mstevanin4/ECU_STM_V1/bimmerTuning/pinout_BMW_diag_connector.png

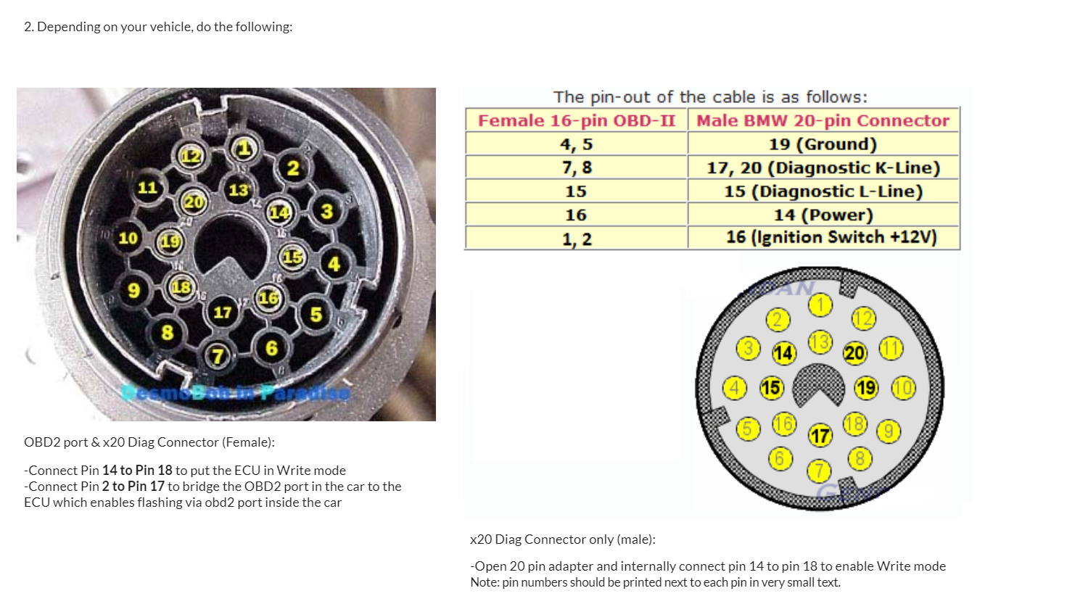
bimmerTuning/pinout_BMW_diag_connector.png
