mstevanin4/ECU_STM_V1/bimmerTuning/pinout_MS41_for_bench_flash.png

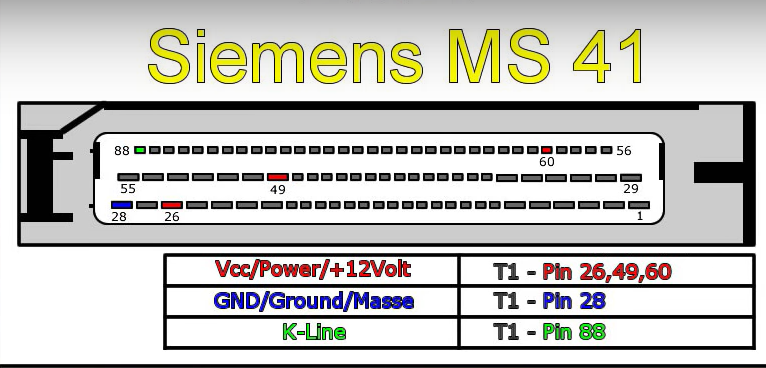
bimmerTuning/pinout_MS41_for_bench_flash.png
