mstevanin4/ECU_STM_V1/bimmerTuning/pinout_OBD2.png

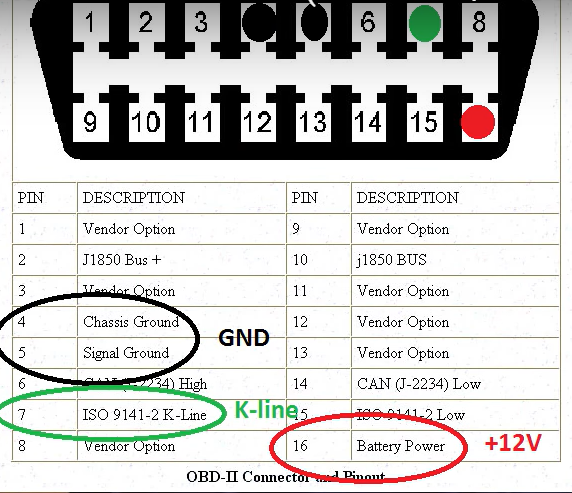
bimmerTuning/pinout_OBD2.png
