mstevanin4/ECU_STM_V1/STM2_ECU/HW/documentation/flyer.bmp

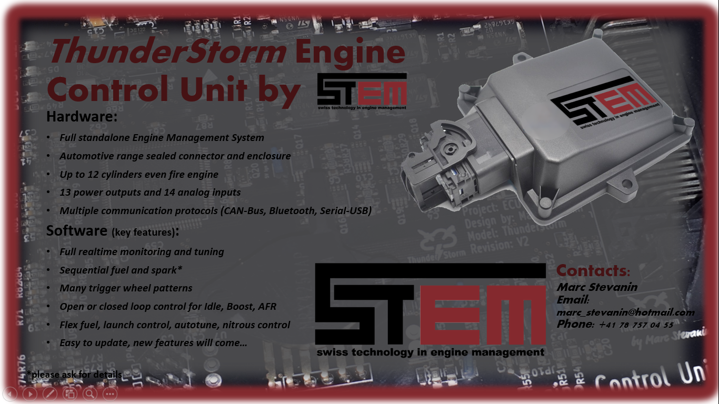
STM2_ECU/HW/documentation/flyer.bmp
