mstevanin4/ECU_STM_V1/STM2_ECU/HW/documentation/Sans titre.png

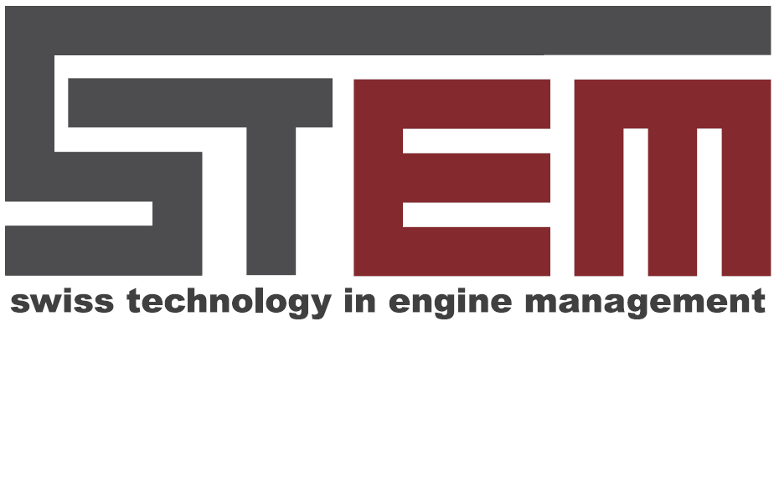
STM2_ECU/HW/documentation/Sans titre.png
