mstevanin4/ECU_STM_V1/STM2_ECU/HW/picture/20180507_184302.jpg

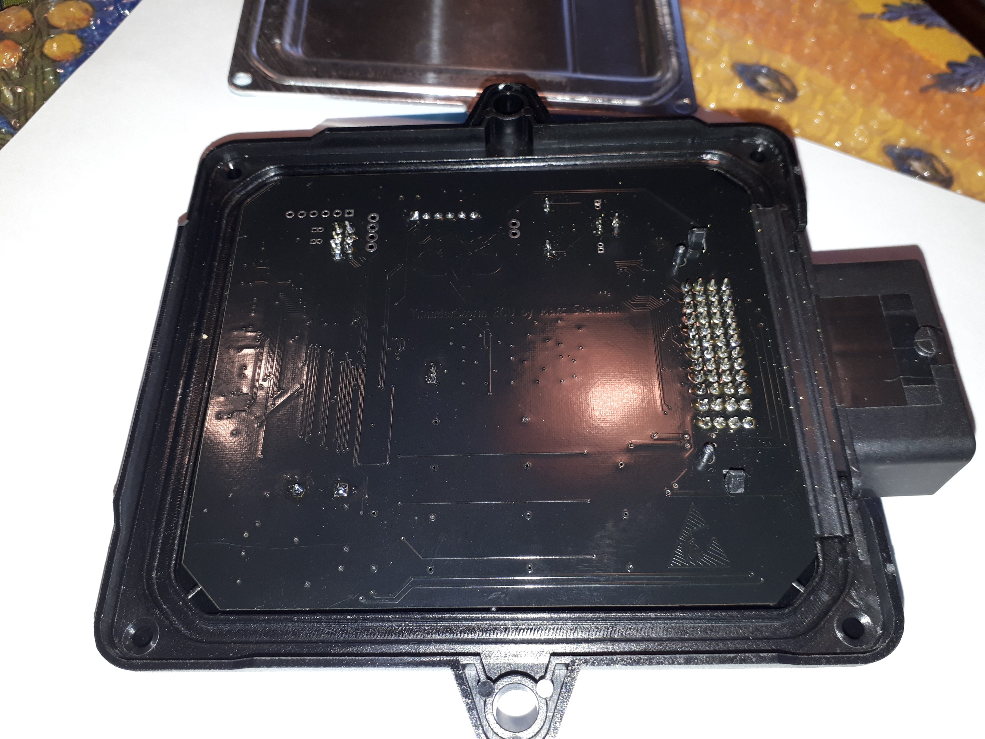
STM2_ECU/HW/picture/20180507_184302.jpg
