mstevanin4/ECU_STM_V1/STM2_ECU/HW/Trigger_improvement.png

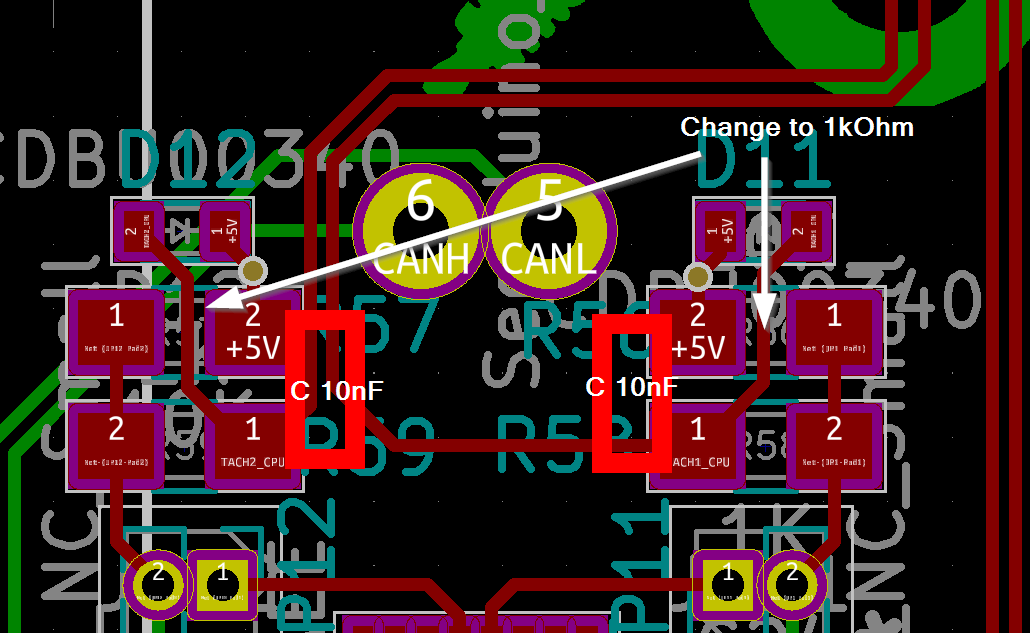
STM2_ECU/HW/Trigger_improvement.png
