mstevanin4/ECU_STM_V1/STM2_ECU/HW/man_files/BOM_SZ2U.xls

Sheet: Read me
Note:
1. The blue fields must be fulfilled before uploaded. Filling out the BOM Completely will facilitate the quotation.
2. Reference Link from Digikey, Mouser, Farnell,Arrow, Avenet or ShenZhen2U.com is strongly suggested. If the part are available in our shop, please copy the link in the "Reference Link".
3.Component values should be clear e.g. 100R, 100K, 100M etc, and not just "100" printed as the value.
4.BOMs must clearly identify parts are supplied by either "Customer", "SZ2U" or "No Need".
5.If you are going to sourcing and assembling with us,component must be supplied with extra (spare) parts to allow for losses and wastage. 5% extra spares is a reasonable guideline.Surplus parts will be returned.
6.We will respond with your BOM pricing within two to four working days of receiving it.Depending on suppliers responding with pricing for rare or bespoke items,so we cannot give a precise turnaround time for quote.
7.We are not taking any responsibility for your BOM files, please make sure that they are clear and accurate.
Blue fields | Should be filled out by customer.
Green fields | will be calculated and filled autolly.
After fulfilled and checked by yourself,save this file as .xls or .xlsx (not PDF), and send it to pcb@shenzhen2u.com

Sheet: BOM
 |  |  |  | BOM & Assembly Template
 | Custom Name: | Marc Stevanin |  |  | Project Name: | ECU_STM |  |  | Sale: | Iver
 | Company Name: | Atelier Stevanin |  |  | BOM Quantity: | 1 |  |  | Email: | pcb@shenzhen2u.com
 | Address: | Ruelle de la Laiterie 2 |  |  |  |  |  |  | Quotation ID:
 |  | 1438 Mathod |  |  |  |  |  |  | Date: | 2018-03-30
 | Email: | marc_stevanin@hotmail.com |  |  | Quotation for: | BOM & Assembly |  |  | Currency: | EUR
 | Tel: | 41787570455
# | Part ID / Reference | Manufacturer | Manufacture Part Number | Description | Value | Package | Reference Link | Alternate | THT/SMD/ No-Lead Pads | Pins / Pads | Quantity per BOM | Spare (%) | Need Qty | supplied by
1 | C22, C23 |  | GRM1885C1H102JA01D |  | 1nF | 0603 | https://www.mouser.ch/ProductDetail/Murata-Electronics/GRM1885C1H102JA01D | - | SMD | 2 | 2 | 5 | 3 | Customer
2 | C3, C4, C7, C8, C11, C12, C14, C15, C24, C25, C26, C27, C30, C31, C36, C37, C44, C51, C50, C45, C55, C54, C35, C34, C43, C42, C59, C60, C61, C62, C63, C58 |  | GRM188R71H104KA93D |  | 100nF | 0603 | https://www.mouser.ch/ProductDetail/Murata-Electronics/GRM188R71H104KA93D | - | SMD | 2 | 32 | 5 | 37 | SZ2U
3 | C32, C40, C41, C48, C53, C52, C49, C57, C56, C39, C38, C47, C46 |  | GRM188F51H224ZA01J |  | 220nF | 0603 | https://www.mouser.ch/ProductDetail/Murata-Electronics/GRM188F51H224ZA01J | - | SMD | 2 | 13 | 5 | 18 | No Need
4 | C33 |  | GRM188R71H472KA01D |  | 4nF7 | 0603 | https://www.mouser.ch/ProductDetail/Murata-Electronics/GRM188R71H472KA01D |  | SMD | 2 | 1 | 5 | 6
5 | C13 |  | UMK325AB7106KMHT |  | 10µF | 1210 | https://www.mouser.ch/ProductDetail/Taiyo-Yuden/UMK325AB7106KMHT |  | SMD | 2 | 1 | 5 | 6
6 | C1, C2, C6, C9, C5, C10, C21, C28 |  | GRM188R61H105KAALD |  | 1µF | 0603 | https://www.mouser.ch/ProductDetail/Murata-Electronics/GRM188R61H105KAALD |  | SMD | 2 | 8 | 5 | 13
7 | C16 |  | TMK325ABJ476MM-T |  | 47uF | 1210 | https://www.mouser.ch/ProductDetail/Taiyo-Yuden/TMK325ABJ476MM-T |  | SMD | 2 | 1 | 5 | 6
8 | C17, C18, C19, C20 |  | GCD188R71H103KA01D |  | 10nF | 0603 | https://www.mouser.ch/ProductDetail/Murata-Electronics/GCD188R71H103KA01D |  | SMD | 2 | 4 | 5 | 9
9 | D2 |  | B130-13-F |  | B130-13-F | SMA | https://www.mouser.ch/ProductDetail/Diodes-Incorporated/B130-13-F?qs=sGAEpiMZZMv2Edv6Dhsn9lNHICxp2ggl |  | SMD | 2 | 1 | 5 | 6
10 | D3 |  | 3SMAJ5919B-TP |  | 3SMAJ5919B-TP |  | https://www.mouser.ch/Search/Refine.aspx?Keyword=3SMAJ5919B-TP |  | SMD | 2 | 1 | 5 | 6
11 | D4, D5, D6 |  | SML-211UTT86 |  | SML-211UTT86 |  | https://www.mouser.ch/ProductDetail/ROHM-Semiconductor/SML-211UTT86 |  | SMD | 2 | 3 | 5 | 8
12 | Q20 |  | CSTCE16M0V53C-R0 |  | 16Mhz | . | https://www.mouser.ch/ProductDetail/Murata-Electronics/CSTCE16M0V53C-R0 |  | SMD | 2 | 1 | 5 | 6
13 | R10, R11, R29, R31, R37, R41, R35, R43, R47, R62, R63, R67, R69, R65 |  | ESR03EZPF1001 |  | 1K | 0603 | https://www.mouser.ch/ProductDetail/ROHM-Semiconductor/ESR03EZPF1001 |  | SMD | 2 | 13 | 5 | 18
14 | R48, R49 |  | CRCW0603680RFKEA |  | 680U | 0603 |  |  | SMD | 2 | 2 | 5 | 7
15 | R1, R3, R5, R7, R21, R23, R25, R15, R17, R19, R13, R58, R59 |  | CRCW08051K00FKEA |  | 1K | 0805 |  |  | SMD | 2 | 10 | 5 | 15
16 | R2, R4, R6, R8, R22, R24, R26, R16, R18, R20, R9, R12, R14, R30, R32, R38, R42, R36, R44 |  | CRCW0603100KFKEA |  | 100K | 0603 |  |  | SMD | 2 | 19 | 5 | 24
17 | R60, R68, R72, R73, R78, R81, R80, R79, R85, R84, R71, R70, R77, R76, R61, R27, R28 |  | CRCW0603470RFKEA |  | 470U | 0603 |  |  | SMD | 2 | 17 | 5 | 22
18 | R83, R82, R75, R74 |  | CRCW06032K49FKEA |  | 2K49 | 0603 |  |  | SMD | 2 | 4 | 5 | 9
19 | R52, R53, R54, R55, R50, R51, R56, R57 |  | CRCW080510K0JNEA |  | 10K | 0805 |  |  | SMD | 2 | 8 | 5 | 13
20 | R66 |  | CRCW06033K90FKEA |  | 3K9 | 0603 |  |  | SMD | 2 | 1 | 5 | 6
21 | R86 |  | RCG06031M00FKEA |  | 1M | 0603 |  |  | SMD | 2 | 1 | 5 | 6
22 | R87 |  | CRCW06033K30FKEA |  | 3K3 | 0603 |  |  | SMD | 2 | 1 | 5 | 6
23 | R64 |  | CRCW06032K20FKEA |  | 2K2 | 0603 |  |  | SMD | 2 | 1 | 5 | 6
24 | R33, R34, R40, R45, R39, R46 |  | CRGH2512J15R |  | 15R | 2512 | https://www.mouser.ch/ProductDetail/TE-Connectivity-Neohm/CRGH2512J15R |  | SMD | 2 | 6 | 5 | 11
25 | Q1, Q2, Q3, Q4, Q6, Q7, Q8, Q9, Q10, Q11, Q12 |  | VND5N07-E |  | VND5N07-E | TO-252 | https://www.mouser.ch/ProductDetail/STMicroelectronics/VND5N07-E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 |  | SMD | 3 | 11 | 5 | 16
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
505
506
507
508
509
510
511
512
513
514
515
516
517
518
519
520
521
522
523
524
525
526
527
528
529
530
531
532
533
534
535
536
537
538
539
540
541
542
543
544
545
546
547
548
549
550
551
552
553
554
555
556
557
558
559
560
561
562
563
564
565
566
567
568
569
570
571
572
573
574
575
576
577
578

Sheet: Assembly Auto Quotation
Assembly Auto Quotation
Quantity of pins/pads per PCBA
THT Pins | SMD Pads | No-Lead Pads
0 | 541 | 0
 |  |  |  | Currency: | USD
PCBA Quantity | 10 | 50 | 100 | 500 | 1000
by Machine | 699.99 | 770.49 | 1040.99 | 3204.99 | 5909.99
by Hand | 197.29 | 846.49 | 1657.99 | 8149.99 | 16264.99

Sheet: PCB Information
 |  |  | PCB Information
Material | Layer | X dimension (cm) | Y dimension (cm) | Thickness | Cooper | Solder Mask | Silk Screen | Surface finish | Other
FR4 | 4 |  |  | 0.6mm | 1oz | Green | White | HASA
