mstevanin4/ECU_STM_V1/STM2_ECU/HW/man_files/ECU_STM2_BOM.xls

 |  |  | ELECTRONIC BILL OF MATERIAL |  |  |  |  |  |  |  | Edition:A
 |  |  | Project name : | ECU_STM2
 |  |  | Project number : | V1
 |  |  | HISTORY:
 |  |  | Edition | Date | Reason: |  |  |  |  |  | Approval:
 |  |  | A | DRAFT | Initial design
Qty. | NAME | DESCRIPTION | VALUE | TOLERANCE | MAX_VOLTAGE | PACKAGE | MANUFACTURER | REF-MANUFACTURER | OPERATING_TEMP_RANGE | ROHS | OBSERVATION | MOUSER PART No | MOUSER PRICE (x1) | MOUSER PRICE (x10) | PRICE for 1 ECU | PRICE for (x) ECU
 |  |  |  |  |  |  |  |  |  |  |  |  |  |  |  | 20
1 | PCB | PCB |  |  |  |  |  |  |  | ROHS |  |  | 9 | 9 | 9 | 120.00
2 | BARO, MAP | MAP SENSOR | MPX4250AP | . |  |  | NXP | MPX4250AP |  | ROHS | . |  |  |  |  | 0
2 | C22, C23 | CERAMIC SMD CAPACITOR TYPE GRM39 (X7R) | 1nF | 10% | 50V | 0603 | MURATA | GRM1885C1H102JA01D |  | ROHS | . | 81-GRM39C102J50 |  |  | 0 | 0.000
32 | C3, C4, C7, C8, C11, C12, C14, C15, C24, C25, C26, C27, C30, C31, C36, C37, C44, C51, C50, C45, C55, C54, C35, C34, C43, C42, C59, C60, C61, C62, C63, C58 | CERAMIC SMD CAPACITOR TYPE GRM188 (X7R) | 100nF | 10% | 50V | 0603 | MURATA | GRM188R71H104KA93D |  | ROHS | . | 81-GRM39X104K50D | 0,094 | 0,025 | #VALUE! | #VALUE!
13 | C32, C40, C41, C48, C53, C52, C49, C57, C56, C39, C38, C47, C46 | CERAMIC SMD CAPACITOR TYPE GRM39 (Y5V) | 220nF |  |  | 0603 |  | GRM188F51H224ZA01J |  | ROHS |  |  |  |  | 0 | 0.000
1 | C33 | CERAMIC SMD CAPACITOR TYPE GRM39 (X7R) | 4nF7 | 10% | 50V | 0603 | MURATA | .GRM188R71H472KA01D |  | ROHS | . | 81-GRM39X472K50D | 0,094 | 0,015 | #VALUE! | #VALUE!
1 | C13 | CERAMIC SMD CAPACITOR TYPE GRM39 (X7R) | 10µF | 10% | 50V | 1210 |  | UMK325AB7106KMHT |  | ROHS |  | 963-UMK325AB7106KMHT | 1,03 | 0,644 | #VALUE! | #VALUE!
8 | C1, C2, C6, C9, C5, C10, C21, C28 | CERAMIC SMD CAPACITOR TYPE GRM39 (Y5V) | 1µF | 10% | 50V | 0603 | MURATA | GRM188R61H105KAALD |  | ROHS | . | 81-GRM188R61H105KALD | 0,17 | 0,086 | #VALUE! | #VALUE!
1 | C16 | SMD CAPACITOR | 47uF |  |  | 1210 |  | TMK325ABJ476MM-T |  | ROHS | . | 963-TMK325ABJ476MM-T |  |  | 0 | #VALUE!
4 | C17, C18, C19, C20 | CERAMIC SMD CAPACITOR TYPE GRM39 (X7R) | 10nF | 10% | 50V | 0603 | MURATA | GRM188R71H103KA01D |  | ROHS | . | 81-GRM39X103K50D | 0,094 | 0,013 | #VALUE! | #VALUE!
1 | D1 | TRANSORB | ERZ-V14D220 | . |  |  |  |  |  | ROHS | . |  |  |  | 0 | 0.000
1 | D2 | SCHOTTKY DIODE | B130-13-F | . |  | SMA |  |  |  |  | . |  |  |  | 0 | 0.000
1 | D3 | SMD ZENER DIODE | 3SMAJ5919B-TP |  |  |  |  |  |  |  |  |  |  |  | 0 | 0.000
3 | D4, D5, D6 | SMD LED | SML-211UTT86 |  |  |  |  |  |  |  |  |  |  |  | 0 | 0.000
1 | JP1, JP2, JP3, JP4, JP9, JP10, JP11, JP12 | VERTICAL BAR MALE-MALE PITCH 1.27mm | M50-3532042 | . |  |  |  |  |  |  |  |  |  |  | 0 | 0
8 | Jumpers | Jumper 1.27mm | M50-2030005 | .
1 | Q20 | Resonnator 16Mhz | 16Mhz | . |  | . | MURATA | CSTCE16M0V53C-R0 |  | ROHS | . | 81-CSTCE16M0V53C-R0 | 0,538 | 0,407 | #VALUE! | #VALUE!
13 | R10, R11, R29, R31, R37, R41, R35, R43, R47, R62, R63, R67, R69, R65 | SMD RESISTOR (0603) | 1K | 1% |  | 0603 |  | ESR03EZPF1001 |  | ROHS | . | 755-ESR03EZPF1001 |  |  | 0 | 0.000
2 | R48, R49 | SMD RESISTOR (0603) | 680U | 1% |  | 0603 | VISHAY | CRCW0603680RFKEA |  | ROHS | . | 71-CRCW0603-680-E3 | 0,094 | 0,041 | #VALUE! | #VALUE!
10 | R1, R3, R5, R7, R21, R23, R25, R15, R17, R19, R13, R58, R59 | SMD RESISTOR (0805) | 1K | 1% |  | 0805 | VISHAY | CRCW08051K00FKEA |  | ROHS | . | 71-CRCW0805-1.0K-E3 | 0,094 | 0,046 | #VALUE! | #VALUE!
19 | R2, R4, R6, R8, R22, R24, R26, R16, R18, R20, R9, R12, R14, R30, R32, R38, R42, R36, R44 | SMD RESISTOR (0603) | 100K | 1% |  | 0603 | VISHAY | CRCW0603100KFKEA |  | ROHS | . | 71-CRCW0603-100K-E3 | 0,094 | 0,041 | #VALUE! | #VALUE!
14 | R60, R68, R72, R73, R78, R81, R80, R79, R85, R84, R71, R70, R77, R76 | SMD RESISTOR (0603) | 470U | 1% |  | 0603 | VISHAY | CRCW0603470RFKEA |  | ROHS | . | 71-CRCW0603-470-E3 | 0,094 | 0,041 | #VALUE! | #VALUE!
4 | R83, R82, R75, R74 | SMD RESISTOR (0603) | 2K49 | 1% |  | 0603 | VISHAY | CRCW06032K49FKEA |  | ROHS | . | 71-CRCW0603-2.49K-E3 | 0,094 | 0,041 | #VALUE! | #VALUE!
8 | R52, R53, R54, R55, R50, R51, R56, R57 | SMD RESISTOR (0805) | 10K | 1% |  | 0805 |  | CRCW080510K0JNEA |  |  | . | 71-CRCW0805J-10K-E3 |  |  | 0 | 0.000
1 | R66 | SMD RESISTOR (0603) | 3K9 | 1% |  | 0603 | VISHAY | CRCW06033K90FKEA |  | ROHS | . | 71-CRCW0603-3.9K-E3 | 0,094 | 0,041 | #VALUE! | #VALUE!
1 | R86 | SMD RESISTOR (0603) | 1M | 1% |  | 0603 | VISHAY | RCG06031M00FKEA |  | ROHS | . | 71-RCG06031M00FKEA | 0,094 | 0,041 | #VALUE! | #VALUE!
1 | R87 | SMD RESISTOR (0603) | 3K3 | 1% |  | 0603 |  | CRCW06033K30FKEA |  |  |  | 71-CRCW0603-3.3K-E3 |  |  | 0 | 0.000
1 | R64 | SMD RESISTOR (0603) | 2K2 | 1% |  | 0603 | VISHAY | CRCW06032K20FKEA |  | ROHS | . | 71-CRCW0603-2.2K-E3 | 0,094 | 0,041 | #VALUE! | #VALUE!
6 | R33, R34, R40, R45, R39, R46 | SMD RESISTOR (2512) | 15R | 1% |  | 2512 | TE | CRGH2512J15R |  | ROHS | . | 279-CRGH2512J15R | 0,979 | 0,409 | #VALUE! | #VALUE!
11 | Q1, Q2, Q3, Q4, Q6, Q7, Q8, Q9, Q10, Q11, Q12 | OMNIFET 2 | VND5N07-E | . |  | TO-252 | ST | VND5N07-E |  | ROHS | . | 511-VND5N07-E | 1,61 | 1,37 | #VALUE! | #VALUE!
1 | U2 | IC SENSOR INTERFACE VARIABLE RELUCTANCE | MAX9926UAEE | . |  | QSOP16 | MAXIM | MAX9926UAEE |  | ROHS | . | 700-MAX9926UAEE | 8,53 | 8,11 | #VALUE! | #VALUE!
6 | Q14, Q15, Q16, Q17, Q18, Q19 | GATE DRIVER LOW SIDE 1CH | TC1413NEUA | . |  | MSOP8 | MICROCHIP | TC1413NEUA |  | ROHS | . | 579-TC1413NEUA | 1,7 | 1,41 | #VALUE! | #VALUE!
1 | IC1 | ATmega Microcontroller IC 8-Bit 16MHz | ATMEGA2560-16AUR | . |  | TQFP100 | ATMEL | ATMEGA2560-16AUR |  | ROHS | . | 556-ATMEGA2560-16AU | 11,5 | 11,5 | #VALUE! | #VALUE!
3 | U9, U10, U11 | TVS ARRAY ESD 4 INPUTS | SP724AHTG | . |  | SOT23-6 | LITTELFUSE | SP724AHTG |  | ROHS | . | 576-SP724AHTG | 1,6 | 1,29 | #VALUE! | #VALUE!
1 | Q5 | DUAL OMNIFET 3 | VNLD5090-E | . |  | SO-8 | ST | VNLD5090-E |  | ROHS | . | 511-VNLD5090-E | 1,49 | 1,26 | #VALUE! | #VALUE!
1 | U8 | LDO 3V3 | MCP1703A-3302E/DB |  |  |  |  | MCP1703A-3302E/DB |  |  |  | 579-MCP1703AT3302EDB
1 | D8 | DIODE | B0540WS-7
1 | U1 | LDO 5V | LM2940IMP-5.0/NOPBCT-ND |  |  |  |  | LM2940IMP-5.0/NOPBCT-ND |  |  |  | 926-LM2940IMP5.0NOPB
1 | P2 | Molex Connector 48Pin |  | . |  | . |  |  |  |  | . |  |  | 15,32 | 0 | #VALUE!
1 | CASE |  |  |  |  | . |  |  |  |  |  |  |  | 20,31 | 0 | #VALUE!
1 | BTOOTH | BLUETOOTH MODULE | HC-06 | . |  | . | JY-MCU | HC-06 |  |  | .
 |  |  |  |  |  |  |  |  |  |  |  | TOTAL without enclosure (EURO) |  |  | #VALUE! | #VALUE!
 |  |  |  |  |  |  |  |  |  |  |  | TOTAL with enclosure (EURO) |  |  | #VALUE! | #VALUE!
