mstevanin4/ECU_STM_V1/STM2_ECU/HW/man_files/ECU_STM2_BOM_for_manufacturer.xls

 |  |  | ELECTRONIC BILL OF MATERIAL
 |  |  | Project name : | ECU_STM2
 |  |  | Project number : | V2
 |  |  | HISTORY:
 |  |  | Edition | Date | Reason:
 |  |  | A | DRAFT
Qty. | NAME | DESCRIPTION | VALUE | PACKAGE | REF-MANUFACTURER | MOUSER PART No
2 | C22, C23 | CERAMIC SMD CAPACITOR TYPE GRM39 (X7R) | 1nF | 0603 | GRM1885C1H102JA01D | 81-GRM39C102J50
32 | C3, C4, C7, C8, C11, C12, C14, C15, C24, C25, C26, C27, C30, C31, C36, C37, C44, C51, C50, C45, C55, C54, C35, C34, C43, C42, C59, C60, C61, C62, C63, C58 | CERAMIC SMD CAPACITOR TYPE GRM188 (X7R) | 100nF | 0603 | GRM188R71H104KA93D | 81-GRM39X104K50D
13 | C32, C40, C41, C48, C53, C52, C49, C57, C56, C39, C38, C47, C46 | CERAMIC SMD CAPACITOR TYPE GRM39 (Y5V) | 220nF | 0603 | GRM188F51H224ZA01J | 81-GRM188F51H224ZA1J
1 | C33 | CERAMIC SMD CAPACITOR TYPE GRM39 (X7R) | 4nF7 | 0603 | GRM188R71H472KA01D | 81-GRM39X472K50D
1 | C13 | CERAMIC SMD CAPACITOR TYPE GRM39 (X7R) | 10µF | 1210 | UMK325AB7106KMHT | 963-UMK325AB7106KMHT
8 | C1, C2, C6, C9, C5, C10, C21, C28 | CERAMIC SMD CAPACITOR TYPE GRM39 (Y5V) | 1µF | 0603 | GRM188R61H105KAALD | 81-GRM188R61H105KALD
1 | C16 | SMD CAPACITOR | 47uF | 1210 | TMK325ABJ476MM-T | 963-TMK325ABJ476MM-T
4 | C17, C18, C19, C20 | CERAMIC SMD CAPACITOR TYPE GRM39 (X7R) | 10nF | 0603 | GCD188R71H103KA01D | 81-GCD188R71H103KA1D
1 | D2 | SCHOTTKY DIODE | B130-13-F | SMA | B130-13-F | 621-B130-F
1 | D3 | SMD ZENER DIODE | 3SMAJ5919B-TP |  | 3SMAJ5919B-TP | 833-3SMAJ5919B-TP
3 | D4, D5, D6 | SMD LED | SML-211UTT86 |  | SML-211UTT86 | 755-SML-211UTT86
1 | Q20 | Resonnator 16Mhz | 16Mhz | . | CSTCE16M0V53C-R0 | 81-CSTCE16M0V53C-R0
13 | R10, R11, R29, R31, R37, R41, R35, R43, R47, R62, R63, R67, R69, R65 | SMD RESISTOR (0603) | 1K | 0603 | ESR03EZPF1001 | 755-ESR03EZPF1001
2 | R48, R49 | SMD RESISTOR (0603) | 680U | 0603 | CRCW0603680RFKEA | 71-CRCW0603-680-E3
10 | R1, R3, R5, R7, R21, R23, R25, R15, R17, R19, R13, R58, R59 | SMD RESISTOR (0805) | 1K | 0805 | CRCW08051K00FKEA | 71-CRCW0805-1.0K-E3
19 | R2, R4, R6, R8, R22, R24, R26, R16, R18, R20, R9, R12, R14, R30, R32, R38, R42, R36, R44 | SMD RESISTOR (0603) | 100K | 0603 | CRCW0603100KFKEA | 71-CRCW0603-100K-E3
17 | R60, R68, R72, R73, R78, R81, R80, R79, R85, R84, R71, R70, R77, R76, R61, R27, R28 | SMD RESISTOR (0603) | 470U | 0603 | CRCW0603470RFKEA | 71-CRCW0603-470-E3
4 | R83, R82, R75, R74 | SMD RESISTOR (0603) | 2K49 | 0603 | CRCW06032K49FKEA | 71-CRCW0603-2.49K-E3
8 | R52, R53, R54, R55, R50, R51, R56, R57 | SMD RESISTOR (0805) | 10K | 0805 | CRCW080510K0JNEA | 71-CRCW0805J-10K-E3
1 | R66 | SMD RESISTOR (0603) | 3K9 | 0603 | CRCW06033K90FKEA | 71-CRCW0603-3.9K-E3
1 | R86 | SMD RESISTOR (0603) | 1M | 0603 | RCG06031M00FKEA | 71-RCG06031M00FKEA
1 | R87 | SMD RESISTOR (0603) | 3K3 | 0603 | CRCW06033K30FKEA | 71-CRCW0603-3.3K-E3
1 | R64 | SMD RESISTOR (0603) | 2K2 | 0603 | CRCW06032K20FKEA | 71-CRCW0603-2.2K-E3
6 | R33, R34, R40, R45, R39, R46 | SMD RESISTOR (2512) | 15R | 2512 | CRGH2512J15R | 279-CRGH2512J15R
11 | Q1, Q2, Q3, Q4, Q6, Q7, Q8, Q9, Q10, Q11, Q12 | OMNIFET 2 | VND5N07-E | TO-252 | VND5N07-E | 511-VND5N07-E
1 | U2 | IC SENSOR INTERFACE VARIABLE RELUCTANCE | MAX9926UAEE | QSOP16 | MAX9926UAEE+ | 700-MAX9926UAEE
6 | Q14, Q15, Q16, Q17, Q18, Q19 | GATE DRIVER LOW SIDE 1CH | TC1413NEUA | MSOP8 | TC1413NEUA | 579-TC1413NEUA
1 | IC1 | ATmega Microcontroller IC 8-Bit 16MHz | ATMEGA2560-16AUR | TQFP100 | ATMEGA2560-16AU | 556-ATMEGA2560-16AU
3 | U9, U10, U11 | TVS ARRAY ESD 4 INPUTS | SP724AHTG | SOT23-6 | SP724AHTG | 576-SP724AHTG
1 | Q5 | DUAL OMNIFET 3 | VNLD5090-E | SO-8 | VNLD5090-E | 511-VNLD5090-E
5 | D7, D9, D10, D11, D12 | DIODE SCHOTTKY | CDBU00340 |  | CDBU00340 | 750-CDBU00340 (https://www.mouser.ch/ProductDetail/Comchip-Technology/CDBU00340)
1 | D8 | DIODE | B0540WS-7 |  | B0540WS-7 | 621-B0540WS-7
1 | U1 | LDO 5V | LM2940IMP-5.0/NOPBCT-ND |  | LM2940IMP-5.0/NOPB | 926-LM2940IMP5.0NOPB
