mstevanin4/ECU_STM_V1/STM2_ECU/HW/man_files/Panier_janv.10_0120.xls

PANIER
Ceci n'est pas une facture
10-janv.-18 13:20:34
 | N° Mouser | N° de fab. | Fabricant | N° client | Description | RoHS | Cycle de vie | Qté. | Prix (CHF) | Ext. : (CHF)
1 | 841-MPX4250AP | MPX4250AP | NXP |  | Capteurs de pression enfichables PRES SEN INTEG 250KPA | Conforme à RoHS par dispense |  | 1 | 14.25 fr. | 14.25 fr.
2 | 81-GRM39C102J50 | GRM1885C1H102JA01D | Murata |  | Condensateurs céramique multicouches MLCC - CMS 0603 1000pF 50volts C0G 5% | RoHS : conforme |  | 2 | 0.098 fr. | 0.20 fr.
3 | 81-GRM39X104K50D | GRM188R71H104KA93D | Murata |  | Condensateurs céramique multicouches MLCC - CMS 0603 0.1uF 50volts X7R 10% | RoHS : conforme | NRND | 32 | 0.083 fr. | 2.66 fr.
4 | 81-GRM188F51H224ZA1J | GRM188F51H224ZA01J | Murata |  | Condensateurs céramique multicouches MLCC - CMS 0.22uF 50Volts Y5V -20% to 80% | RoHS : conforme | NRND | 13 | 0.121 fr. | 1.57 fr.
5 | 81-GRM39X472K50D | GRM188R71H472KA01D | Murata |  | Condensateurs céramique multicouches MLCC - CMS 0603 4700pF 50volts X7R 10% | RoHS : conforme | NRND | 1 | 0.098 fr. | 0.10 fr.
6 | 963-UMK325AB7106KMHT | UMK325AB7106KMHT | Taiyo Yuden |  | Condensateurs céramique multicouches MLCC - CMS 10uF 50V X7R +/-10% 1210 AEC-Q200 | RoHS : conforme |  | 1 | 1.02 fr. | 1.02 fr.
7 | 81-GRM188R61H105KALD | GRM188R61H105KAALD | Murata |  | Condensateurs céramique multicouches MLCC - CMS 0603 1uF 50volts X5R 10% | RoHS : conforme | NRND | 8 | 0.225 fr. | 1.80 fr.
8 | 963-TMK325ABJ476MM-T | TMK325ABJ476MM-T | Taiyo Yuden |  | Condensateurs céramique multicouches MLCC - CMS 47uF 25V X5R +/-20% 1210 Gen Purp | RoHS : conforme | Nouveau chez Mouser | 1 | 1.28 fr. | 1.28 fr.
9 | 81-GCD188R71H103KA1D | GCD188R71H103KA01D | Murata |  | Condensateurs céramique multicouches MLCC - CMS 0603 0.01uF 50volts X7R 10% | RoHS : conforme |  | 4 | 0.108 fr. | 0.43 fr.
10 | 667-ERZ-V14D220 | ERZ-V14D220 | Panasonic |  | Varistances 22V 10A CLAMP | RoHS : conforme |  | 1 | 0.528 fr. | 0.53 fr.
11 | 621-B130-F | B130-13-F | Diodes Incorporated |  | Diodes et redresseurs Schottky 30V 1A | Conforme à RoHS par dispense |  | 1 | 0.332 fr. | 0.33 fr.
12 | 833-3SMAJ5919B-TP | 3SMAJ5919B-TP | Micro Commercial Components (MCC) |  | Diodes Zener 3W 5.6V | RoHS : conforme |  | 1 | 0.508 fr. | 0.51 fr.
13 | 755-SML-211UTT86 | SML-211UTT86 | ROHM Semiconductor |  | DEL standard - CMS INDIUM RED SMD TRANS LENS | RoHS : conforme | NRND | 3 | 0.371 fr. | 1.11 fr.
14 | 855-M50-3532042 | M50-3532042 | Harwin |  | Embases et logements de câbles 20 WAY SIL VERT PC TAIL P/HDR | RoHS : conforme | Nouveau produit | 2 | 0.626 fr. | 1.25 fr.
15 | 855-M50-2030005 | M50-2030005 | Harwin |  | Embases et logements de câbles TOP JUMPER SKT W/ HANDLE, BLUE/GOLD | RoHS : conforme |  | 8 | 0.332 fr. | 2.66 fr.
16 | 81-CSTCE16M0V53C-R0 | CSTCE16M0V53C-R0 | Murata |  | Résonateurs 16Mhz 0.5% 15pF | RoHS : conforme |  | 1 | 0.636 fr. | 0.64 fr.
17 | 755-ESR03EZPF1001 | ESR03EZPF1001 | ROHM Semiconductor |  | Résistances à couches épaisses - CMS 0603 1Kohm 1% Anti Surge AEC-Q200 | RoHS : conforme | Nouveau produit | 13 | 0.101 fr. | 1.31 fr.
18 | 71-CRCW0603-680-E3 | CRCW0603680RFKEA | Vishay |  | Résistances à couches épaisses - CMS 1/10watt 680ohms 1% | Conforme à RoHS par dispense |  | 2 | 0.098 fr. | 0.20 fr.
19 | 71-CRCW0805-1.0K-E3 | CRCW08051K00FKEA | Vishay |  | Résistances à couches épaisses - CMS 1/8watt 1Kohms 1% 100ppm | Conforme à RoHS par dispense |  | 10 | 0.048 fr. | 0.48 fr.
20 | 71-CRCW0603-100K-E3 | CRCW0603100KFKEA | Vishay |  | Résistances à couches épaisses - CMS 1/10watt 100Kohms 1% | Conforme à RoHS par dispense |  | 19 | 0.043 fr. | 0.82 fr.
21 | 71-CRCW0603-470-E3 | CRCW0603470RFKEA | Vishay |  | Résistances à couches épaisses - CMS 1/10watt 470ohms 1% | Conforme à RoHS par dispense |  | 14 | 0.043 fr. | 0.60 fr.
22 | 71-CRCW0603-2.49K-E3 | CRCW06032K49FKEA | Vishay |  | Résistances à couches épaisses - CMS 1/10watt 2.49Kohms 1% | RoHS : conforme |  | 4 | 0.098 fr. | 0.39 fr.
23 | 71-CRCW0805J-10K-E3 | CRCW080510K0JNEA | Vishay |  | Résistances à couches épaisses - CMS 1/8watt 10Kohms 5% 200ppm | Conforme à RoHS par dispense |  | 8 | 0.098 fr. | 0.78 fr.
24 | 71-CRCW0603-3.9K-E3 | CRCW06033K90FKEA | Vishay |  | Résistances à couches épaisses - CMS 1/10watt 3.9Kohms 1% | Conforme à RoHS par dispense |  | 1 | 0.098 fr. | 0.10 fr.
25 | 71-RCG06031M00FKEA | RCG06031M00FKEA | Vishay |  | Résistances à couches épaisses - CMS .1watt 1Mohms 1% 0603 100ppm | RoHS : conforme |  | 1 | 0.098 fr. | 0.10 fr.
26 | 71-CRCW0603-3.3K-E3 | CRCW06033K30FKEA | Vishay |  | Résistances à couches épaisses - CMS 1/10watt 3.3Kohms 1% | Conforme à RoHS par dispense |  | 1 | 0.098 fr. | 0.10 fr.
27 | 71-CRCW0603-2.2K-E3 | CRCW06032K20FKEA | Vishay |  | Résistances à couches épaisses - CMS 1/10watt 2.2Kohms 1% | Conforme à RoHS par dispense |  | 1 | 0.098 fr. | 0.10 fr.
28 | 279-CRGH2512J15R | CRGH2512J15R | TE Connectivity |  | Résistances à couches épaisses - CMS CRGH2512 5% 15R 2W | RoHS : conforme |  | 6 | 1.01 fr. | 6.06 fr.
29 | 511-VND5N07-E | VND5N07-E | STMicroelectronics |  | MOSFET N-Ch 70V 5A OmniFET | RoHS : conforme |  | 11 | 1.41 fr. | 15.51 fr.
30 | 700-MAX9926UAEE | MAX9926UAEE+ | Maxim Integrated |  | Interface à détecteur Variable-Reluctance Interface à détecteur | RoHS : conforme |  | 1 | 9.21 fr. | 9.21 fr.
31 | 579-TC1413NEUA | TC1413NEUA | Microchip |  | Commandes de grilles 3A Sngl N-Inv | RoHS : conforme |  | 6 | 1.76 fr. | 10.56 fr.
32 | 556-ATMEGA2560-16AU | ATMEGA2560-16AU | Microchip |  | Microcontrôleurs 8 bits - MCU 256kB Flash 4kB EEPROM 86 I/O Pins | RoHS : conforme |  | 1 | 11.93 fr. | 11.93 fr.
33 | 576-SP724AHTG | SP724AHTG | Littelfuse |  | Suppresseurs ESD / diodes TVS 20V 2.2A 4 CHANNEL | RoHS : conforme |  | 3 | 1.67 fr. | 5.01 fr.
34 | 511-VNLD5090-E | VNLD5090-E | STMicroelectronics |  | Commandes de grilles OMNIFET III fully protect lo-side drvr | RoHS : conforme |  | 1 | 1.54 fr. | 1.54 fr.
35 | 579-MCP1703AT3302EDB | MCP1703AT-3302E/DB | Microchip |  | Régulateurs de tension LDO LOW Iq, High Vin LDO | RoHS : conforme |  | 1 | 0.665 fr. | 0.67 fr.
36 | 621-B0540WS-7 | B0540WS-7 | Diodes Incorporated |  | Diodes et redresseurs Schottky 0.5A 40V | RoHS : conforme |  | 1 | 0.401 fr. | 0.40 fr.
37 | 926-LM2940IMP5.0NOPB | LM2940IMP-5.0/NOPB | Texas Instruments |  | Régulateurs de tension LDO 1A LDO REG | RoHS : conforme |  | 1 | 2.06 fr. | 2.06 fr.
En soumettant votre commande, vous acceptez ces conditions. (https://www.mouser.ch/saleterms) |  |  |  |  |  |  |  |  | Total des articles : | 98.27 fr.
Les prix sont ceux de la date et de l'heure indiquées. |  |  |  |  |  |  |  |  | Frais d'expédition : | 0.00 fr.
 |  |  |  |  |  |  |  |  | Livraison des articles en attente de réapprovisionnement: | 0.00 fr.
