mstevanin4/ECU_STM_V1/EPS_Mazda/couvercle_DA_Mazda v1.stl

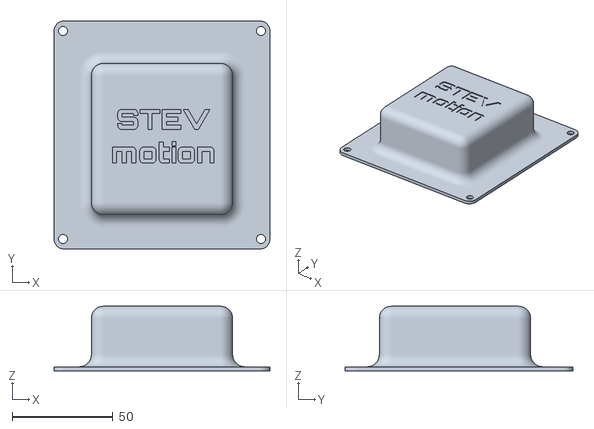
[picture p12: CAD file, 2024-08-07]
EPS_Mazda/couvercle_DA_Mazda v1.stl
107.0 x 113.0 x 32.0
