mstevanin4/ECU_STM_V1/EPS_Mazda/mazda_3d_parts/fuel_pump_holder.SLDPRT

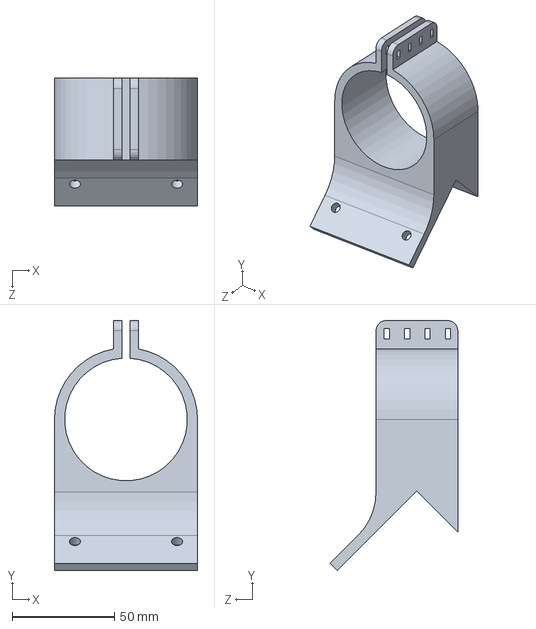
[picture p13: CAD file, 2024-08-07]
EPS_Mazda/mazda_3d_parts/fuel_pump_holder.SLDPRT
70.0 x 122.3 x 62.4 mm
