mstevanin4/ECU_STM_V1/piece_3d/poulie_vil_M52.SLDPRT

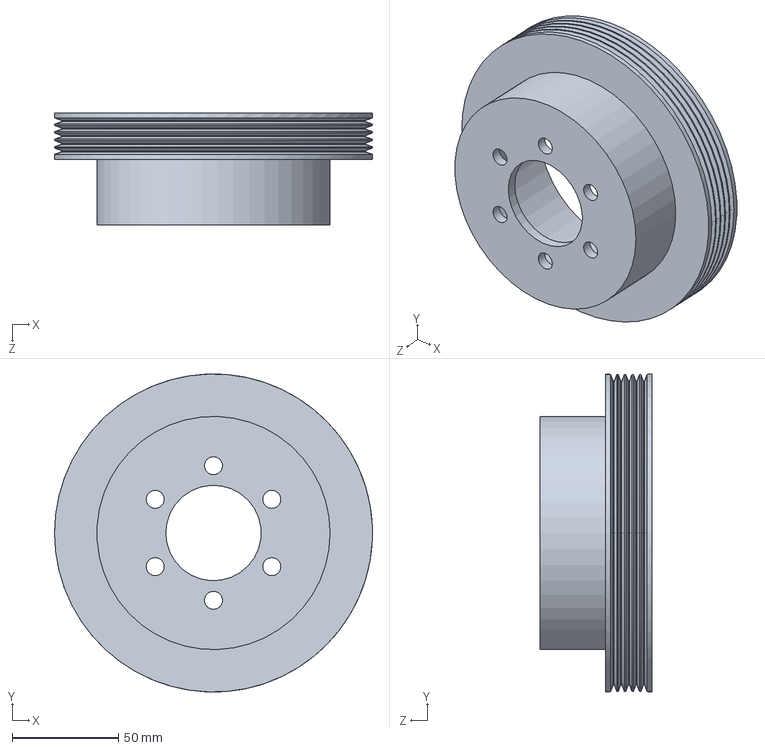
[picture p14: CAD file, 2024-08-07]
piece_3d/poulie_vil_M52.SLDPRT
150.0 x 149.9 x 53.0 mm
