mstevanin4/ECU_STM_V1/piece_3d/support_SC14_M52/plaque_bloc.SLDPRT

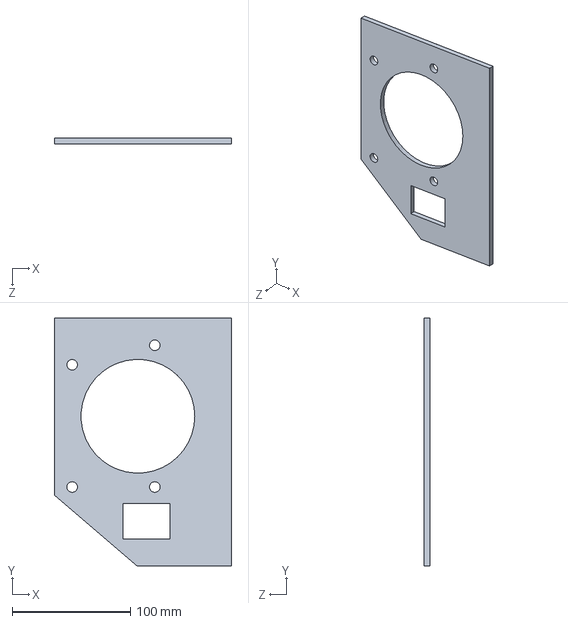
[picture p15: CAD file, 2024-08-07]
piece_3d/support_SC14_M52/plaque_bloc.SLDPRT
150.0 x 210.0 x 5.00 mm
