mstevanin4/ECU_STM_V1/STM2_ECU/SW/TestBench_SW/TestBench_STM_V1_old/reference/hardware/Pro/Case/MX5-PNP-Endplate.stl

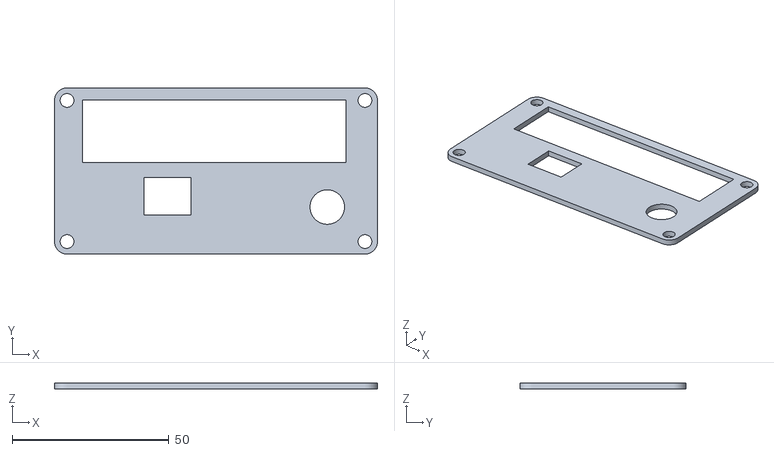
[picture p16: CAD file, 2018-05-02, an earlier design]
STM2_ECU/SW/TestBench_SW/TestBench_STM_V1_old/reference/hardware/Pro/Case/MX5-PNP-Endplate.stl
103.0 x 53.0 x 2.00
