mstevanin4/ECU_STM_V1/(list of files, cad)

Other CAD files:
STM2_ECU/SW/TestBench_SW/TestBench_STM_V1_old/reference/hardware/Pro/Case/MX5-PNP-Endplate.scad
STM2_ECU/SW/TestBench_SW/TestBench_STM_V1_old/reference/hardware/Pro/Case/PCB_locator.scad
EPS_Mazda/mazda_3d_parts/fuel_pump_holder.STL
STM2_ECU/SW/TestBench_SW/TestBench_STM_V1_old/reference/hardware/Pro/Case/MX5-PNP-Endplate.dxf
piece_3d/poulie_vil_M52.SLDDRW
piece_3d/support_SC14_M52/plaque_bloc.STL
