mstevanin4/ECU_STM_V1/bimmerTuning/WBABK72020ET52358_26.03.2024_104513_log.csv

Time (ms) | * Engine Speed (RPM) | * Vehicle Speed (km/h) | * Throttle Position (%) | * Engine Load (mg/stroke) | * Intake Air Temperature (°C) | * Coolant Temperature (°C) | * Ignition Angle (°BTDC) | * Fuel Injector Pulse Width (ms) | * Idle Air Control Valve (%) | * VANOS Angle (KW °) | * Battery Voltage (VDC) | * Lambda Integrator - Bank 1 (%) | * Lambda Integrator - Bank 2 (%) | * Upstream Lambda Probe Heater - Bank 1 (%) | * Upstream Lambda Probe Heater - Bank 2 (%) | * Downstream Lambda Probe Heater - Bank 1 (%) | * Downstream Lambda Probe Heater - Bank 2 (%) | Knock | MAF (KG/HR) | IACV (PWM) | Charcoal Canister Purge Valve | Idle Fuel Trims Bank1 | Idle Fuel Trims Bank2 | LTFT Bank1 | LTFT Bank2 | MAF (V)
398 | 43 | 0 | 0 | 0 | 57 | -48 | -23.60 | 5.14 | 0.00 | 52.8045 | 14.27 | -50.18 | -50.18 | x | x | x | x | 0 | 11930 | x | 40.00 | x | x | -49.39 | 27.05 | 0.000
543 | 43 | 0 | 0 | 0 | 57 | -48 | -23.60 | 5.14 | 0.00 | 52.8045 | 14.27 | -50.18 | -50.18 | x | x | x | x | 0 | 11930 | x | 40.00 | x | x | -49.39 | 23.52 | 0.000
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
