mstevanin4/ECU_STM_V1/STM2_ECU/TunerStudio_proj/STM_TestBench_v1/DataLogs/power curve.xlsx

2062 | 20 | 89 | 2073 | 19 | 82 | engRPMInTbMode | AvgTqAtEng | AvgPwrOnRetarder
2069 | 20 | 90 | 2092 | 19 | 83 | 2718 | 188 | 75.166664
2100 | 21 | 92 | 2104 | 20 | 85 | 2753 | 188.57143 | 75.57143
2112 | 21 | 93 | 2135 | 20 | 87 | 2803 | 189 | 76.125
2127 | 22 | 94 | 2127 | 21 | 89 | 2818 | 189.55556 | 76.77778
2150 | 22 | 95 | 2146 | 22 | 93 | 2845 | 190.1 | 77.4
2188 | 23 | 97 | 2138 | 22 | 95 | 2880 | 190.81818 | 78.181816
2188 | 24 | 98 | 2154 | 24 | 101 | 2849 | 192 | 79.454544
2219 | 24 | 99 | 2165 | 25 | 104 | 2933 | 193.18182 | 80.72727
2242 | 24 | 97 | 2158 | 25 | 106 | 2968 | 194.36363 | 82
2269 | 23 | 94 | 2161 | 26 | 113 | 2976 | 195.63637 | 83.27273
2292 | 24 | 94 | 2173 | 28 | 120 | 3048 | 196.81818 | 84.545456
2323 | 24 | 94 | 2150 | 28 | 120 | 3048 | 198.09091 | 85.90909
2342 | 24 | 94 | 2146 | 30 | 126 | 3083 | 199.36363 | 87.454544
2373 | 24 | 94 | 2142 | 31 | 134 | 3098 | 200.81818 | 89
2403 | 24 | 92 | 2131 | 31 | 136 | 3110 | 202.36363 | 90.545456
2434 | 24 | 90 | 2100 | 32 | 142 | 3148 | 203.81818 | 92
2461 | 24 | 89 | 2088 | 33 | 144 | 3191 | 205.18182 | 93.36364
2492 | 24 | 90 | 2088 | 33 | 145 | 3229 | 207 | 95.09091
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
