mstevanin4/ECU_STM_V1/bimmerTuning/WBABK72020ET52358_26.03.2024_104548_log.csv

Time (ms) | * Engine Speed (RPM) | * Vehicle Speed (km/h) | * Throttle Position (%) | * Engine Load (mg/stroke) | * Intake Air Temperature (°C) | * Coolant Temperature (°C) | * Ignition Angle (°BTDC) | * Fuel Injector Pulse Width (ms) | * Idle Air Control Valve (%) | * VANOS Angle (KW °) | * Battery Voltage (VDC) | * Lambda Integrator - Bank 1 (%) | * Lambda Integrator - Bank 2 (%) | * Upstream Lambda Probe Heater - Bank 1 (%) | * Upstream Lambda Probe Heater - Bank 2 (%) | * Downstream Lambda Probe Heater - Bank 1 (%) | * Downstream Lambda Probe Heater - Bank 2 (%)
130 | 710 | 0 | 14 | 83 | 30 | 91 | 14.4 | 2.1 | 9.3 | 31.8325 | 14.38 | 0.00 | 0.00 | 2.35 | 2.35 | 0.00 | 0.00
280 | 699 | 0 | 14 | 85 | 30 | 91 | 14.8 | 2.1 | 9.0 | 29.5855 | 14.27 | 0.00 | 0.00 | 2.35 | 2.35 | 0.00 | 0.00
404 | 699 | 0 | 14 | 85 | 30 | 91 | 14.4 | 2.1 | 9.2 | 29.96 | 14.27 | 0.00 | 0.00 | 2.35 | 2.35 | 0.00 | 0.00
524 | 708 | 0 | 14 | 84 | 30 | 91 | 14.4 | 2.1 | 9.0 | 31.8325 | 14.38 | 0.00 | 0.00 | 2.35 | 2.35 | 0.00 | 0.00
651 | 701 | 0 | 14 | 84 | 30 | 91 | 14.4 | 2.1 | 8.8 | 31.458 | 14.07 | 0.00 | 0.00 | 2.35 | 2.35 | 0.00 | 0.00
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
