mstevanin4/ECU_STM_V1/bimmerTuning/WBABK72020ET52358_26.03.2024_112452_log.csv

Time (ms) | * Engine Speed (RPM) | * Vehicle Speed (km/h) | * Throttle Position (%) | * Engine Load (mg/stroke) | * Intake Air Temperature (°C) | * Coolant Temperature (°C) | * Ignition Angle (°BTDC) | * Fuel Injector Pulse Width (ms) | * Idle Air Control Valve (%) | * VANOS Angle (KW °) | * Battery Voltage (VDC) | * Lambda Integrator - Bank 1 (%) | * Lambda Integrator - Bank 2 (%) | * Upstream Lambda Probe Heater - Bank 1 (%) | * Upstream Lambda Probe Heater - Bank 2 (%) | * Downstream Lambda Probe Heater - Bank 1 (%) | * Downstream Lambda Probe Heater - Bank 2 (%)
151 | 729 | 0 | 14 | 83 | 39 | 92 | 14.1 | 2.1 | 13.1 | 31.8325 | 14.27 | 0.00 | 0.00 | 2.35 | 2.35 | 0.00 | 0.00
289 | 737 | 0 | 14 | 80 | 39 | 92 | 14.1 | 2.1 | 13.0 | 31.8325 | 14.27 | 0.00 | 0.00 | 2.35 | 2.35 | 0.00 | 0.00
410 | 715 | 0 | 14 | 83 | 39 | 92 | 14.4 | 2.1 | 12.9 | 31.8325 | 14.38 | 0.00 | 0.00 | 2.35 | 2.35 | 0.00 | 0.00
531 | 711 | 0 | 14 | 83 | 39 | 92 | 14.4 | 2.1 | 12.9 | 29.5855 | 13.87 | 0.00 | 0.00 | 2.35 | 2.35 | 0.00 | 0.00
642 | 713 | 0 | 14 | 83 | 39 | 92 | 14.4 | 2.1 | 12.9 | 31.8325 | 14.27 | 0.00 | 0.00 | 2.35 | 2.35 | 0.00 | 0.00
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
