mstevanin4/ECU_STM_V1/bimmerTuning/WBABK72020ET52358_26.03.2024_112537_log.csv

Time (ms) | * Engine Speed (RPM) | * Vehicle Speed (km/h) | * Throttle Position (%) | * Engine Load (mg/stroke) | * Intake Air Temperature (°C) | * Coolant Temperature (°C) | * Ignition Angle (°BTDC) | * Fuel Injector Pulse Width (ms) | * Idle Air Control Valve (%) | * VANOS Angle (KW °) | * Battery Voltage (VDC) | * Lambda Integrator - Bank 1 (%) | * Lambda Integrator - Bank 2 (%) | * Upstream Lambda Probe Heater - Bank 1 (%) | * Upstream Lambda Probe Heater - Bank 2 (%) | * Downstream Lambda Probe Heater - Bank 1 (%) | * Downstream Lambda Probe Heater - Bank 2 (%)
138 | 706 | 0 | 14 | 86 | 39 | 92 | 14.4 | 2.1 | 13.2 | 31.8325 | 14.27 | 0.00 | 0.00 | 2.35 | 2.35 | 0.00 | 0.00
249 | 694 | 0 | 14 | 85 | 39 | 92 | 14.8 | 2.1 | 13.2 | 31.8325 | 14.07 | 0.00 | 0.00 | 2.35 | 2.35 | 0.00 | 0.00
386 | 702 | 0 | 14 | 84 | 39 | 92 | 14.4 | 2.1 | 13.2 | 29.211 | 14.27 | 0.00 | 0.00 | 2.35 | 2.35 | 0.00 | 0.00
488 | 699 | 0 | 14 | 87 | 39 | 92 | 14.4 | 2.1 | 13.2 | 31.8325 | 14.27 | 0.00 | 0.00 | 2.35 | 2.35 | 0.00 | 0.00
612 | 712 | 0 | 14 | 85 | 39 | 92 | 14.4 | 2.2 | 13.2 | 31.8325 | 14.27 | 0.00 | 0.00 | 2.35 | 2.35 | 0.00 | 0.00
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
