mstevanin4/ECU_STM_V1/bimmerTuning/WBABK72020ET52358_26.03.2024_113602_log.csv

Time (ms) | * Engine Speed (RPM) | * Vehicle Speed (km/h) | * Throttle Position (%) | * Engine Load (mg/stroke) | * Intake Air Temperature (°C) | * Coolant Temperature (°C) | * Ignition Angle (°BTDC) | * Fuel Injector Pulse Width (ms) | * Idle Air Control Valve (%) | * VANOS Angle (KW °) | * Battery Voltage (VDC) | * Lambda Integrator - Bank 1 (%) | * Lambda Integrator - Bank 2 (%) | * Upstream Lambda Probe Heater - Bank 1 (%) | * Upstream Lambda Probe Heater - Bank 2 (%) | * Downstream Lambda Probe Heater - Bank 1 (%) | * Downstream Lambda Probe Heater - Bank 2 (%)
140 | 700 | 0 | 14 | 86 | 35 | 83 | 15.2 | 2.2 | 14.0 | 29.5855 | 14.38 | 0.00 | 0.00 | 2.35 | 2.35 | 0.00 | 0.00
271 | 711 | 0 | 14 | 87 | 35 | 83 | 14.8 | 2.2 | 14.0 | 29.5855 | 14.27 | 0.00 | 0.00 | 2.35 | 2.35 | 0.00 | 0.00
391 | 702 | 0 | 14 | 90 | 35 | 83 | 15.2 | 2.2 | 14.0 | 29.211 | 14.27 | 0.00 | 0.00 | 2.35 | 2.35 | 0.00 | 0.00
527 | 691 | 0 | 14 | 92 | 35 | 83 | 15.6 | 2.2 | 14.0 | 31.0835 | 14.27 | 0.00 | 0.00 | 2.35 | 2.35 | 0.00 | 0.00
648 | 697 | 0 | 14 | 91 | 35 | 83 | 15.2 | 2.3 | 14.1 | 29.5855 | 14.17 | 0.00 | 0.00 | 2.35 | 2.35 | 0.00 | 0.00
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
