mstevanin4/ECU_STM_V1/bimmerTuning/E36_Alphonso/2024-03-26 10_17_56-MS41 Quickflash v2.73 marc_stevanin@hotmail.com 3d89.png

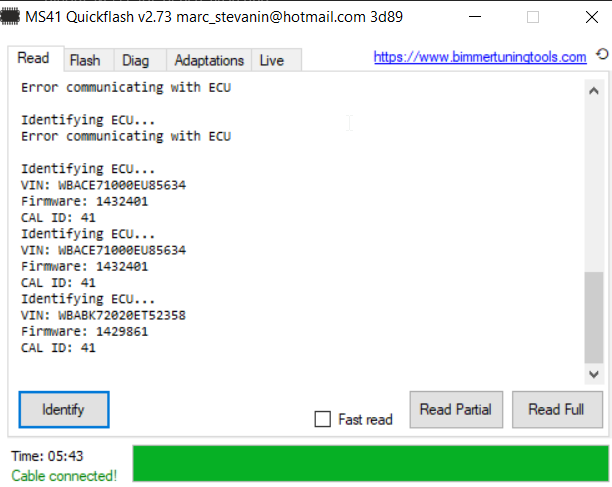
bimmerTuning/E36_Alphonso/2024-03-26 10_17_56-MS41 Quickflash v2.73 marc_stevanin@hotmail.com 3d89.png
