mstevanin4/ECU_STM_V1/(list of files, drawings)

Other design files:
STM2_ECU/SW/TestBench_SW/TestBench_STM_V1_old/reference/hardware/Pro/speeduino pro NA6.fzz
STM2_ECU/SW/TestBench_SW/TestBench_STM_V1_old/reference/hardware/Pro/speeduino pro.fzz
STM2_ECU/SW/TestBench_SW/TestBench_STM_V1_old/reference/hardware/Teensy Adapter/Teensy 3.5 Adaptor.fzz
STM2_ECU/SW/TestBench_SW/TestBench_STM_V1_old/reference/hardware/v0.3/schematic v0.3.6.fzz
STM2_ECU/SW/TestBench_SW/TestBench_STM_V1_old/reference/hardware/v0.3/schematic v0.3.7.fzz
STM2_ECU/SW/TestBench_SW/TestBench_STM_V1_old/reference/hardware/v0.4/Interface boards/48 Pin NA Miata/NA Miata 48 pin.fzz
STM2_ECU/SW/TestBench_SW/TestBench_STM_V1_old/reference/hardware/v0.4/schematic v0.4.2-smt.fzz
STM2_ECU/SW/TestBench_SW/TestBench_STM_V1_old/reference/hardware/v0.4/schematic v0.4.3.fzz
STM2_ECU/SW/TestBench_SW/TestBench_STM_V1_old/reference/hardware/v0.4/schematic v0.4.4-smt.fzz
STM2_ECU/SW/TestBench_SW/TestBench_STM_V1_old/reference/hardware/VR Conditioner/VR Conditioner v2.fzz
STM2_ECU/SW/TestBench_SW/TestBench_STM_V1_old/reference/hardware/VR Conditioner/VR Conditioner v3.fzz
