mstevanin4/ECU_STM_V1/STM2_ECU/HW/STM2_ECU.kicad_pcb

## KiCad design STM2_ECU/HW/STM2_ECU.kicad_pcb (2018-04-26)

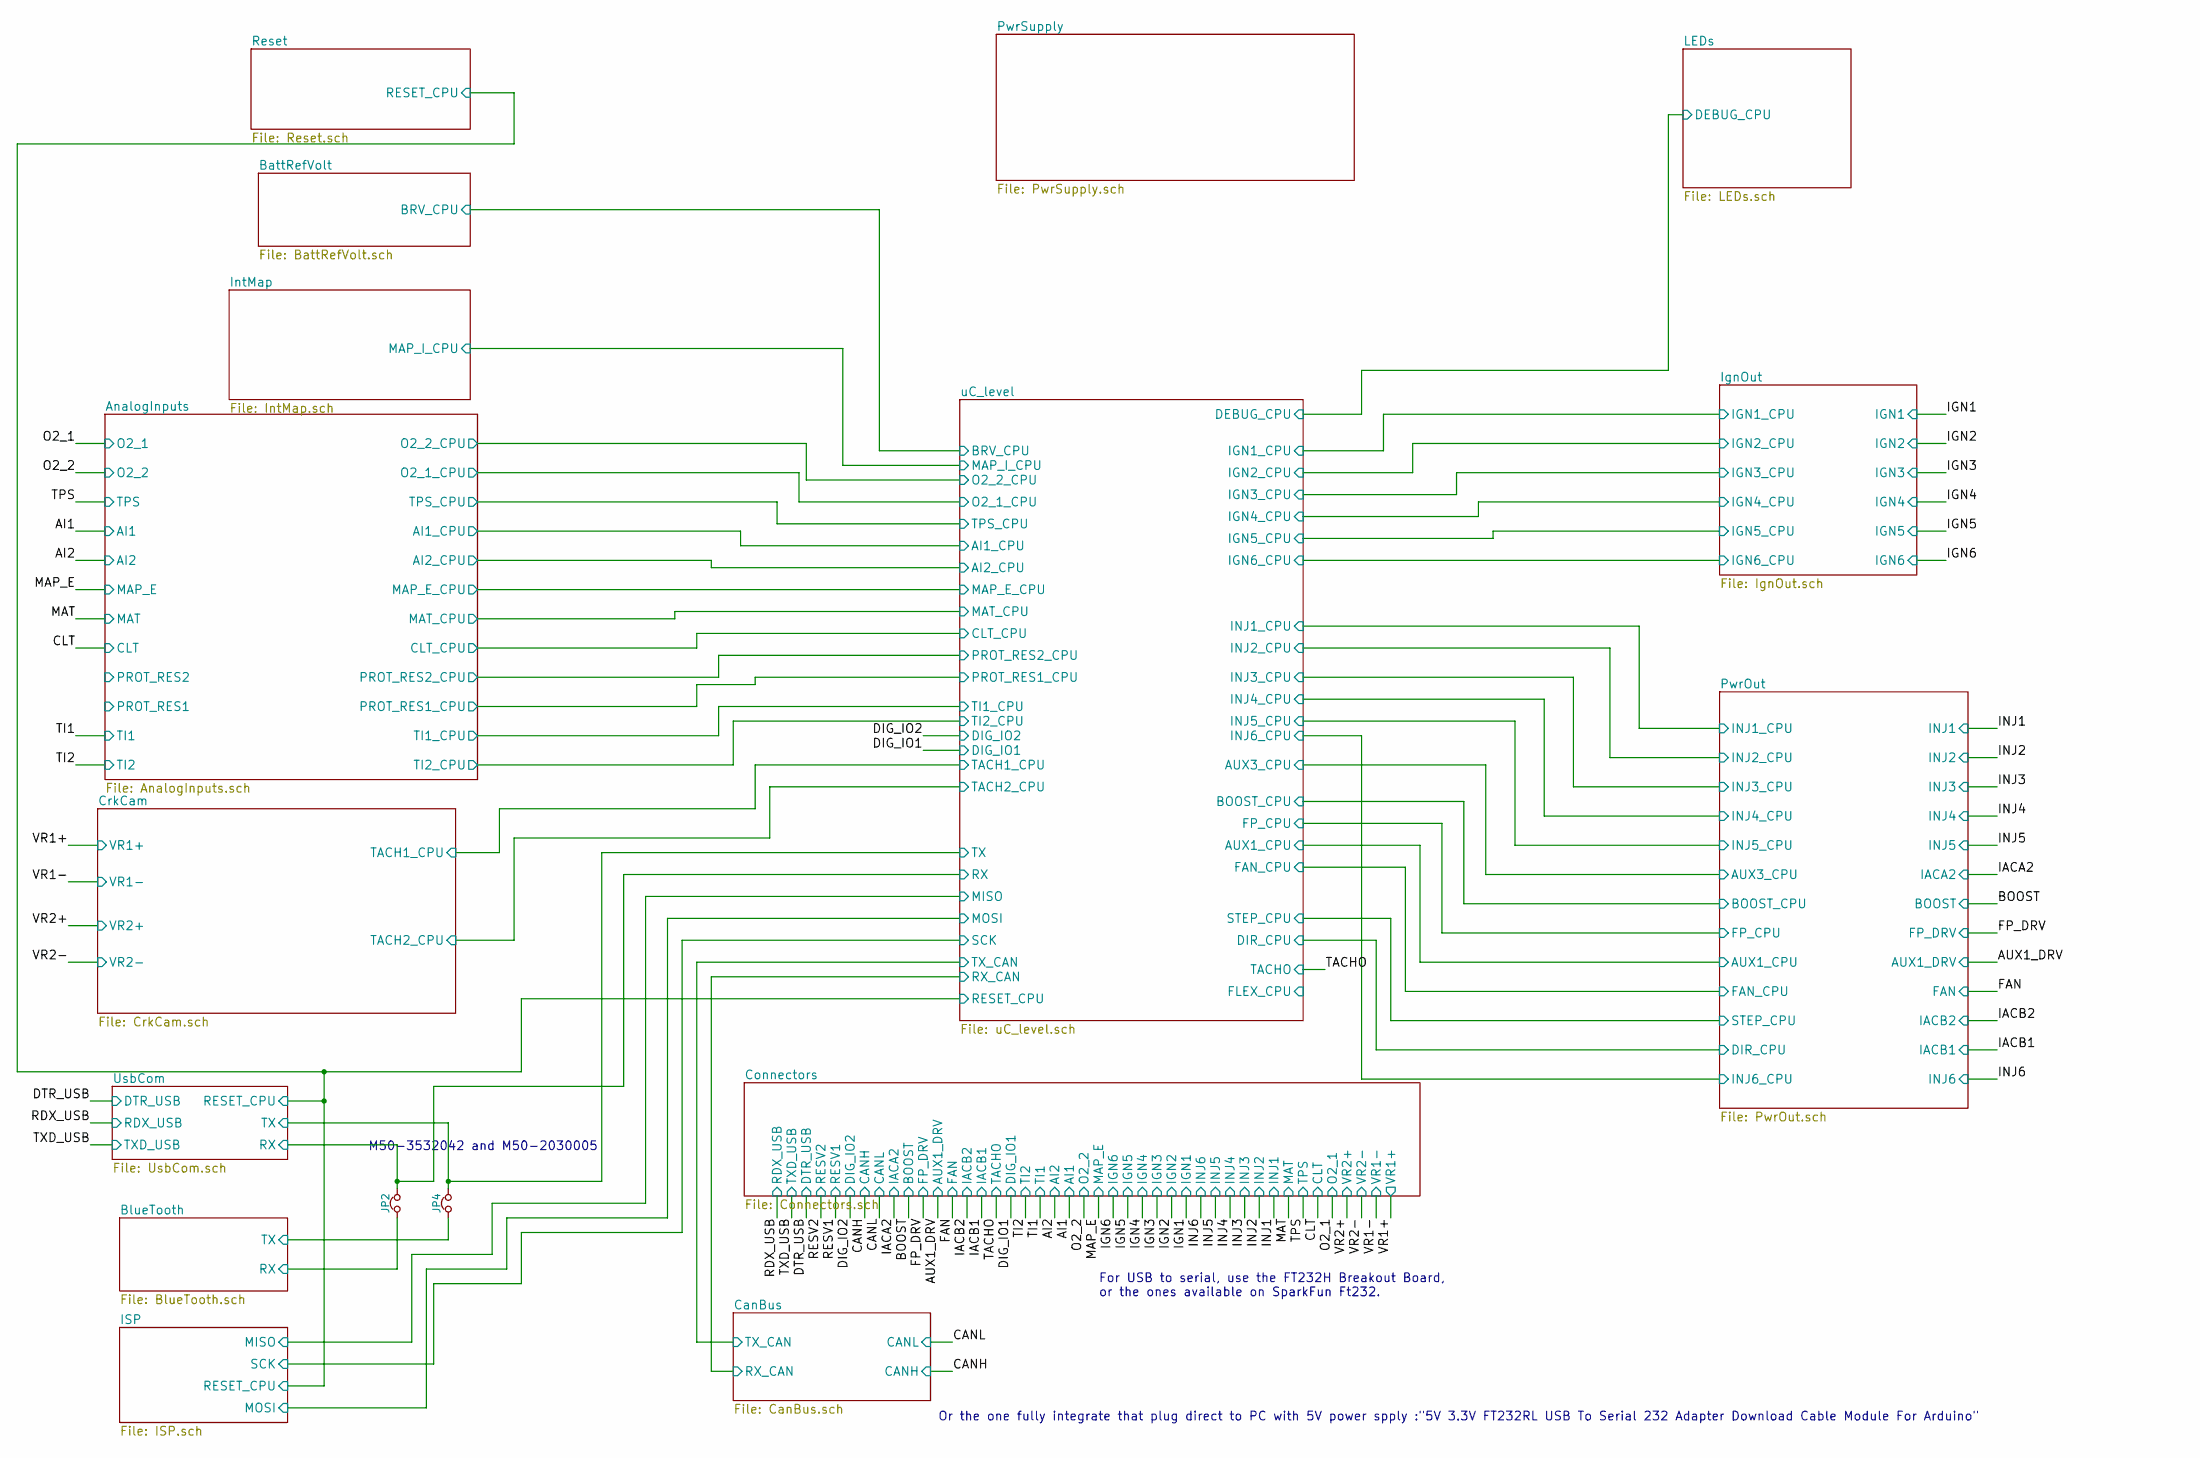
[picture p19: schematic STM2_ECU.sch, ECU STM2]

Parts:
JP2, JP4: Jumper_NC_Small; Pin_Header_Straight_1x02_Pitch1.27mm

Connections:
/BlueTooth/RX: JP2.1; also elsewhere on the board
/BlueTooth/TX: JP4.1; also elsewhere on the board
/UsbCom/RX: JP2.2; also elsewhere on the board
/UsbCom/TX: JP4.2; also elsewhere on the board

Notes on the sheet:
M50-3532042 and M50-2030005
For USB to serial, use the FT232H Breakout Board, or the ones available on SparkFun Ft232.
Or the one fully integrate that plug direct to PC with 5V power spply :"5V 3.3V FT232RL USB To Serial 232 Adapter Download Cable Module For Arduino"

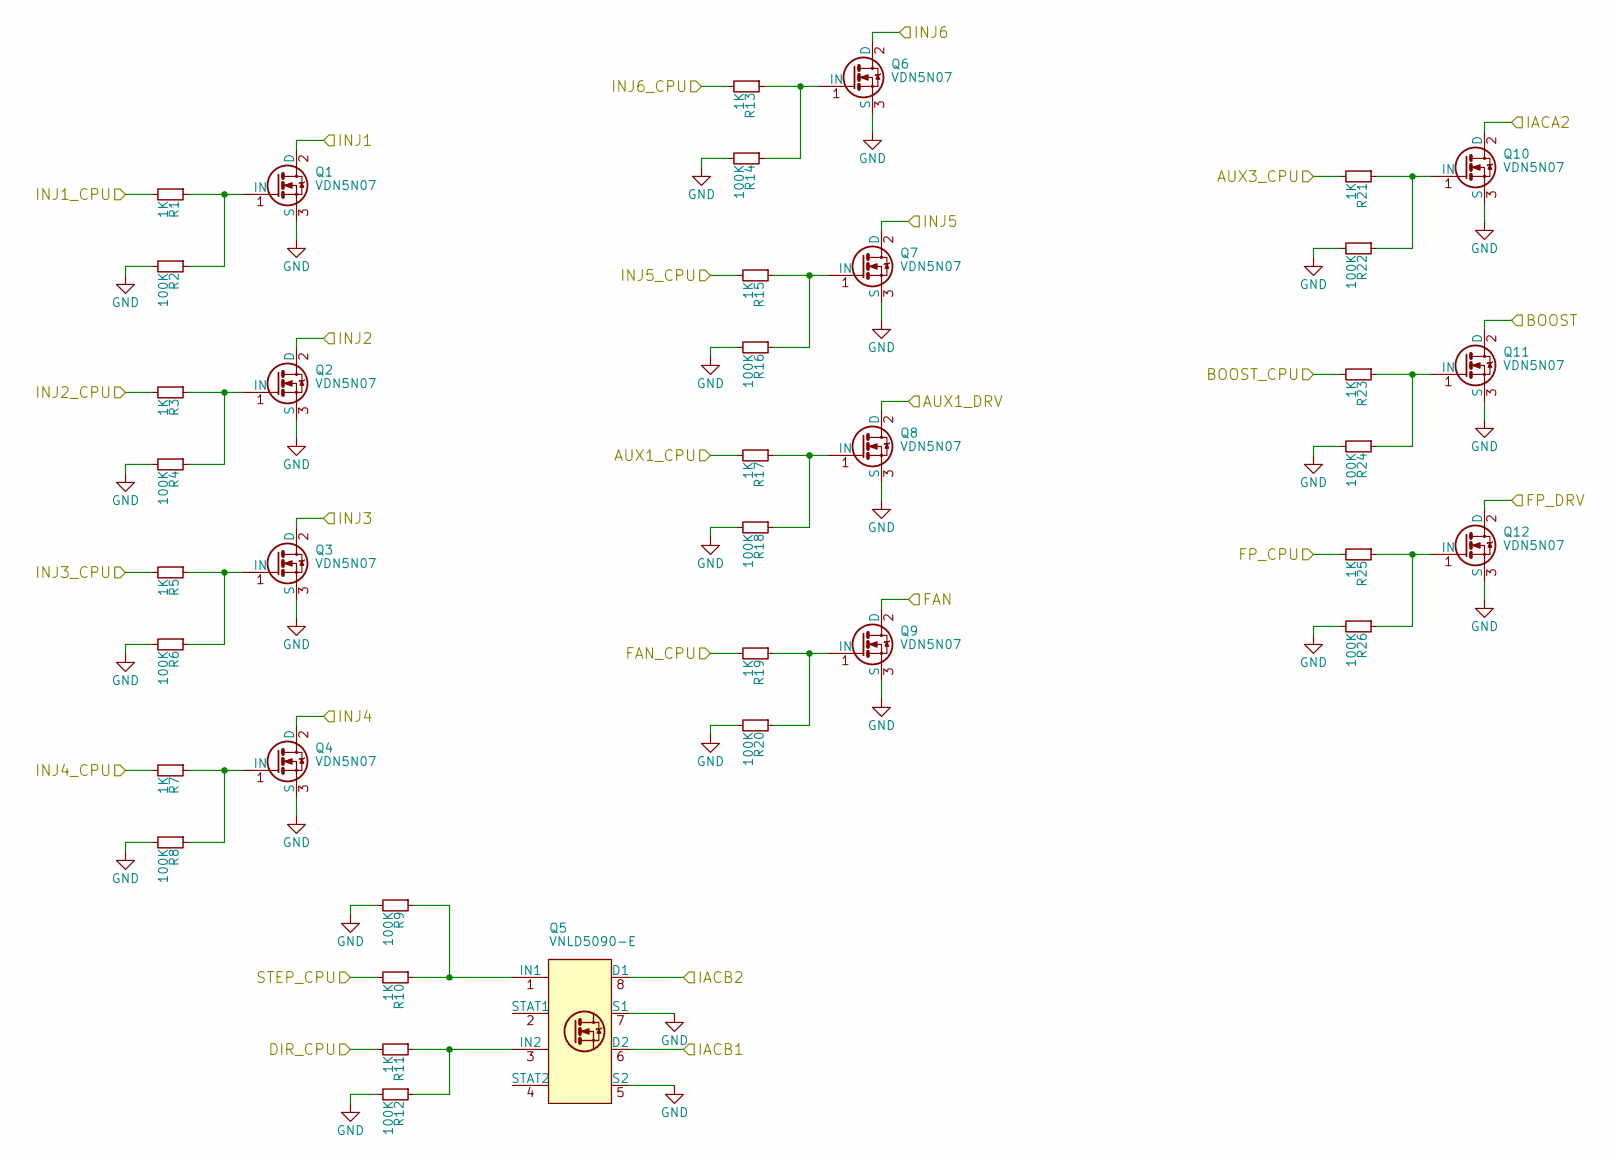
[picture p20: schematic PwrOut.sch]

Parts:
Q1, Q2, Q3, Q4, Q6, Q7, Q8, Q9, Q10, Q11, Q12: VDN5N07; TO-252-2
Q5: VNLD5090-E; SOIC-8_3.9x4.9mm_Pitch1.27mm
R1, R3, R5, R7, R13, R15, R17, R19, R21, R23, R25: 1K; R_0805_HandSoldering
R2, R4, R6, R8, R9, R12, R14, R16, R18, R20, R22, R24, R26: 100K; R_0603_HandSoldering
R10, R11: 1K; R_0603_HandSoldering

Connections:
/Connectors/AUX1_DRV: Q8.2 (D); also elsewhere on the board
/Connectors/BOOST: Q11.2 (D); also elsewhere on the board
/Connectors/FAN: Q9.2 (D); also elsewhere on the board
/Connectors/FP_DRV: Q12.2 (D); also elsewhere on the board
/Connectors/IACA2: Q10.2 (D); also elsewhere on the board
/Connectors/IACB1: Q5.6 (D2); also elsewhere on the board
/Connectors/IACB2: Q5.8 (D1); also elsewhere on the board
/Connectors/INJ1: Q1.2 (D); also elsewhere on the board
/Connectors/INJ2: Q2.2 (D); also elsewhere on the board
/Connectors/INJ3: Q3.2 (D); also elsewhere on the board
/Connectors/INJ4: Q4.2 (D); also elsewhere on the board
/Connectors/INJ5: Q7.2 (D); also elsewhere on the board
/Connectors/INJ6: Q6.2 (D); also elsewhere on the board
/PwrOut/AUX1_CPU: R17.2; also elsewhere on the board
/PwrOut/AUX3_CPU: R21.2; also elsewhere on the board
/PwrOut/BOOST_CPU: R23.2; also elsewhere on the board
/PwrOut/DIR_CPU: R11.2; also elsewhere on the board
/PwrOut/FAN_CPU: R19.2; also elsewhere on the board
/PwrOut/FP_CPU: R25.2; also elsewhere on the board
/PwrOut/INJ1_CPU: R1.2; also elsewhere on the board
/PwrOut/INJ2_CPU: R3.2; also elsewhere on the board
/PwrOut/INJ3_CPU: R5.2; also elsewhere on the board
/PwrOut/INJ4_CPU: R7.2; also elsewhere on the board
/PwrOut/INJ5_CPU: R15.2; also elsewhere on the board
/PwrOut/INJ6_CPU: R13.2; also elsewhere on the board
/PwrOut/STEP_CPU: R10.2; also elsewhere on the board
GND: Q1.3 (S), Q2.3 (S), Q3.3 (S), Q4.3 (S), Q5.5 (S2), Q5.7 (S1), Q6.3 (S), Q7.3 (S), Q8.3 (S), Q9.3 (S), Q10.3 (S), Q11.3 (S), Q12.3 (S), R2.2, R4.2, R6.2, R8.2, R9.2, R12.2, R14.2, R16.2, R18.2, R20.2, R22.2, R24.2, R26.2; also elsewhere on the board
unnamed: Q1.1 (IN), R1.1, R2.1
unnamed: Q2.1 (IN), R3.1, R4.1
unnamed: Q3.1 (IN), R5.1, R6.1
unnamed: Q4.1 (IN), R7.1, R8.1
unnamed: Q5.1 (IN1), R9.1, R10.1
unnamed: Q5.3 (IN2), R11.1, R12.1
unnamed: Q6.1 (IN), R13.1, R14.1
unnamed: Q7.1 (IN), R15.1, R16.1
unnamed: Q8.1 (IN), R17.1, R18.1
unnamed: Q9.1 (IN), R19.1, R20.1
unnamed: Q10.1 (IN), R21.1, R22.1
unnamed: Q11.1 (IN), R23.1, R24.1
unnamed: Q12.1 (IN), R25.1, R26.1

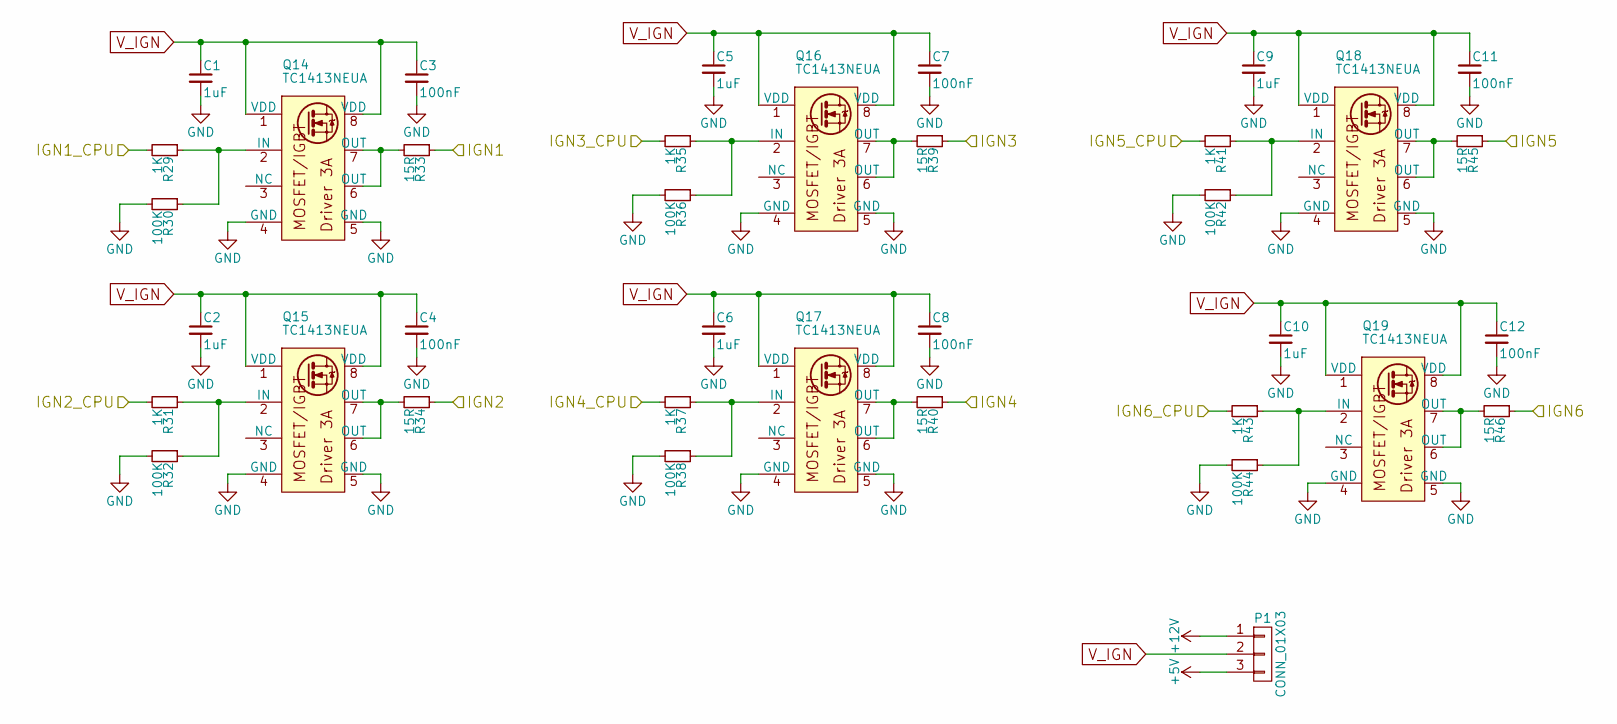
[picture p21: schematic IgnOut.sch]

Parts:
C1, C2, C5, C6, C9, C10: 1uF; C_0603_HandSoldering
C3, C4, C7, C8, C11, C12: 100nF; C_0603_HandSoldering
P1: CONN_01X03; Pin_Header_Straight_1x03_Pitch1.27mm
Q14, Q15, Q16, Q17, Q18, Q19: TC1413NEUA; MSOP-8_3x3mm_Pitch0.65mm
R29, R31, R35, R37, R41, R43: 1K; R_0603_HandSoldering
R30, R32, R36, R38, R42, R44: 100K; R_0603_HandSoldering
R33, R34, R39, R40, R45, R46: 15R; R_2512_HandSoldering

Connections:
+5V: P1.3; also elsewhere on the board
+12V: P1.1; also elsewhere on the board
/Connectors/IGN1: R33.1; also elsewhere on the board
/Connectors/IGN2: R34.1; also elsewhere on the board
/Connectors/IGN3: R39.1; also elsewhere on the board
/Connectors/IGN4: R40.1; also elsewhere on the board
/Connectors/IGN5: R45.1; also elsewhere on the board
/Connectors/IGN6: R46.1; also elsewhere on the board
/IgnOut/IGN1_CPU: R29.2; also elsewhere on the board
/IgnOut/IGN2_CPU: R31.2; also elsewhere on the board
/IgnOut/IGN3_CPU: R35.2; also elsewhere on the board
/IgnOut/IGN4_CPU: R37.2; also elsewhere on the board
/IgnOut/IGN5_CPU: R41.2; also elsewhere on the board
/IgnOut/IGN6_CPU: R43.2; also elsewhere on the board
GND: C1.2, C2.2, C3.2, C4.2, C5.2, C6.2, C7.2, C8.2, C9.2, C10.2, C11.2, C12.2, Q14.4 (GND), Q14.5 (GND), Q15.4 (GND), Q15.5 (GND), Q16.4 (GND), Q16.5 (GND), Q17.4 (GND), Q17.5 (GND), Q18.4 (GND), Q18.5 (GND), Q19.4 (GND), Q19.5 (GND), R30.2, R32.2, R36.2, R38.2, R42.2, R44.2; also elsewhere on the board
unnamed: Q14.2 (IN), R29.1, R30.1
unnamed: Q14.6 (OUT), Q14.7 (OUT), R33.2
unnamed: Q15.2 (IN), R31.1, R32.1
unnamed: Q15.6 (OUT), Q15.7 (OUT), R34.2
unnamed: Q16.2 (IN), R35.1, R36.1
unnamed: Q16.6 (OUT), Q16.7 (OUT), R39.2
unnamed: Q17.2 (IN), R37.1, R38.1
unnamed: Q17.6 (OUT), Q17.7 (OUT), R40.2
unnamed: Q18.2 (IN), R41.1, R42.1
unnamed: Q18.6 (OUT), Q18.7 (OUT), R45.2
unnamed: Q19.2 (IN), R43.1, R44.1
unnamed: Q19.6 (OUT), Q19.7 (OUT), R46.2
V_IGN: C1.1, C2.1, C3.1, C4.1, C5.1, C6.1, C7.1, C8.1, C9.1, C10.1, C11.1, C12.1, P1.2, Q14.1 (VDD), Q14.8 (VDD), Q15.1 (VDD), Q15.8 (VDD), Q16.1 (VDD), Q16.8 (VDD), Q17.1 (VDD), Q17.8 (VDD), Q18.1 (VDD), Q18.8 (VDD), Q19.1 (VDD), Q19.8 (VDD)

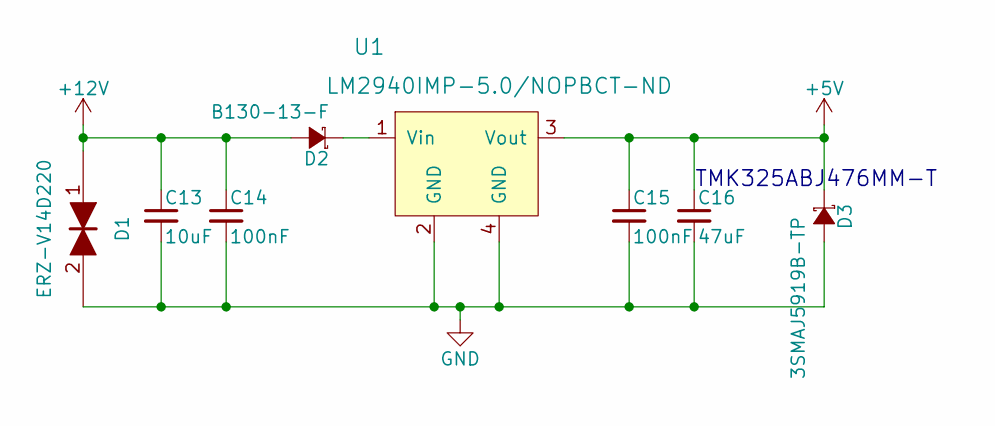
[picture p22: schematic PwrSupply.sch]

Parts:
C13: 10uF; C_1210_HandSoldering
C14, C15: 100nF; C_0603_HandSoldering
C16: 47uF; C_1210_HandSoldering
D1: ERZ-V14D220; D_DO-41_SOD81_P7.62mm_Horizontal
D2: B130-13-F; D_SMA_Handsoldering
D3: 3SMAJ5919B-TP; D_SMA_Handsoldering
U1: LM2940IMP-5.0/NOPBCT-ND; SOT-223-3_TabPin2

Connections:
+5V: C15.1, C16.1, D3.1 (K), U1.3 (Vout); also elsewhere on the board
+12V: C13.1, C14.1, D1.1, D2.2 (A); also elsewhere on the board
GND: C13.2, C14.2, C15.2, C16.2, D1.2, D3.2 (A), U1.2 (GND), U1.4 (GND); also elsewhere on the board
unnamed: D2.1 (K), U1.1 (Vin)

Notes on the sheet:
TMK325ABJ476MM-T

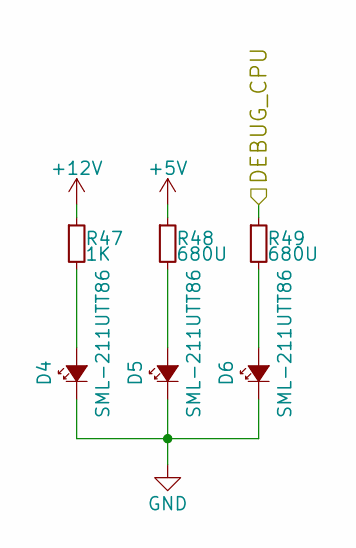
[picture p23: schematic LEDs.sch]

Parts:
D4, D5, D6: SML-211UTT86; LED_0805_HandSoldering
R47: 1K; R_0603_HandSoldering
R48, R49: 680U; R_0603_HandSoldering

Connections:
+5V: R48.1; also elsewhere on the board
+12V: R47.1; also elsewhere on the board
/LEDs/DEBUG_CPU: R49.1; also elsewhere on the board
GND: D4.1 (K), D5.1 (K), D6.1 (K); also elsewhere on the board
unnamed: D4.2 (A), R47.2
unnamed: D5.2 (A), R48.2
unnamed: D6.2 (A), R49.2

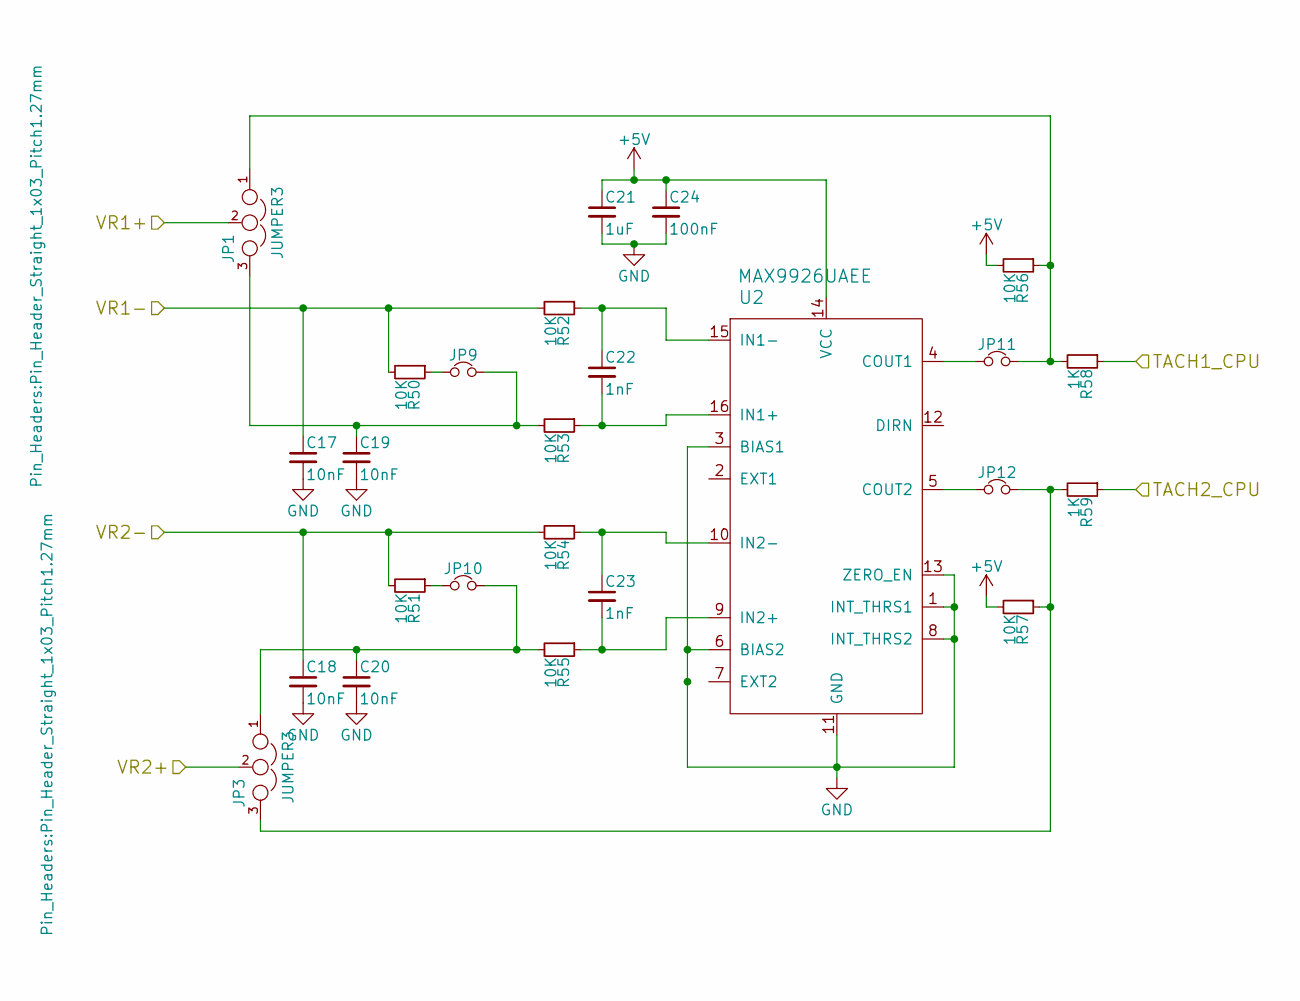
[picture p24: schematic CrkCam.sch]

Parts:
C17, C18, C19, C20: 10nF; C_0603_HandSoldering
C21: 1uF; C_0603_HandSoldering
C22, C23: 1nF; C_0603_HandSoldering
C24: 100nF; C_0603_HandSoldering
JP1, JP3: JUMPER3; Pin_Header_Straight_1x03_Pitch1.27mm
JP9, JP10, JP11, JP12: Jumper_NC_Small; Pin_Header_Straight_1x02_Pitch1.27mm
R50, R51, R52, R53, R54, R55, R56, R57: 10K; R_0805_HandSoldering
R58, R59: 1K; R_0805_HandSoldering
U2: MAX9926UAEE; QSOP-16_3.9x4.9mm_Pitch0.635mm

Connections:
+5V: C21.1, C24.1, R56.2, R57.2, U2.14 (VCC); also elsewhere on the board
/Connectors/VR1+: JP1.2; also elsewhere on the board
/Connectors/VR1-: C17.1, R50.2, R52.2; also elsewhere on the board
/Connectors/VR2+: JP3.2; also elsewhere on the board
/Connectors/VR2-: C18.1, R51.2, R54.2; also elsewhere on the board
/CrkCam/TACH1_CPU: R58.1; also elsewhere on the board
/CrkCam/TACH2_CPU: R59.1; also elsewhere on the board
GND: C17.2, C18.2, C19.2, C20.2, C21.2, C24.2, U2.1 (INT_THRS1), U2.3 (BIAS1), U2.6 (BIAS2), U2.8 (INT_THRS2), U2.11 (GND), U2.13 (ZERO_EN); also elsewhere on the board
unnamed: C19.1, JP1.3, JP9.2, R53.2
unnamed: C20.1, JP3.1, JP10.2, R55.2
unnamed: C22.1, R52.1, U2.15 (IN1-)
unnamed: C22.2, R53.1, U2.16 (IN1+)
unnamed: C23.1, R54.1, U2.10 (IN2-)
unnamed: C23.2, R55.1, U2.9 (IN2+)
unnamed: JP1.1, JP11.2, R56.1, R58.2
unnamed: JP9.1, R50.1
unnamed: JP10.1, R51.1
unnamed: JP11.1, U2.4 (COUT1)
unnamed: JP12.1, U2.5 (COUT2)
unnamed: JP3.3, JP12.2, R57.1, R59.2

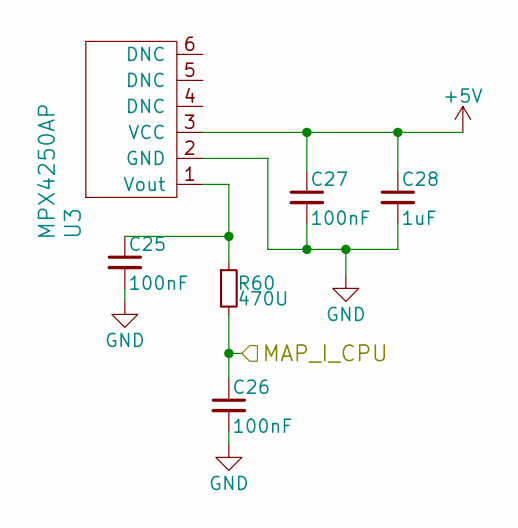
[picture p25: schematic IntMap.sch]

Parts:
C25, C26, C27: 100nF; C_0603_HandSoldering
C28: 1uF; C_0603_HandSoldering
R60: 470U; R_0603_HandSoldering
U3: MPX4250AP; Pin_Header_Straight_1x06_Pitch2.54mm

Connections:
+5V: C27.1, C28.1, U3.3 (VCC); also elsewhere on the board
/IntMap/MAP_I_CPU: C26.1, R60.2; also elsewhere on the board
GND: C25.2, C26.2, C27.2, C28.2, U3.2 (GND); also elsewhere on the board
unnamed: C25.1, R60.1, U3.1 (Vout)

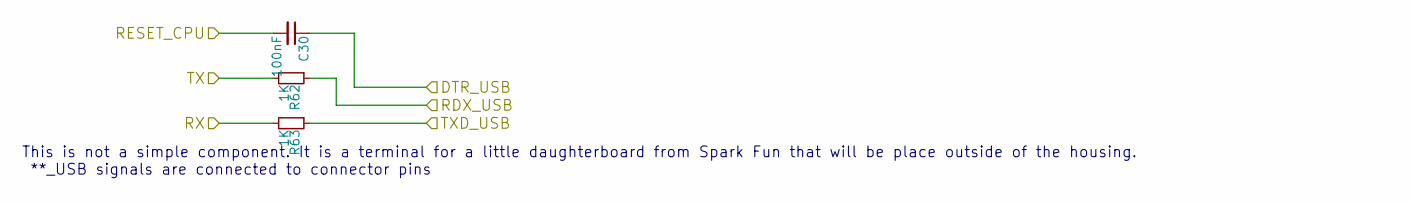
[picture p26: schematic UsbCom.sch]

Parts:
C30: 100nF; C_0603_HandSoldering
R62, R63: 1K; R_0603_HandSoldering

Connections:
/Connectors/DTR_USB: C30.1; also elsewhere on the board
/Connectors/RDX_USB: R62.1; also elsewhere on the board
/Connectors/TXD_USB: R63.1; also elsewhere on the board
/ISP/RESET_CPU: C30.2; also elsewhere on the board
/UsbCom/RX: R63.2; also elsewhere on the board
/UsbCom/TX: R62.2; also elsewhere on the board

Notes on the sheet:
This is not a simple component. It is a terminal for a little daughterboard from Spark Fun that will be place outside of the housing. **_USB signals are connected to connector pins

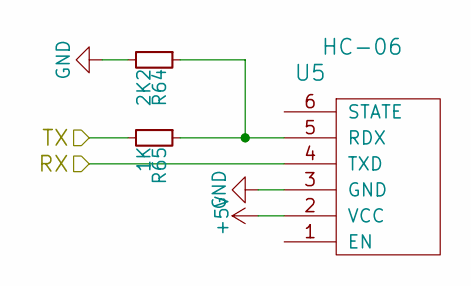
[picture p27: schematic BlueTooth.sch]

Parts:
R64: 2K2; R_0603_HandSoldering
R65: 1K; R_0603_HandSoldering
U5: HC-06; Pin_Header_Straight_1x06_Pitch2.54mm

Connections:
+5V: U5.2 (VCC); also elsewhere on the board
/BlueTooth/RX: U5.4 (TXD); also elsewhere on the board
/BlueTooth/TX: R65.2; also elsewhere on the board
GND: R64.2, U5.3 (GND); also elsewhere on the board
unnamed: R64.1, R65.1, U5.5 (RDX)

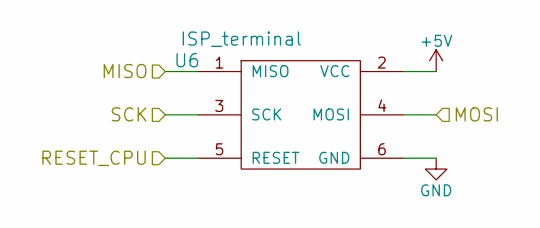
[picture p28: schematic ISP.sch]

Parts:
U6: ISP_terminal; Pin_Header_Straight_2x03_Pitch2.54mm

Connections:
+5V: U6.2 (VCC); also elsewhere on the board
/ISP/MISO: U6.1 (MISO); also elsewhere on the board
/ISP/MOSI: U6.4 (MOSI); also elsewhere on the board
/ISP/RESET_CPU: U6.5 (RESET); also elsewhere on the board
/ISP/SCK: U6.3 (SCK); also elsewhere on the board
GND: U6.6 (GND); also elsewhere on the board

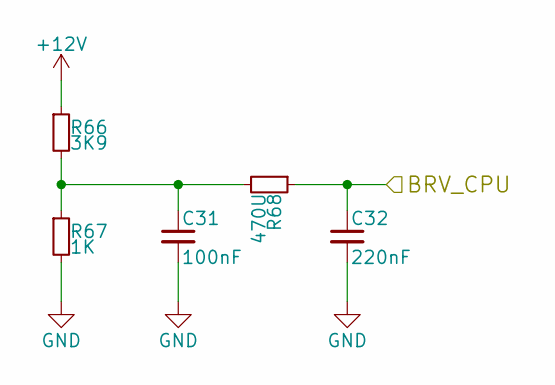
[picture p29: schematic BattRefVolt.sch]

Parts:
C31: 100nF; C_0603_HandSoldering
C32: 220nF; C_0603_HandSoldering
R66: 3K9; R_0603_HandSoldering
R67: 1K; R_0603_HandSoldering
R68: 470U; R_0603_HandSoldering

Connections:
+12V: R66.1; also elsewhere on the board
/BattRefVolt/BRV_CPU: C32.1, R68.1; also elsewhere on the board
GND: C31.2, C32.2, R67.2; also elsewhere on the board
unnamed: C31.1, R66.2, R67.1, R68.2

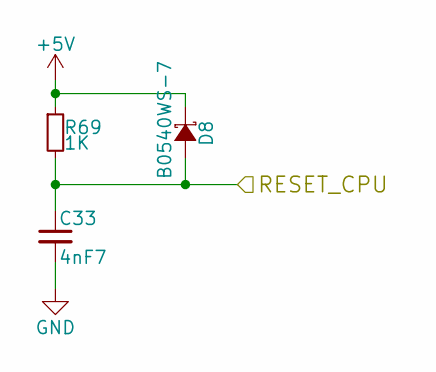
[picture p30: schematic Reset.sch]

Parts:
C33: 4nF7; C_0603_HandSoldering
D8: B0540WS-7; D_SOD-323_HandSoldering
R69: 1K; R_0603_HandSoldering

Connections:
+5V: D8.1 (K), R69.1; also elsewhere on the board
/ISP/RESET_CPU: C33.1, D8.2 (A), R69.2; also elsewhere on the board
GND: C33.2; also elsewhere on the board

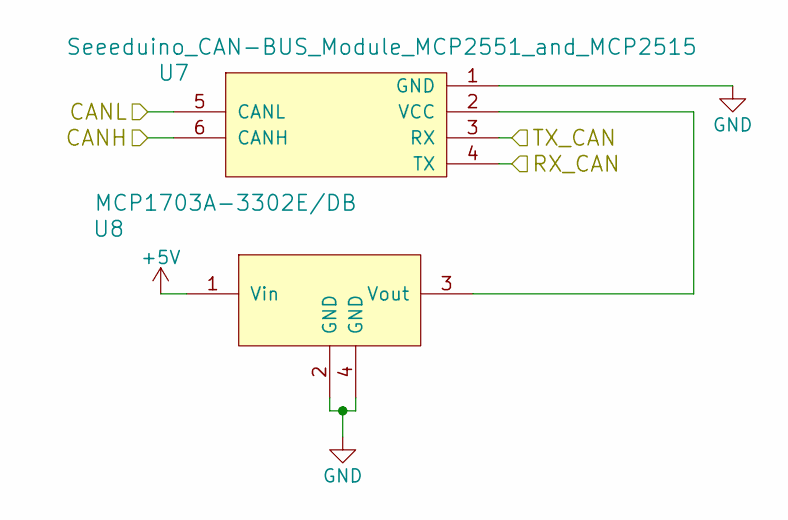
[picture p31: schematic CanBus.sch]

Parts:
U7: Seeeduino_CAN-BUS_Module_MCP2551_and_MCP2515; Seeeduino_CAN_Module
U8: MCP1703A-3302E/DB; SOT-223-3_TabPin2

Connections:
+5V: U8.1 (Vin); also elsewhere on the board
/CanBus/CANH: U7.6 (CANH); also elsewhere on the board
/CanBus/CANL: U7.5 (CANL); also elsewhere on the board
/CanBus/RX_CAN: U7.4 (TX); also elsewhere on the board
/CanBus/TX_CAN: U7.3 (RX); also elsewhere on the board
GND: U7.1 (GND), U8.2 (GND), U8.4 (GND); also elsewhere on the board
unnamed: U7.2 (VCC), U8.3 (Vout)

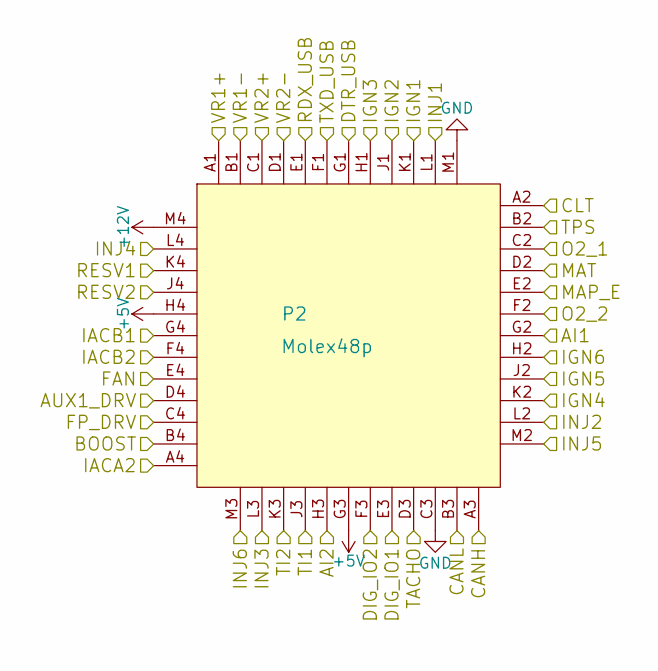
[picture p32: schematic Connectors.sch]

Parts:
P2: Molex48p; Molex_Conn_48p

Connections:
+5V: P2.G3, P2.H4; also elsewhere on the board
+12V: P2.M4; also elsewhere on the board
/AnalogInputs/AI1: P2.G2; also elsewhere on the board
/AnalogInputs/AI2: P2.H3; also elsewhere on the board
/AnalogInputs/CLT: P2.A2; also elsewhere on the board
/AnalogInputs/MAP_E: P2.E2; also elsewhere on the board
/AnalogInputs/MAT: P2.D2; also elsewhere on the board
/AnalogInputs/O2_1: P2.C2; also elsewhere on the board
/AnalogInputs/O2_2: P2.F2; also elsewhere on the board
/AnalogInputs/TI1: P2.J3; also elsewhere on the board
/AnalogInputs/TI2: P2.K3; also elsewhere on the board
/AnalogInputs/TPS: P2.B2; also elsewhere on the board
/CanBus/CANH: P2.A3; also elsewhere on the board
/CanBus/CANL: P2.B3; also elsewhere on the board
/Connectors/AUX1_DRV: P2.D4; also elsewhere on the board
/Connectors/BOOST: P2.B4; also elsewhere on the board
/Connectors/DIG_IO1: P2.E3; also elsewhere on the board
/Connectors/DIG_IO2: P2.F3; also elsewhere on the board
/Connectors/DTR_USB: P2.G1; also elsewhere on the board
/Connectors/FAN: P2.E4; also elsewhere on the board
/Connectors/FP_DRV: P2.C4; also elsewhere on the board
/Connectors/IACA2: P2.A4; also elsewhere on the board
/Connectors/IACB1: P2.G4; also elsewhere on the board
/Connectors/IACB2: P2.F4; also elsewhere on the board
/Connectors/IGN1: P2.K1; also elsewhere on the board
/Connectors/IGN2: P2.J1; also elsewhere on the board
/Connectors/IGN3: P2.H1; also elsewhere on the board
/Connectors/IGN4: P2.K2; also elsewhere on the board
/Connectors/IGN5: P2.J2; also elsewhere on the board
/Connectors/IGN6: P2.H2; also elsewhere on the board
/Connectors/INJ1: P2.L1; also elsewhere on the board
/Connectors/INJ2: P2.L2; also elsewhere on the board
/Connectors/INJ3: P2.L3; also elsewhere on the board
/Connectors/INJ4: P2.L4; also elsewhere on the board
/Connectors/INJ5: P2.M2; also elsewhere on the board
/Connectors/INJ6: P2.M3; also elsewhere on the board
/Connectors/RDX_USB: P2.E1; also elsewhere on the board
/Connectors/RESV1: P2.K4
/Connectors/RESV2: P2.J4
/Connectors/TACHO: P2.D3; also elsewhere on the board
/Connectors/TXD_USB: P2.F1; also elsewhere on the board
/Connectors/VR1+: P2.A1; also elsewhere on the board
/Connectors/VR1-: P2.B1; also elsewhere on the board
/Connectors/VR2+: P2.C1; also elsewhere on the board
/Connectors/VR2-: P2.D1; also elsewhere on the board
GND: P2.C3, P2.M1; also elsewhere on the board

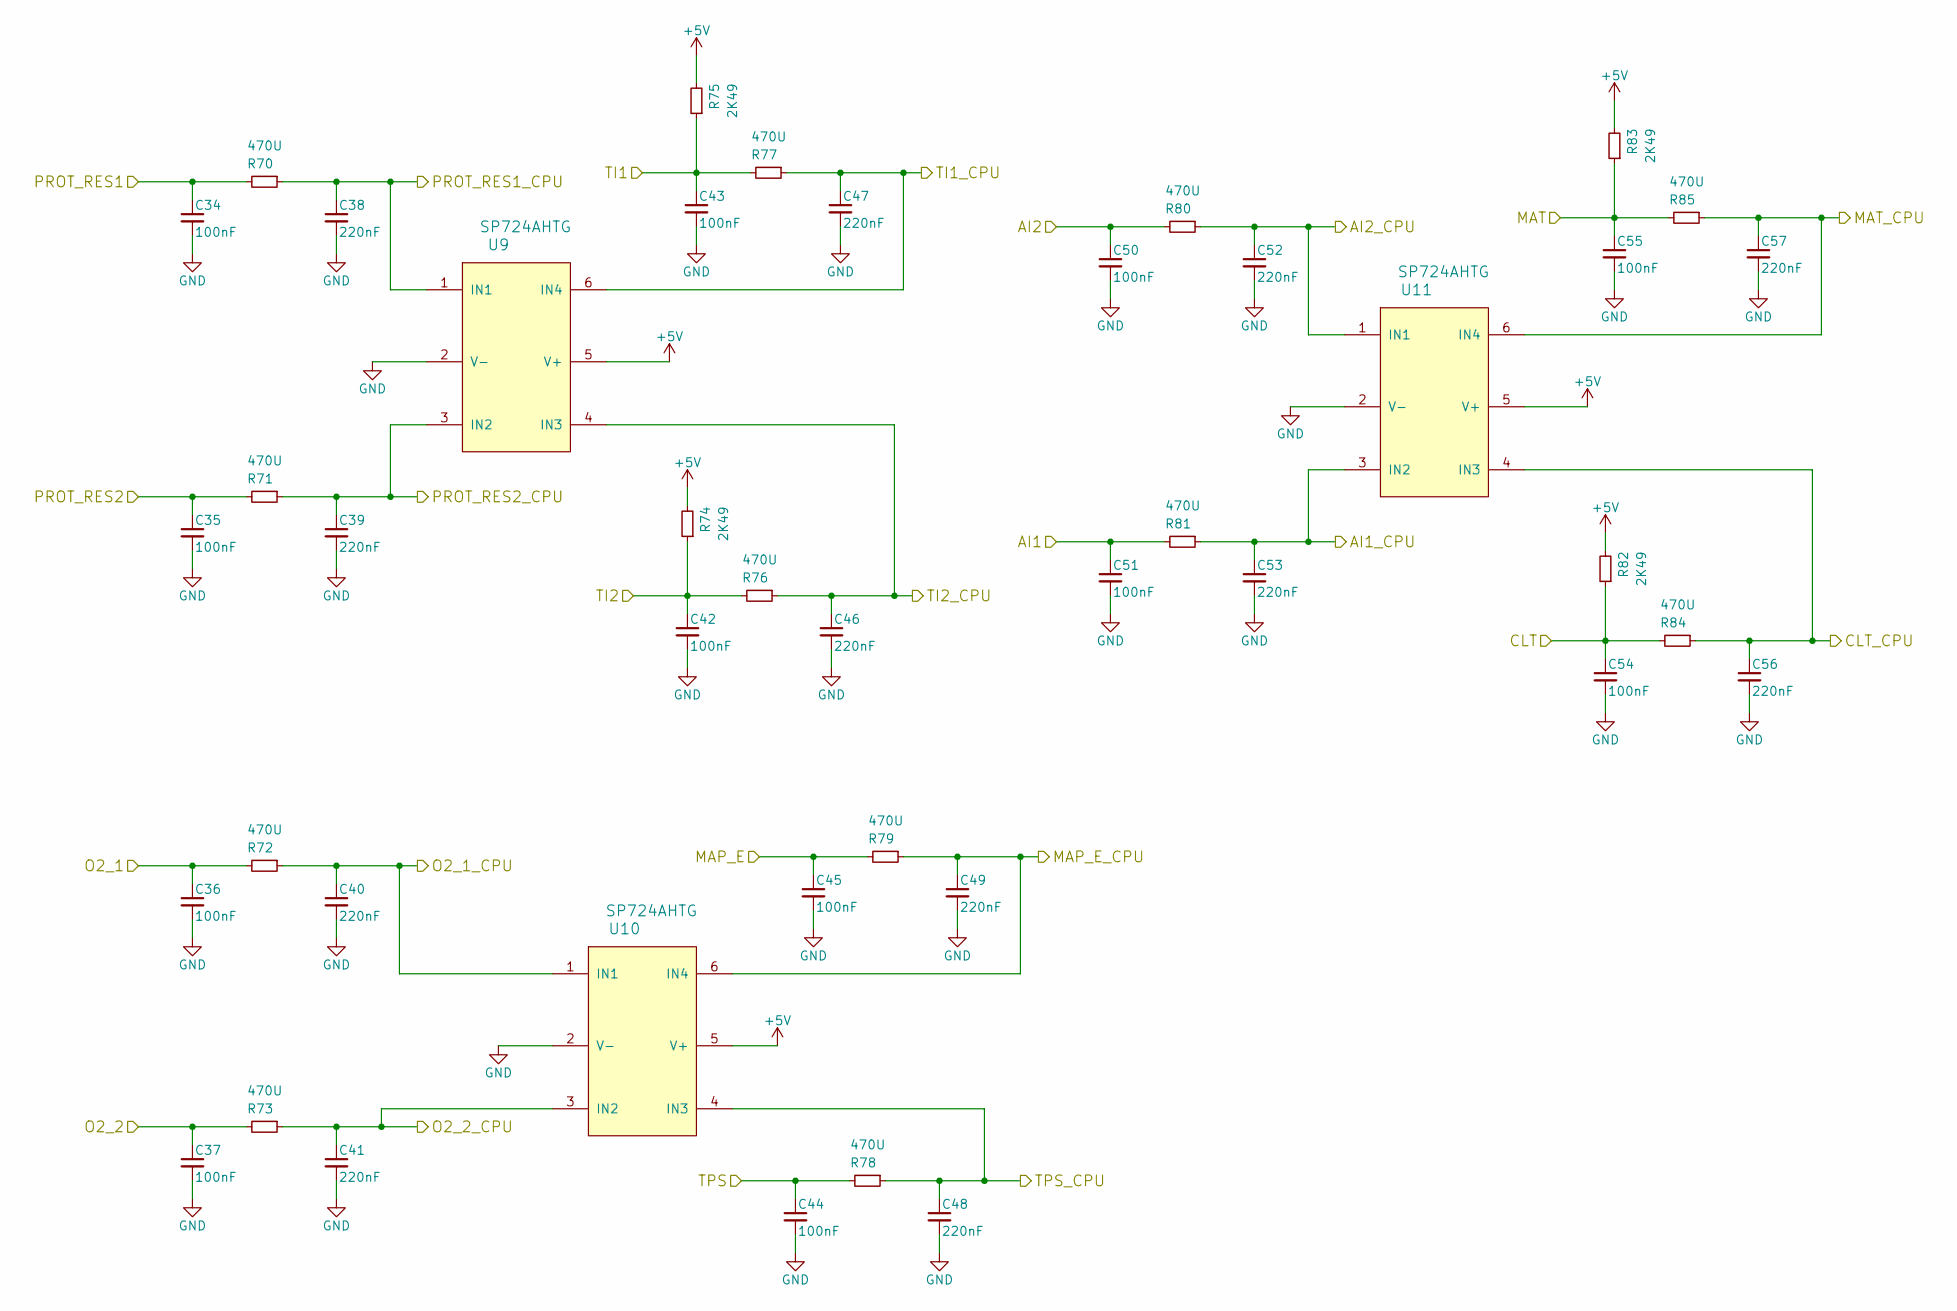
[picture p33: schematic AnalogInputs.sch]

Parts:
C34, C35, C36, C37, C42, C43, C44, C45, C50, C51, C54, C55: 100nF; C_0603_HandSoldering
C38, C39, C40, C41, C46, C47, C48, C49, C52, C53, C56, C57: 220nF; C_0603_HandSoldering
R70, R71, R72, R73, R76, R77, R78, R79, R80, R81, R84, R85: 470U; R_0603_HandSoldering
R74, R75, R82, R83: 2K49; R_0603_HandSoldering
U9, U10, U11: SP724AHTG; SOT-23-6_Handsoldering

Connections:
+5V: R74.2, R75.2, R82.2, R83.2, U9.5 (V+), U10.5 (V+), U11.5 (V+); also elsewhere on the board
/AnalogInputs/AI1: C51.1, R81.2; also elsewhere on the board
/AnalogInputs/AI1_CPU: C53.1, R81.1, U11.3 (IN2); also elsewhere on the board
/AnalogInputs/AI2: C50.1, R80.2; also elsewhere on the board
/AnalogInputs/AI2_CPU: C52.1, R80.1, U11.1 (IN1); also elsewhere on the board
/AnalogInputs/CLT: C54.1, R82.1, R84.2; also elsewhere on the board
/AnalogInputs/CLT_CPU: C56.1, R84.1, U11.4 (IN3); also elsewhere on the board
/AnalogInputs/MAP_E: C45.1, R79.2; also elsewhere on the board
/AnalogInputs/MAP_E_CPU: C49.1, R79.1, U10.6 (IN4); also elsewhere on the board
/AnalogInputs/MAT: C55.1, R83.1, R85.2; also elsewhere on the board
/AnalogInputs/MAT_CPU: C57.1, R85.1, U11.6 (IN4); also elsewhere on the board
/AnalogInputs/O2_1: C36.1, R72.2; also elsewhere on the board
/AnalogInputs/O2_1_CPU: C40.1, R72.1, U10.1 (IN1); also elsewhere on the board
/AnalogInputs/O2_2: C37.1, R73.2; also elsewhere on the board
/AnalogInputs/O2_2_CPU: C41.1, R73.1, U10.3 (IN2); also elsewhere on the board
/AnalogInputs/PROT_RES1: C34.1, R70.2
/AnalogInputs/PROT_RES1_CPU: C38.1, R70.1, U9.1 (IN1); also elsewhere on the board
/AnalogInputs/PROT_RES2: C35.1, R71.2
/AnalogInputs/PROT_RES2_CPU: C39.1, R71.1, U9.3 (IN2); also elsewhere on the board
/AnalogInputs/TI1: C43.1, R75.1, R77.2; also elsewhere on the board
/AnalogInputs/TI1_CPU: C47.1, R77.1, U9.6 (IN4); also elsewhere on the board
/AnalogInputs/TI2: C42.1, R74.1, R76.2; also elsewhere on the board
/AnalogInputs/TI2_CPU: C46.1, R76.1, U9.4 (IN3); also elsewhere on the board
/AnalogInputs/TPS: C44.1, R78.2; also elsewhere on the board
/AnalogInputs/TPS_CPU: C48.1, R78.1, U10.4 (IN3); also elsewhere on the board
GND: C34.2, C35.2, C36.2, C37.2, C38.2, C39.2, C40.2, C41.2, C42.2, C43.2, C44.2, C45.2, C46.2, C47.2, C48.2, C49.2, C50.2, C51.2, C52.2, C53.2, C54.2, C55.2, C56.2, C57.2, U9.2 (V-), U10.2 (V-), U11.2 (V-); also elsewhere on the board
