mstevanin4/ECU_STM_V1/STM2_ECU/HW/STM2_ECU.kicad_pcb

## KiCad design STM2_ECU/HW/STM2_ECU.kicad_pcb (continued)

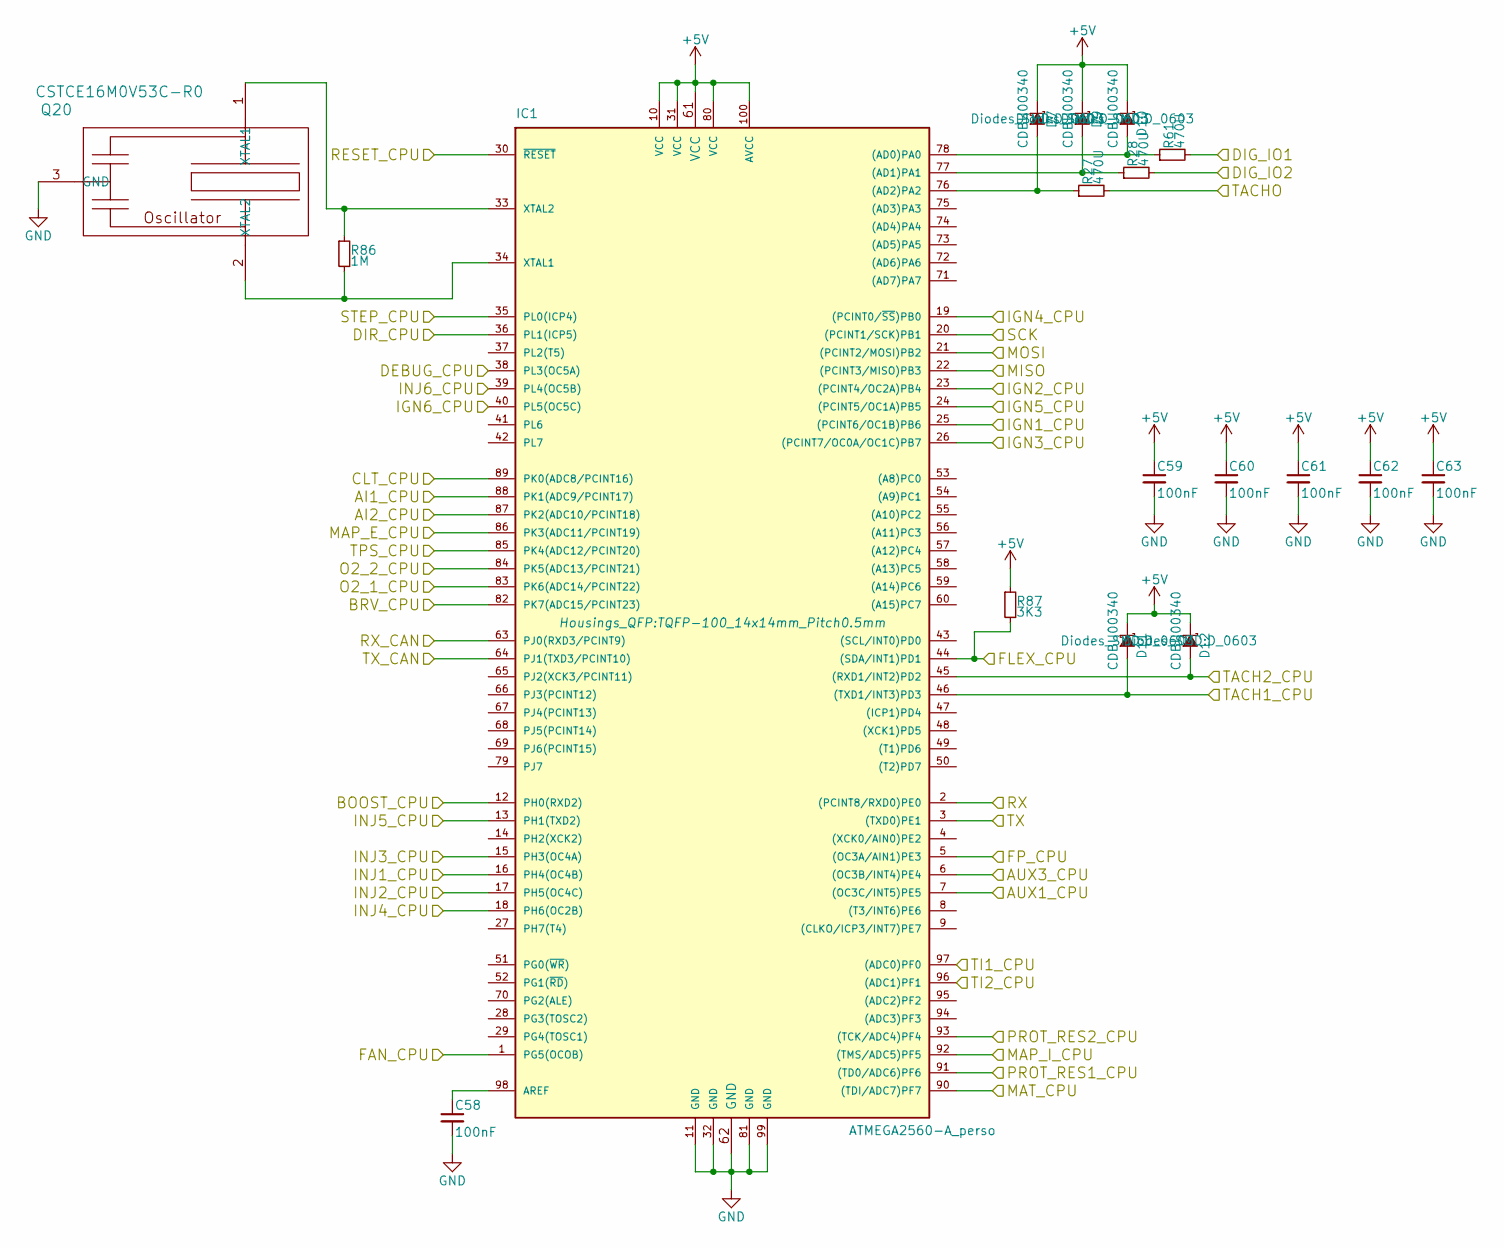
[picture p34: schematic uC_level.sch]

Parts:
C58, C59, C60, C61, C62, C63: 100nF; C_0603_HandSoldering
D7, D9, D10, D11, D12: CDBU00340; D_0603
IC1: ATMEGA2560-A_perso; TQFP-100_14x14mm_Pitch0.5mm
Q20: CSTCE16M0V53C-R0; 16MHz_Oscillator
R27, R28, R61: 470U; R_0603_HandSoldering
R86: 1M; R_0603_HandSoldering
R87: 3K3; R_0603_HandSoldering

Connections:
+5V: C59.1, C60.1, C61.1, C62.1, C63.1, D7.1 (K), D9.1 (K), D10.1 (K), D11.1 (K), D12.1 (K), IC1.10 (VCC), IC1.31 (VCC), IC1.61 (VCC), IC1.80 (VCC), IC1.100 (AVCC), R87.1; also elsewhere on the board
/AnalogInputs/AI1_CPU: IC1.88 (PK1(ADC9/PCINT17)); also elsewhere on the board
/AnalogInputs/AI2_CPU: IC1.87 (PK2(ADC10/PCINT18)); also elsewhere on the board
/AnalogInputs/CLT_CPU: IC1.89 (PK0(ADC8/PCINT16)); also elsewhere on the board
/AnalogInputs/MAP_E_CPU: IC1.86 (PK3(ADC11/PCINT19)); also elsewhere on the board
/AnalogInputs/MAT_CPU: IC1.90 ((TDI/ADC7)PF7); also elsewhere on the board
/AnalogInputs/O2_1_CPU: IC1.83 (PK6(ADC14/PCINT22)); also elsewhere on the board
/AnalogInputs/O2_2_CPU: IC1.84 (PK5(ADC13/PCINT21)); also elsewhere on the board
/AnalogInputs/PROT_RES1_CPU: IC1.91 ((TD0/ADC6)PF6); also elsewhere on the board
/AnalogInputs/PROT_RES2_CPU: IC1.93 ((TCK/ADC4)PF4); also elsewhere on the board
/AnalogInputs/TI1_CPU: IC1.97 ((ADC0)PF0); also elsewhere on the board
/AnalogInputs/TI2_CPU: IC1.96 ((ADC1)PF1); also elsewhere on the board
/AnalogInputs/TPS_CPU: IC1.85 (PK4(ADC12/PCINT20)); also elsewhere on the board
/BattRefVolt/BRV_CPU: IC1.82 (PK7(ADC15/PCINT23)); also elsewhere on the board
/CanBus/RX_CAN: IC1.63 (PJ0(RXD3/PCINT9)); also elsewhere on the board
/CanBus/TX_CAN: IC1.64 (PJ1(TXD3/PCINT10)); also elsewhere on the board
/Connectors/DIG_IO1: R61.2; also elsewhere on the board
/Connectors/DIG_IO2: R28.2; also elsewhere on the board
/Connectors/TACHO: R27.2; also elsewhere on the board
/CrkCam/TACH1_CPU: D11.2 (A), IC1.46 ((TXD1/INT3)PD3); also elsewhere on the board
/CrkCam/TACH2_CPU: D12.2 (A), IC1.45 ((RXD1/INT2)PD2); also elsewhere on the board
/ISP/MISO: IC1.22 ((PCINT3/MISO)PB3); also elsewhere on the board
/ISP/MOSI: IC1.21 ((PCINT2/MOSI)PB2); also elsewhere on the board
/ISP/RESET_CPU: IC1.30 (~RESET); also elsewhere on the board
/ISP/SCK: IC1.20 ((PCINT1/SCK)PB1); also elsewhere on the board
/IgnOut/IGN1_CPU: IC1.25 ((PCINT6/OC1B)PB6); also elsewhere on the board
/IgnOut/IGN2_CPU: IC1.23 ((PCINT4/OC2A)PB4); also elsewhere on the board
/IgnOut/IGN3_CPU: IC1.26 ((PCINT7/OC0A/OC1C)PB7); also elsewhere on the board
/IgnOut/IGN4_CPU: IC1.19 ((PCINT0/~SS~)PB0); also elsewhere on the board
/IgnOut/IGN5_CPU: IC1.24 ((PCINT5/OC1A)PB5); also elsewhere on the board
/IgnOut/IGN6_CPU: IC1.40 (PL5(OC5C)); also elsewhere on the board
/IntMap/MAP_I_CPU: IC1.92 ((TMS/ADC5)PF5); also elsewhere on the board
/LEDs/DEBUG_CPU: IC1.38 (PL3(OC5A)); also elsewhere on the board
/PwrOut/AUX1_CPU: IC1.7 ((OC3C/INT5)PE5); also elsewhere on the board
/PwrOut/AUX3_CPU: IC1.6 ((OC3B/INT4)PE4); also elsewhere on the board
/PwrOut/BOOST_CPU: IC1.12 (PH0(RXD2)); also elsewhere on the board
/PwrOut/DIR_CPU: IC1.36 (PL1(ICP5)); also elsewhere on the board
/PwrOut/FAN_CPU: IC1.1 (PG5(OCOB)); also elsewhere on the board
/PwrOut/FP_CPU: IC1.5 ((OC3A/AIN1)PE3); also elsewhere on the board
/PwrOut/INJ1_CPU: IC1.16 (PH4(OC4B)); also elsewhere on the board
/PwrOut/INJ2_CPU: IC1.17 (PH5(OC4C)); also elsewhere on the board
/PwrOut/INJ3_CPU: IC1.15 (PH3(OC4A)); also elsewhere on the board
/PwrOut/INJ4_CPU: IC1.18 (PH6(OC2B)); also elsewhere on the board
/PwrOut/INJ5_CPU: IC1.13 (PH1(TXD2)); also elsewhere on the board
/PwrOut/INJ6_CPU: IC1.39 (PL4(OC5B)); also elsewhere on the board
/PwrOut/STEP_CPU: IC1.35 (PL0(ICP4)); also elsewhere on the board
/UsbCom/RX: IC1.2 ((PCINT8/RXD0)PE0); also elsewhere on the board
/UsbCom/TX: IC1.3 ((TXD0)PE1); also elsewhere on the board
/uC_level/FLEX_CPU: IC1.44 ((SDA/INT1)PD1), R87.2
GND: C58.2, C59.2, C60.2, C61.2, C62.2, C63.2, IC1.11 (GND), IC1.32 (GND), IC1.62 (GND), IC1.81 (GND), IC1.99 (GND), Q20.3 (GND); also elsewhere on the board
unnamed: C58.1, IC1.98 (AREF)
unnamed: D7.2 (A), IC1.76 ((AD2)PA2), R27.1
unnamed: D9.2 (A), IC1.77 ((AD1)PA1), R28.1
unnamed: D10.2 (A), IC1.78 ((AD0)PA0), R61.1
unnamed: IC1.33 (XTAL2), Q20.1 (XTAL1), R86.1
unnamed: IC1.34 (XTAL1), Q20.2 (XTAL2), R86.2

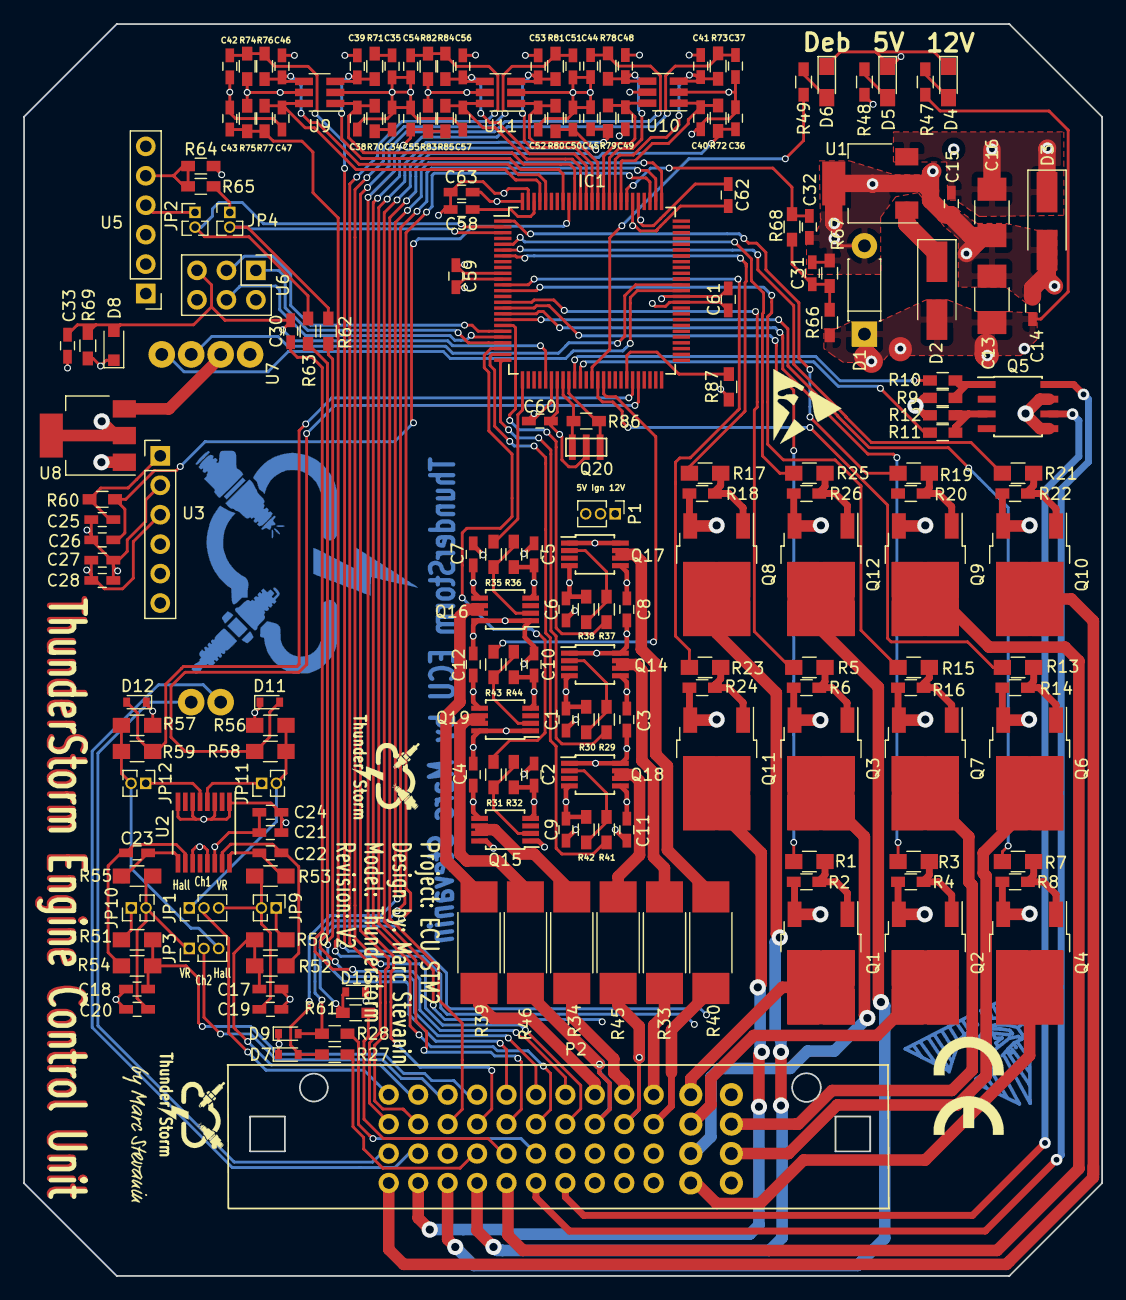
[picture p35: board STM2_ECU.kicad_pcb from above]

Board: 4 copper layers, 93.0 x 108.0 mm, 201 parts (0 on the bottom side), 145 nets.
