mstevanin4/ECU_STM_V1/STM2_ECU/SW/ECU_SW/Thunderstorm_Trunk/speeduino_202501_4/speeduino/decoders.cpp

#define MJR 1

/*
Speeduino - Simple engine management for the Arduino Mega 2560 platform
Copyright (C) Josh Stewart
A full copy of the license may be found in the projects root directory
*/

/** @file
 * 
 * Crank and Cam decoders
 * 
 * This file contains the various crank and cam wheel decoder functions.
 * Each decoder must have the following 4 functions (Where xxxx is the decoder name):
 * 
 * - **triggerSetup_xxxx** - Called once from within setup() and configures any required variables
 * - **triggerPri_xxxx** - Called each time the primary (No. 1) crank/cam signal is triggered (Called as an interrupt, so variables must be declared volatile)
 * - **triggerSec_xxxx** - Called each time the secondary (No. 2) crank/cam signal is triggered (Called as an interrupt, so variables must be declared volatile)
 * - **getRPM_xxxx** - Returns the current RPM, as calculated by the decoder
 * - **getCrankAngle_xxxx** - Returns the current crank angle, as calculated by the decoder
 * - **getCamAngle_xxxx** - Returns the current CAM angle, as calculated by the decoder
 *
 * Each decoder must utilise at least the following variables:
 * 
 * - toothLastToothTime - The time (In uS) that the last primary tooth was 'seen'
 */

/* Notes on Doxygen Groups/Modules documentation style:
 * - Installing doxygen (e.g. Ubuntu) via pkg mgr: sudo apt-get install doxygen graphviz
 * - @defgroup tag name/description becomes the short name on (Doxygen) "Modules" page
 * - Relying on JAVADOC_AUTOBRIEF (in Doxyfile, essentially automatic @brief), the first sentence (ending with period) becomes
 *   the longer description (second column following name) on (Doxygen) "Modules" page (old Desc: ... could be this sentence)
 * - All the content after first sentence (like old Note:...) is visible on the page linked from the name (1st col) on "Modules" page
 * - To group all decoders together add 1) @defgroup dec Decoders (on top) and 2) "@ingroup dec" to each decoder (under @defgroup)
 * - To compare Speeduino Doxyfile to default config, do: `doxygen -g Doxyfile.default ; diff Doxyfile.default Doxyfile`
 */
#include <limits.h>
#include <SimplyAtomic.h>
#include "globals.h"
#include "decoders.h"
#include "scheduledIO.h"
#include "scheduler.h"
#include "crankMaths.h"
#include "timers.h"
#include "schedule_calcs.h"
#include "unit_testing.h"

void nullTriggerHandler (void){return;} //initialisation function for triggerhandlers, does exactly nothing
uint16_t nullGetRPM(void){return 0;} //initialisation function for getRpm, returns safe value of 0
int nullGetCrankAngle(void){return 0;} //initialisation function for getCrankAngle, returns safe value of 0

void (*triggerHandler)(void) = nullTriggerHandler; ///Pointer for the trigger function (Gets pointed to the relevant decoder)
void (*triggerSecondaryHandler)(void) = nullTriggerHandler; ///Pointer for the secondary trigger function (Gets pointed to the relevant decoder)
void (*triggerTertiaryHandler)(void) = nullTriggerHandler; ///Pointer for the tertiary trigger function (Gets pointed to the relevant decoder)
uint16_t (*getRPM)(void) = nullGetRPM; ///Pointer to the getRPM function (Gets pointed to the relevant decoder)
int (*getCrankAngle)(void) = nullGetCrankAngle; ///Pointer to the getCrank Angle function (Gets pointed to the relevant decoder)
void (*triggerSetEndTeeth)(void) = triggerSetEndTeeth_missingTooth; ///Pointer to the triggerSetEndTeeth function of each decoder

static void triggerRoverMEMSCommon(void);
static inline void triggerRecordVVT1Angle (void);

volatile unsigned long curTime;
volatile unsigned long curGap;
volatile unsigned long curTime2;
volatile unsigned long curGap2;
volatile unsigned long curTime3;
volatile unsigned long curGap3;
volatile unsigned long lastGap;
volatile unsigned long targetGap;

TESTABLE_STATIC unsigned long MAX_STALL_TIME = MICROS_PER_SEC/2U; //The maximum time (in uS) that the system will continue to function before the engine is considered stalled/stopped. This is unique to each decoder, depending on the number of teeth etc. 500000 (half a second) is used as the default value, most decoders will be much less.
volatile uint16_t toothCurrentCount = 0; //The current number of teeth (Once sync has been achieved, this can never actually be 0
static volatile byte toothSystemCount = 0; //Used for decoders such as Audi 135 where not every tooth is used for calculating crank angle. This variable stores the actual number of teeth, not the number being used to calculate crank angle
volatile unsigned long toothSystemLastToothTime = 0; //As below, but used for decoders where not every tooth count is used for calculation
TESTABLE_STATIC volatile unsigned long toothLastToothTime = 0; //The time (micros()) that the last tooth was registered
static volatile unsigned long toothLastSecToothTime = 0; //The time (micros()) that the last tooth was registered on the secondary input
volatile unsigned long toothLastThirdToothTime = 0; //The time (micros()) that the last tooth was registered on the second cam input
volatile unsigned long toothLastMinusOneToothTime = 0; //The time (micros()) that the tooth before the last tooth was registered
volatile unsigned long toothLastMinusOneSecToothTime = 0; //The time (micros()) that the tooth before the last tooth was registered on secondary input
volatile unsigned long toothLastToothRisingTime = 0; //The time (micros()) that the last tooth rose (used by special decoders to determine missing teeth polarity)
volatile unsigned long toothLastSecToothRisingTime = 0; //The time (micros()) that the last tooth rose on the secondary input (used by special decoders to determine missing teeth polarity)
volatile unsigned long targetGap2;
volatile unsigned long targetGap3;
volatile unsigned long toothOneTime = 0; //The time (micros()) that tooth 1 last triggered
volatile unsigned long toothOneMinusOneTime = 0; //The 2nd to last time (micros()) that tooth 1 last triggered
volatile bool revolutionOne = 0; // For sequential operation, this tracks whether the current revolution is 1 or 2 (not 1)
volatile bool revolutionLastOne = 0; // used to identify in the rover pattern which has a non unique primary trigger something unique - has the secondary tooth changed.

static volatile unsigned int secondaryToothCount; //Used for identifying the current secondary (Usually cam) tooth for patterns with multiple secondary teeth
volatile unsigned int secondaryLastToothCount = 0; // used to identify in the rover pattern which has a non unique primary trigger something unique - has the secondary tooth changed.
volatile unsigned long secondaryLastToothTime = 0; //The time (micros()) that the last tooth was registered (Cam input)
volatile unsigned long secondaryLastToothTime1 = 0; //The time (micros()) that the last tooth was registered (Cam input)

volatile unsigned int thirdToothCount; //Used for identifying the current third (Usually exhaust cam - used for VVT2) tooth for patterns with multiple secondary teeth
volatile unsigned long thirdLastToothTime = 0; //The time (micros()) that the last tooth was registered (Cam input)
volatile unsigned long thirdLastToothTime1 = 0; //The time (micros()) that the last tooth was registered (Cam input)

uint16_t triggerActualTeeth;
volatile unsigned long triggerFilterTime; // The shortest time (in uS) that pulses will be accepted (Used for debounce filtering)
volatile unsigned long triggerSecFilterTime; // The shortest time (in uS) that pulses will be accepted (Used for debounce filtering) for the secondary input
volatile unsigned long triggerThirdFilterTime; // The shortest time (in uS) that pulses will be accepted (Used for debounce filtering) for the Third input

volatile uint8_t decoderState = 0;

unsigned int triggerSecFilterTime_duration; // The shortest valid time (in uS) pulse DURATION
volatile uint16_t triggerToothAngle; //The number of crank degrees that elapse per tooth
byte checkSyncToothCount; //How many teeth must've been seen on this revolution before we try to confirm sync (Useful for missing tooth type decoders)
unsigned long elapsedTime;
unsigned long lastCrankAngleCalc;
unsigned long lastVVTtime; //The time between the vvt reference pulse and the last crank pulse

uint16_t ignition1EndTooth = 0;
uint16_t ignition2EndTooth = 0;
uint16_t ignition3EndTooth = 0;
uint16_t ignition4EndTooth = 0;
uint16_t ignition5EndTooth = 0;
uint16_t ignition6EndTooth = 0;
uint16_t ignition7EndTooth = 0;
uint16_t ignition8EndTooth = 0;

int16_t toothAngles[24]; //An array for storing fixed tooth angles. Currently sized at 24 for the GM 24X decoder, but may grow later if there are other decoders that use this style

#ifdef USE_LIBDIVIDE
#include "src/libdivide/libdivide.h"
static libdivide::libdivide_s16_t divTriggerToothAngle;
#endif

/** Universal (shared between decoders) decoder routines.
*
* @defgroup dec_uni Universal Decoder Routines
* 
* @{
*/
// whichTooth - 0 for Primary (Crank), 1 for Secondary (Cam)

/** Add tooth log entry to toothHistory (array).
 * Enabled by (either) currentStatus.toothLogEnabled and currentStatus.compositeTriggerUsed.
 * @param toothTime - Tooth Time
 * @param whichTooth - 0 for Primary (Crank), 2 for Secondary (Cam) 3 for Tertiary (Cam)
 */
static inline void addToothLogEntry(unsigned long toothTime, byte whichTooth)
{
  if(BIT_CHECK(currentStatus.status1, BIT_STATUS1_TOOTHLOG1READY)) { return; }
  //High speed tooth logging history
  if( (currentStatus.toothLogEnabled == true) || (currentStatus.compositeTriggerUsed > 0) ) 
  {
    bool valueLogged = false;
    if(currentStatus.toothLogEnabled == true)
    {
      //Tooth log only works on the Crank tooth
      if(whichTooth == TOOTH_CRANK)
      { 
        toothHistory[toothHistoryIndex] = toothTime; //Set the value in the log. 
        valueLogged = true;
      } 
    }
    else if(currentStatus.compositeTriggerUsed > 0)
    {
      compositeLogHistory[toothHistoryIndex] = 0;
      if(currentStatus.compositeTriggerUsed == 4)
      {
        // we want to display both cams so swap the values round to display primary as cam1 and secondary as cam2, include the crank in the data as the third output
        if(READ_SEC_TRIGGER() == true) { BIT_SET(compositeLogHistory[toothHistoryIndex], COMPOSITE_LOG_PRI); }
        if(READ_THIRD_TRIGGER() == true) { BIT_SET(compositeLogHistory[toothHistoryIndex], COMPOSITE_LOG_SEC); }
        if(READ_PRI_TRIGGER() == true) { BIT_SET(compositeLogHistory[toothHistoryIndex], COMPOSITE_LOG_THIRD); }
        if(whichTooth > TOOTH_CAM_SECONDARY) { BIT_SET(compositeLogHistory[toothHistoryIndex], COMPOSITE_LOG_TRIG); }
      }
      else
      {
        // we want to display crank and one of the cams
        if(READ_PRI_TRIGGER() == true) { BIT_SET(compositeLogHistory[toothHistoryIndex], COMPOSITE_LOG_PRI); }
        if(currentStatus.compositeTriggerUsed == 3)
        { 
          // display cam2 and also log data for cam 1
          if(READ_THIRD_TRIGGER() == true) { BIT_SET(compositeLogHistory[toothHistoryIndex], COMPOSITE_LOG_SEC); } // only the COMPOSITE_LOG_SEC value is visualised hence the swapping of the data
          if(READ_SEC_TRIGGER() == true) { BIT_SET(compositeLogHistory[toothHistoryIndex], COMPOSITE_LOG_THIRD); } 
        } 
        else
        { 
          // display cam1 and also log data for cam 2 - this is the historic composite view
          if(READ_SEC_TRIGGER() == true) { BIT_SET(compositeLogHistory[toothHistoryIndex], COMPOSITE_LOG_SEC); } 
          if(READ_THIRD_TRIGGER() == true) { BIT_SET(compositeLogHistory[toothHistoryIndex], COMPOSITE_LOG_THIRD); }
        }
        if(whichTooth > TOOTH_CRANK) { BIT_SET(compositeLogHistory[toothHistoryIndex], COMPOSITE_LOG_TRIG); }
      }  
      if(currentStatus.hasSync == true) { BIT_SET(compositeLogHistory[toothHistoryIndex], COMPOSITE_LOG_SYNC); }

      if(revolutionOne == 1)
      { BIT_SET(compositeLogHistory[toothHistoryIndex], COMPOSITE_ENGINE_CYCLE);}
      else
      { BIT_CLEAR(compositeLogHistory[toothHistoryIndex], COMPOSITE_ENGINE_CYCLE);}

      toothHistory[toothHistoryIndex] = micros();
      valueLogged = true;
    }

    //If there has been a value logged above, update the indexes
    if(valueLogged == true)
    {
     if(toothHistoryIndex < (TOOTH_LOG_SIZE-1)) { toothHistoryIndex++; BIT_CLEAR(currentStatus.status1, BIT_STATUS1_TOOTHLOG1READY); }
     else { BIT_SET(currentStatus.status1, BIT_STATUS1_TOOTHLOG1READY); }
    }


  } //Tooth/Composite log enabled
}

/** Interrupt handler for primary trigger.
* This function is called on both the rising and falling edges of the primary trigger, when either the 
* composite or tooth loggers are turned on. 
*/
void loggerPrimaryISR(void)
{
  BIT_CLEAR(decoderState, BIT_DECODER_VALID_TRIGGER); //This value will be set to the return value of the decoder function, indicating whether or not this pulse passed the filters
  bool validEdge = false; //This is set true below if the edge 
  /* 
  Need to still call the standard decoder trigger. 
  Two checks here:
  1) If the primary trigger is RISING, then check whether the primary is currently HIGH
  2) If the primary trigger is FALLING, then check whether the primary is currently LOW
  If either of these are true, the primary decoder function is called
  */
  if( ( (primaryTriggerEdge == RISING) && (READ_PRI_TRIGGER() == HIGH) ) || ( (primaryTriggerEdge == FALLING) && (READ_PRI_TRIGGER() == LOW) ) || (primaryTriggerEdge == CHANGE) )
  {
    triggerHandler();
    validEdge = true;
  }
  if( (currentStatus.toothLogEnabled == true) && (BIT_CHECK(decoderState, BIT_DECODER_VALID_TRIGGER)) )
  {
    //Tooth logger only logs when the edge was correct
    if(validEdge == true) 
    { 
      addToothLogEntry(curGap, TOOTH_CRANK);
    }
  }
  else if( (currentStatus.compositeTriggerUsed > 0) )
  {
    //Composite logger adds an entry regardless of which edge it was
    addToothLogEntry(curGap, TOOTH_CRANK);
  }
}

/** Interrupt handler for secondary trigger.
* As loggerPrimaryISR, but for the secondary trigger.
*/
void loggerSecondaryISR(void)
{
  BIT_CLEAR(decoderState, BIT_DECODER_VALID_TRIGGER); //This value will be set to the return value of the decoder function, indicating whether or not this pulse passed the filters
  BIT_SET(decoderState, BIT_DECODER_VALID_TRIGGER); //This value will be set to the return value of the decoder function, indicating whether or not this pulse passed the filters
  /* 3 checks here:
  1) If the primary trigger is RISING, then check whether the primary is currently HIGH
  2) If the primary trigger is FALLING, then check whether the primary is currently LOW
  3) The secondary trigger is CHANGING
  If any of these are true, the primary decoder function is called
  */
  if( ( (secondaryTriggerEdge == RISING) && (READ_SEC_TRIGGER() == HIGH) ) || ( (secondaryTriggerEdge == FALLING) && (READ_SEC_TRIGGER() == LOW) ) || (secondaryTriggerEdge == CHANGE) )
  {
    triggerSecondaryHandler();
  }
  //No tooth logger for the secondary input
  if( (currentStatus.compositeTriggerUsed > 0) && (BIT_CHECK(decoderState, BIT_DECODER_VALID_TRIGGER)) )
  {
    //Composite logger adds an entry regardless of which edge it was
    addToothLogEntry(curGap2, TOOTH_CAM_SECONDARY);
  }
}

/** Interrupt handler for third trigger.
* As loggerPrimaryISR, but for the third trigger.
*/
void loggerTertiaryISR(void)
{
  BIT_CLEAR(decoderState, BIT_DECODER_VALID_TRIGGER); //This value will be set to the return value of the decoder function, indicating whether or not this pulse passed the filters
  BIT_SET(decoderState, BIT_DECODER_VALID_TRIGGER); //This value will be set to the return value of the decoder function, indicating whether or not this pulse passed the filters
  /* 3 checks here:
  1) If the primary trigger is RISING, then check whether the primary is currently HIGH
  2) If the primary trigger is FALLING, then check whether the primary is currently LOW
  3) The secondary trigger is CHANGING
  If any of these are true, the primary decoder function is called
  */
  
  
  if( ( (tertiaryTriggerEdge == RISING) && ( READ_THIRD_TRIGGER() == HIGH) ) || ( (tertiaryTriggerEdge == FALLING) && (READ_THIRD_TRIGGER() == LOW) ) || (tertiaryTriggerEdge == CHANGE) )
  {
    triggerTertiaryHandler();
  }
  //No tooth logger for the secondary input
  if( (currentStatus.compositeTriggerUsed > 0) && (BIT_CHECK(decoderState, BIT_DECODER_VALID_TRIGGER)) )
  {
    //Composite logger adds an entry regardless of which edge it was
    addToothLogEntry(curGap3, TOOTH_CAM_TERTIARY);
  }  
}

#if false
#if !defined(UNIT_TEST)
static
#endif
uint32_t angleToTimeIntervalTooth(uint16_t angle) {
  noInterrupts();
  if(BIT_CHECK(decoderState, BIT_DECODER_TOOTH_ANG_CORRECT))
  {
    unsigned long toothTime = (toothLastToothTime - toothLastMinusOneToothTime);
    uint16_t tempTriggerToothAngle = triggerToothAngle; // triggerToothAngle is set by interrupts
    interrupts();
    
    return (toothTime * (uint32_t)angle) / tempTriggerToothAngle;
  }
  //Safety check. This can occur if the last tooth seen was outside the normal pattern etc
  else { 
    interrupts();
    return angleToTimeMicroSecPerDegree(angle); 
  }
}
#endif

static uint16_t timeToAngleIntervalTooth(uint32_t time)
{
    noInterrupts();
    //Still uses a last interval method (ie retrospective), but bases the interval on the gap between the 2 most recent teeth rather than the last full revolution
    if(BIT_CHECK(decoderState, BIT_DECODER_TOOTH_ANG_CORRECT))
    {
      unsigned long toothTime = (toothLastToothTime - toothLastMinusOneToothTime);
      uint16_t tempTriggerToothAngle = triggerToothAngle; // triggerToothAngle is set by interrupts
      interrupts();

      return (unsigned long)(time * (uint32_t)tempTriggerToothAngle) / toothTime;
    }
    else { 
      interrupts();
      //Safety check. This can occur if the last tooth seen was outside the normal pattern etc
      return timeToAngleDegPerMicroSec(time);
    }
}

static inline bool IsCranking(const statuses &status) {
  return (status.RPM < status.crankRPM) && (status.startRevolutions == 0U);
}

bool engineIsRunning(uint32_t curTime) {
  // Check how long ago the last tooth was seen compared to now. 
  // If it was more than MAX_STALL_TIME then the engine is probably stopped. 
  // toothLastToothTime can be greater than curTime if a pulse occurs between getting the latest time and doing the comparison
  ATOMIC() {
    return (toothLastToothTime > curTime) || ((curTime - toothLastToothTime) < MAX_STALL_TIME); 
  }
  return false; // Just here to avoid compiler warning.
}

void resetDecoder(void) {
  toothLastSecToothTime = 0;
  toothLastToothTime = 0;
  toothSystemCount = 0;
  secondaryToothCount = 0;
}

#if defined(UNIT_TEST)
bool SetRevolutionTime(uint32_t revTime)
#else
static __attribute__((noinline)) bool SetRevolutionTime(uint32_t revTime)
#endif
{
  if (revTime!=revolutionTime) {
    revolutionTime = revTime;
    setAngleConverterRevolutionTime(revolutionTime);
    return true;
  } 
  return false;
}

static bool UpdateRevolutionTimeFromTeeth(bool isCamTeeth) {
  noInterrupts();
  bool updatedRevTime = HasAnySync(currentStatus) 
    && !IsCranking(currentStatus)
    && (toothOneMinusOneTime!=UINT32_C(0))
    && (toothOneTime>toothOneMinusOneTime) 
    //The time in uS that one revolution would take at current speed (The time tooth 1 was last seen, minus the time it was seen prior to that)
    && SetRevolutionTime((toothOneTime - toothOneMinusOneTime) >> (isCamTeeth ? 1U : 0U)); 

  interrupts();
 return updatedRevTime;  
}

static inline uint16_t clampRpm(uint16_t rpm) {
    return rpm>=MAX_RPM ? currentStatus.RPM : rpm;
}

static inline uint16_t RpmFromRevolutionTimeUs(uint32_t revTime) {
  if (revTime<UINT16_MAX) {
    return clampRpm(udiv_32_16_closest(MICROS_PER_MIN, revTime));
  } else {
    return clampRpm((uint16_t)UDIV_ROUND_CLOSEST(MICROS_PER_MIN, revTime, uint32_t)); //Calc RPM based on last full revolution time (Faster as /)
  }
}

/** Compute RPM.
* As nearly all the decoders use a common method of determining RPM (The time the last full revolution took) A common function is simpler.
* @param degreesOver - the number of crank degrees between tooth #1s. Some patterns have a tooth #1 every crank rev, others are every cam rev.
* @return RPM
*/
static __attribute__((noinline)) uint16_t stdGetRPM(bool isCamTeeth)
{
  if (UpdateRevolutionTimeFromTeeth(isCamTeeth)) {
    return RpmFromRevolutionTimeUs(revolutionTime);
  }

  return currentStatus.RPM;
}

/**
 * Sets the new filter time based on the current settings.
 * This ONLY works for even spaced decoders.
 */
static void setFilter(unsigned long curGap)
{
  /*
  if(configPage4.triggerFilter == 0) { triggerFilterTime = 0; } //trigger filter is turned off.
  else if(configPage4.triggerFilter == 1) { triggerFilterTime = curGap >> 2; } //Lite filter level is 25% of previous gap
  else if(configPage4.triggerFilter == 2) { triggerFilterTime = curGap >> 1; } //Medium filter level is 50% of previous gap
  else if (configPage4.triggerFilter == 3) { triggerFilterTime = (curGap * 3) >> 2; } //Aggressive filter level is 75% of previous gap
  else { triggerFilterTime = 0; } //trigger filter is turned off.
  */

  switch(configPage4.triggerFilter)
  {
    case TRIGGER_FILTER_OFF: 
      triggerFilterTime = 0;
      break;
    case TRIGGER_FILTER_LITE: 
      triggerFilterTime = curGap >> 2;
      break;
    case TRIGGER_FILTER_MEDIUM: 
      triggerFilterTime = curGap >> 1;
      break;
    case TRIGGER_FILTER_AGGRESSIVE: 
      triggerFilterTime = (curGap * 3) >> 2;
      break;
    default:
      triggerFilterTime = 0;
      break;
  }
}

/**
This is a special case of RPM measure that is based on the time between the last 2 teeth rather than the time of the last full revolution.
This gives much more volatile reading, but is quite useful during cranking, particularly on low resolution patterns.
It can only be used on patterns where the teeth are evenly spaced.
It takes an argument of the full (COMPLETE) number of teeth per revolution.
For a missing tooth wheel, this is the number if the tooth had NOT been missing (Eg 36-1 = 36)
*/
static __attribute__((noinline)) int crankingGetRPM(byte totalTeeth, bool isCamTeeth)
{
  if( (currentStatus.startRevolutions >= configPage4.StgCycles) && ((currentStatus.hasSync == true) || BIT_CHECK(currentStatus.status3, BIT_STATUS3_HALFSYNC)) )
  {
    if((toothLastMinusOneToothTime > 0) && (toothLastToothTime > toothLastMinusOneToothTime) )
    {
      noInterrupts();
      bool newRevtime = SetRevolutionTime(((toothLastToothTime - toothLastMinusOneToothTime) * totalTeeth) >> (isCamTeeth ? 1U : 0U));
      interrupts();
      if (newRevtime) {
        return RpmFromRevolutionTimeUs(revolutionTime);
      }
    }
  }

  return currentStatus.RPM;
}

/**
On decoders that are enabled for per tooth based timing adjustments, this function performs the timer compare changes on the schedules themselves
For each ignition channel, a check is made whether we're at the relevant tooth and whether that ignition schedule is currently running
Only if both these conditions are met will the schedule be updated with the latest timing information.
If it's the correct tooth, but the schedule is not yet started, calculate and an end compare value (This situation occurs when both the start and end of the ignition pulse happen after the end tooth, but before the next tooth)
*/
static inline void checkPerToothTiming(int16_t crankAngle, uint16_t currentTooth)
{
  if ( (fixedCrankingOverride == 0) && (currentStatus.RPM > 0) )
  {
    if ( (currentTooth == ignition1EndTooth) )
    {
      adjustCrankAngle(ignitionSchedule1, ignition1EndAngle, crankAngle);
    }
    else if ( (currentTooth == ignition2EndTooth) )
    {
      adjustCrankAngle(ignitionSchedule2, ignition2EndAngle, crankAngle);
    }
    else if ( (currentTooth == ignition3EndTooth) )
    {
      adjustCrankAngle(ignitionSchedule3, ignition3EndAngle, crankAngle);
    }
    else if ( (currentTooth == ignition4EndTooth) )
    {
      adjustCrankAngle(ignitionSchedule4, ignition4EndAngle, crankAngle);
    }
#if IGN_CHANNELS >= 5
    else if ( (currentTooth == ignition5EndTooth) )
    {
      adjustCrankAngle(ignitionSchedule5, ignition5EndAngle, crankAngle);
    }
#endif
#if IGN_CHANNELS >= 6
    else if ( (currentTooth == ignition6EndTooth) )
    {
      adjustCrankAngle(ignitionSchedule6, ignition6EndAngle, crankAngle);
    }
#endif
#if IGN_CHANNELS >= 7
    else if ( (currentTooth == ignition7EndTooth) )
    {
      adjustCrankAngle(ignitionSchedule7, ignition7EndAngle, crankAngle);
    }
#endif
#if IGN_CHANNELS >= 8
    else if ( (currentTooth == ignition8EndTooth) )
    {
      adjustCrankAngle(ignitionSchedule8, ignition8EndAngle, crankAngle);
    }
#endif
  }
}
/** @} */
  
/** A (single) multi-tooth wheel with one of more 'missing' teeth.
* The first tooth after the missing one is considered number 1 and is the basis for the trigger angle.
* Optionally a cam signal can be added to provide a sequential reference. 
* @defgroup dec_miss Missing tooth wheel
* @{
*/
void triggerSetup_missingTooth(void)
{
  BIT_CLEAR(decoderState, BIT_DECODER_IS_SEQUENTIAL);
  triggerToothAngle = 360 / configPage4.triggerTeeth; //The number of degrees that passes from tooth to tooth
  if(configPage4.TrigSpeed == CAM_SPEED) 
  { 
    //Account for cam speed missing tooth
    triggerToothAngle = 720 / configPage4.triggerTeeth; 
    BIT_SET(decoderState, BIT_DECODER_IS_SEQUENTIAL);
  } 
  triggerActualTeeth = configPage4.triggerTeeth - configPage4.triggerMissingTeeth; //The number of physical teeth on the wheel. Doing this here saves us a calculation each time in the interrupt
  triggerFilterTime = (MICROS_PER_SEC / (MAX_RPM / 60U * configPage4.triggerTeeth)); //Trigger filter time is the shortest possible time (in uS) that there can be between crank teeth (ie at max RPM). Any pulses that occur faster than this time will be discarded as noise
  if (configPage4.trigPatternSec == SEC_TRIGGER_4_1)
  {
    triggerSecFilterTime = MICROS_PER_MIN / MAX_RPM / 4U / 2U;
  }
  else 
  {
    triggerSecFilterTime = (MICROS_PER_SEC / (MAX_RPM / 60U));
  }
  BIT_CLEAR(decoderState, BIT_DECODER_2ND_DERIV);
  checkSyncToothCount = (configPage4.triggerTeeth) >> 1; //50% of the total teeth.
  toothLastMinusOneToothTime = 0;
  toothCurrentCount = 0;
  secondaryToothCount = 0; 
  thirdToothCount = 0;
  toothOneTime = 0;
  toothOneMinusOneTime = 0;
  MAX_STALL_TIME = ((MICROS_PER_DEG_1_RPM/50U) * triggerToothAngle * (configPage4.triggerMissingTeeth + 1U)); //Minimum 50rpm. (3333uS is the time per degree at 50rpm)

  if( (configPage4.TrigSpeed == CRANK_SPEED) && ( (configPage4.sparkMode == IGN_MODE_SEQUENTIAL) || (configPage2.injLayout == INJ_SEQUENTIAL) || (configPage6.vvtEnabled > 0)) ) { BIT_SET(decoderState, BIT_DECODER_HAS_SECONDARY); }
  else { BIT_CLEAR(decoderState, BIT_DECODER_HAS_SECONDARY); }
#ifdef USE_LIBDIVIDE
  divTriggerToothAngle = libdivide::libdivide_s16_gen(triggerToothAngle);
#endif  
}

void triggerPri_missingTooth(void)
{
   curTime = micros();
   curGap = curTime - toothLastToothTime;
   if ( curGap >= triggerFilterTime ) //Pulses should never be less than triggerFilterTime, so if they are it means a false trigger. (A 36-1 wheel at 8000pm will have triggers approx. every 200uS)
   {
     toothCurrentCount++; //Increment the tooth counter
     BIT_SET(decoderState, BIT_DECODER_VALID_TRIGGER); //Flag this pulse as being a valid trigger (ie that it passed filters)

     //if(toothCurrentCount > checkSyncToothCount || currentStatus.hasSync == false)
      if( (toothLastToothTime > 0) && (toothLastMinusOneToothTime > 0) )
      {
        bool isMissingTooth = false;

        /*
        Performance Optimisation:
        Only need to try and detect the missing tooth if:
        1. WE don't have sync yet
        2. We have sync and are in the final 1/4 of the wheel (Missing tooth will/should never occur in the first 3/4)
        3. RPM is under 2000. This is to ensure that we don't interfere with strange timing when cranking or idling. Optimisation not really required at these speeds anyway
        */
        if( (currentStatus.hasSync == false) || (currentStatus.RPM < 2000) || (toothCurrentCount >= (3 * triggerActualTeeth >> 2)) )
        {
          //Begin the missing tooth detection
          //If the time between the current tooth and the last is greater than 1.5x the time between the last tooth and the tooth before that, we make the assertion that we must be at the first tooth after the gap
          if(configPage4.triggerMissingTeeth == 1) { targetGap = (3 * (toothLastToothTime - toothLastMinusOneToothTime)) >> 1; } //Multiply by 1.5 (Checks for a gap 1.5x greater than the last one) (Uses bitshift to multiply by 3 then divide by 2. Much faster than multiplying by 1.5)
          else { targetGap = ((toothLastToothTime - toothLastMinusOneToothTime)) * configPage4.triggerMissingTeeth; } //Multiply by 2 (Checks for a gap 2x greater than the last one)

          if( (toothLastToothTime == 0) || (toothLastMinusOneToothTime == 0) ) { curGap = 0; }

          if ( (curGap > targetGap) || (toothCurrentCount > triggerActualTeeth) )
          {
            //Missing tooth detected
            isMissingTooth = true;
            if( (toothCurrentCount < triggerActualTeeth) && (currentStatus.hasSync == true) ) 
            { 
                //This occurs when we're at tooth #1, but haven't seen all the other teeth. This indicates a signal issue so we flag lost sync so this will attempt to resync on the next revolution.
                currentStatus.hasSync = false;
                BIT_CLEAR(currentStatus.status3, BIT_STATUS3_HALFSYNC); //No sync at all, so also clear HalfSync bit.
                currentStatus.syncLossCounter++;
            }
            //This is to handle a special case on startup where sync can be obtained and the system immediately thinks the revs have jumped:
            //else if (currentStatus.hasSync == false && toothCurrentCount < checkSyncToothCount ) { triggerFilterTime = 0; }
            else
            {
                if((currentStatus.hasSync == true) || BIT_CHECK(currentStatus.status3, BIT_STATUS3_HALFSYNC))
                {
                  currentStatus.startRevolutions++; //Counter
                  if ( configPage4.TrigSpeed == CAM_SPEED ) { currentStatus.startRevolutions++; } //Add an extra revolution count if we're running at cam speed
                }
                else { currentStatus.startRevolutions = 0; }
                
                toothCurrentCount = 1;
                if (configPage4.trigPatternSec == SEC_TRIGGER_POLL) // at tooth one check if the cam sensor is high or low in poll level mode
                {
                  if (configPage4.PollLevelPolarity == READ_SEC_TRIGGER()) { revolutionOne = 1; }
                  else { revolutionOne = 0; }
                }
                else {revolutionOne = !revolutionOne;} //Flip sequential revolution tracker if poll level is not used
                toothOneMinusOneTime = toothOneTime;
                toothOneTime = curTime;

                //if Sequential fuel or ignition is in use, further checks are needed before determining sync
                if( (configPage4.sparkMode == IGN_MODE_SEQUENTIAL) || (configPage2.injLayout == INJ_SEQUENTIAL) )
                {
                  //If either fuel or ignition is sequential, only declare sync if the cam tooth has been seen OR if the missing wheel is on the cam
                  if( (secondaryToothCount > 0) || (configPage4.TrigSpeed == CAM_SPEED) || (configPage4.trigPatternSec == SEC_TRIGGER_POLL) || (configPage2.strokes == TWO_STROKE) )
                  {
                    currentStatus.hasSync = true;
                    BIT_CLEAR(currentStatus.status3, BIT_STATUS3_HALFSYNC); //the engine is fully synced so clear the Half Sync bit                    
                  }
                  else if(currentStatus.hasSync != true) { BIT_SET(currentStatus.status3, BIT_STATUS3_HALFSYNC); } //If there is primary trigger but no secondary we only have half sync.
                }
                else { currentStatus.hasSync = true;  BIT_CLEAR(currentStatus.status3, BIT_STATUS3_HALFSYNC); } //If nothing is using sequential, we have sync and also clear half sync bit
                if(configPage4.trigPatternSec == SEC_TRIGGER_SINGLE || configPage4.trigPatternSec == SEC_TRIGGER_TOYOTA_3) //Reset the secondary tooth counter to prevent it overflowing, done outside of sequental as v6 & v8 engines could be batch firing with VVT that needs the cam resetting
                { 
                  secondaryToothCount = 0; 
                } 

                triggerFilterTime = 0; //This is used to prevent a condition where serious intermittent signals (Eg someone furiously plugging the sensor wire in and out) can leave the filter in an unrecoverable state
                toothLastMinusOneToothTime = toothLastToothTime;
                toothLastToothTime = curTime;
                BIT_CLEAR(decoderState, BIT_DECODER_TOOTH_ANG_CORRECT); //The tooth angle is double at this point
            }
          }
        }
        
        if(isMissingTooth == false)
        {
          //Regular (non-missing) tooth
          setFilter(curGap);
          toothLastMinusOneToothTime = toothLastToothTime;
          toothLastToothTime = curTime;
          BIT_SET(decoderState, BIT_DECODER_TOOTH_ANG_CORRECT);
        }
      }
      else
      {
        //We fall here on initial startup when enough teeth have not yet been seen
        toothLastMinusOneToothTime = toothLastToothTime;
        toothLastToothTime = curTime;
      }
     

      //NEW IGNITION MODE
      if( (configPage2.perToothIgn == true) && (!BIT_CHECK(currentStatus.engine, BIT_ENGINE_CRANK)) ) 
      {
        int16_t crankAngle = ( (toothCurrentCount-1) * triggerToothAngle ) + configPage4.triggerAngle;
        if( (configPage4.sparkMode == IGN_MODE_SEQUENTIAL) && (revolutionOne == true) && (configPage4.TrigSpeed == CRANK_SPEED) && (configPage2.strokes == FOUR_STROKE) )
        {
          crankAngle += 360;
          crankAngle = ignitionLimits(crankAngle);
          checkPerToothTiming(crankAngle, (configPage4.triggerTeeth + toothCurrentCount)); 
        }
        else{ crankAngle = ignitionLimits(crankAngle); checkPerToothTiming(crankAngle, toothCurrentCount); }
      }
   }
}

void triggerSec_missingTooth(void)
{
  curTime2 = micros();
  curGap2 = curTime2 - toothLastSecToothTime;

  //Safety check for initial startup
  if( (toothLastSecToothTime == 0) )
  { 
    curGap2 = 0; 
    toothLastSecToothTime = curTime2;
  }

  if ( curGap2 >= triggerSecFilterTime )
  {
    switch (configPage4.trigPatternSec)
    {
      case SEC_TRIGGER_4_1:
        targetGap2 = (3 * (toothLastSecToothTime - toothLastMinusOneSecToothTime)) >> 1; //If the time between the current tooth and the last is greater than 1.5x the time between the last tooth and the tooth before that, we make the assertion that we must be at the first tooth after the gap
        toothLastMinusOneSecToothTime = toothLastSecToothTime;
        if ( (curGap2 >= targetGap2) || (secondaryToothCount > 3) )
        {
          secondaryToothCount = 1;
          revolutionOne = 1; //Sequential revolution reset
          triggerSecFilterTime = 0; //This is used to prevent a condition where serious intermittent signals (Eg someone furiously plugging the sensor wire in and out) can leave the filter in an unrecoverable state
          triggerRecordVVT1Angle();
        }
        else
        {
          triggerSecFilterTime = curGap2 >> 2; //Set filter at 25% of the current speed. Filter can only be recalc'd for the regular teeth, not the missing one.
          secondaryToothCount++;
        }
        break;

      case SEC_TRIGGER_POLL:
        //Poll is effectively the same as SEC_TRIGGER_SINGLE, however we do not reset revolutionOne
        //We do still need to record the angle for VVT though
        triggerSecFilterTime = curGap2 >> 1; //Next secondary filter is half the current gap
        triggerRecordVVT1Angle();
        break;

      case SEC_TRIGGER_SINGLE:
        //Standard single tooth cam trigger
        revolutionOne = 1; //Sequential revolution reset
        triggerSecFilterTime = curGap2 >> 1; //Next secondary filter is half the current gap
        secondaryToothCount++;
        triggerRecordVVT1Angle();
        break;

      case SEC_TRIGGER_TOYOTA_3:
        // designed for Toyota VVTI (2JZ) engine - 3 triggers on the cam. 
        // the 2 teeth for this are within 1 rotation (1 tooth first 360, 2 teeth second 360)
        secondaryToothCount++;
        if(secondaryToothCount == 2)
        { 
          revolutionOne = 1; // sequential revolution reset
          triggerRecordVVT1Angle();         
        }        
        //Next secondary filter is 25% the current gap, done here so we don't get a great big gap for the 1st tooth
        triggerSecFilterTime = curGap2 >> 2; 
        break;
    }
    toothLastSecToothTime = curTime2;
  } //Trigger filter
}

static inline void triggerRecordVVT1Angle (void)
{
  //Record the VVT Angle
  if( (configPage6.vvtEnabled > 0) && (revolutionOne == 1) )
  {
    int16_t curAngle;
    curAngle = getCrankAngle();
    while(curAngle > 360) { curAngle -= 360; }
    curAngle -= configPage4.triggerAngle; //Value at TDC
    if( configPage6.vvtMode == VVT_MODE_CLOSED_LOOP ) { curAngle -= configPage10.vvtCL0DutyAng; }

    currentStatus.vvt1Angle = LOW_PASS_FILTER( (curAngle << 1), configPage4.ANGLEFILTER_VVT, currentStatus.vvt1Angle);
  }
}


void triggerThird_missingTooth(void)
{
//Record the VVT2 Angle (the only purpose of the third trigger)
//NB no filtering of this signal with current implementation unlike Cam (VVT1)

  int16_t curAngle;
  curTime3 = micros();
  curGap3 = curTime3 - toothLastThirdToothTime;

  //Safety check for initial startup
  if( (toothLastThirdToothTime == 0) )
  { 
    curGap3 = 0; 
    toothLastThirdToothTime = curTime3;
  }

  if ( curGap3 >= triggerThirdFilterTime )
  {
    thirdToothCount++;
    triggerThirdFilterTime = curGap3 >> 2; //Next third filter is 25% the current gap
    
    curAngle = getCrankAngle();
    while(curAngle > 360) { curAngle -= 360; }
    curAngle -= configPage4.triggerAngle; //Value at TDC
    if( configPage6.vvtMode == VVT_MODE_CLOSED_LOOP ) { curAngle -= configPage4.vvt2CL0DutyAng; }
    //currentStatus.vvt2Angle = int8_t (curAngle); //vvt1Angle is only int8, but +/-127 degrees is enough for VVT control
    currentStatus.vvt2Angle = LOW_PASS_FILTER( (curAngle << 1), configPage4.ANGLEFILTER_VVT, currentStatus.vvt2Angle);    

    toothLastThirdToothTime = curTime3;
  } //Trigger filter
}

uint16_t getRPM_missingTooth(void)
{
  uint16_t tempRPM = 0;
  if( currentStatus.RPM < currentStatus.crankRPM )
  {
    if(toothCurrentCount != 1)
    {
      tempRPM = crankingGetRPM(configPage4.triggerTeeth, configPage4.TrigSpeed==CAM_SPEED); //Account for cam speed
    }
    else { tempRPM = currentStatus.RPM; } //Can't do per tooth RPM if we're at tooth #1 as the missing tooth messes the calculation
  }
  else
  {
    tempRPM = stdGetRPM(configPage4.TrigSpeed==CAM_SPEED); //Account for cam speed
  }
  return tempRPM;
}

int getCrankAngle_missingTooth(void)
{
    //This is the current angle ATDC the engine is at. This is the last known position based on what tooth was last 'seen'. It is only accurate to the resolution of the trigger wheel (Eg 36-1 is 10 degrees)
    unsigned long tempToothLastToothTime;
    int tempToothCurrentCount;
    bool tempRevolutionOne;
    //Grab some variables that are used in the trigger code and assign them to temp variables.
    noInterrupts();
    tempToothCurrentCount = toothCurrentCount;
    tempRevolutionOne = revolutionOne;
    tempToothLastToothTime = toothLastToothTime;
    interrupts();

    int crankAngle = ((tempToothCurrentCount - 1) * triggerToothAngle) + configPage4.triggerAngle; //Number of teeth that have passed since tooth 1, multiplied by the angle each tooth represents, plus the angle that tooth 1 is ATDC. This gives accuracy only to the nearest tooth.
    
    //Sequential check (simply sets whether we're on the first or 2nd revolution of the cycle)
    if ( (tempRevolutionOne == true) && (configPage4.TrigSpeed == CRANK_SPEED) ) { crankAngle += 360; }

    lastCrankAngleCalc = micros();
    elapsedTime = (lastCrankAngleCalc - tempToothLastToothTime);
    crankAngle += timeToAngleDegPerMicroSec(elapsedTime);

    if (crankAngle >= 720) { crankAngle -= 720; }
    if (crankAngle < 0) { crankAngle += CRANK_ANGLE_MAX; }

    return crankAngle;
}

static inline uint16_t clampToToothCount(int16_t toothNum, uint8_t toothAdder) {
  int16_t toothRange = (int16_t)configPage4.triggerTeeth + (int16_t)toothAdder;
  return (uint16_t)nudge(1, toothRange, toothNum, toothRange);
}

static inline uint16_t clampToActualTeeth(uint16_t toothNum, uint8_t toothAdder) {
  if(toothNum > triggerActualTeeth && toothNum <= configPage4.triggerTeeth) { toothNum = triggerActualTeeth; }
  return min(toothNum, (uint16_t)(triggerActualTeeth + toothAdder));
}

static uint16_t __attribute__((noinline)) calcEndTeeth_missingTooth(int endAngle, uint8_t toothAdder) {
  //Temp variable used here to avoid potential issues if a trigger interrupt occurs part way through this function
  int16_t tempEndTooth;
#ifdef USE_LIBDIVIDE  
  tempEndTooth = libdivide::libdivide_s16_do(endAngle - configPage4.triggerAngle, &divTriggerToothAngle);
#else
  tempEndTooth = (endAngle - (int16_t)configPage4.triggerAngle) / (int16_t)triggerToothAngle;
#endif
  //For higher tooth count triggers, add a 1 tooth margin to allow for calculation time. 
  if(configPage4.triggerTeeth > 12U) { tempEndTooth = tempEndTooth - 1; }
  
  // Clamp to tooth count
  return clampToActualTeeth(clampToToothCount(tempEndTooth, toothAdder), toothAdder);
}

void triggerSetEndTeeth_missingTooth(void)
{
  uint8_t toothAdder = 0;
  if( ((configPage4.sparkMode == IGN_MODE_SEQUENTIAL) || (configPage4.sparkMode == IGN_MODE_SINGLE)) && (configPage4.TrigSpeed == CRANK_SPEED) && (configPage2.strokes == FOUR_STROKE) ) { toothAdder = configPage4.triggerTeeth; }

  ignition1EndTooth = calcEndTeeth_missingTooth(ignition1EndAngle, toothAdder);
  ignition2EndTooth = calcEndTeeth_missingTooth(ignition2EndAngle, toothAdder);
  ignition3EndTooth = calcEndTeeth_missingTooth(ignition3EndAngle, toothAdder);
  ignition4EndTooth = calcEndTeeth_missingTooth(ignition4EndAngle, toothAdder);
#if IGN_CHANNELS >= 5
  ignition5EndTooth = calcEndTeeth_missingTooth(ignition5EndAngle, toothAdder);
#endif
#if IGN_CHANNELS >= 6
  ignition6EndTooth = calcEndTeeth_missingTooth(ignition6EndAngle, toothAdder);
#endif
#if IGN_CHANNELS >= 7
  ignition7EndTooth = calcEndTeeth_missingTooth(ignition7EndAngle, toothAdder);
#endif
#if IGN_CHANNELS >= 8
  ignition8EndTooth = calcEndTeeth_missingTooth(ignition8EndAngle, toothAdder);
#endif
}
/** @} */

/** Dual wheels - 2 wheels located either both on the crank or with the primary on the crank and the secondary on the cam.
Note: There can be no missing teeth on the primary wheel.
* @defgroup dec_dual Dual wheels
* @{
*/
/** Dual Wheel Setup.
 * 
 * */
void triggerSetup_DualWheel(void)
{
  triggerToothAngle = 360 / configPage4.triggerTeeth; //The number of degrees that passes from tooth to tooth
  if(configPage4.TrigSpeed == CAM_SPEED) { triggerToothAngle = 720 / configPage4.triggerTeeth; } //Account for cam speed
  toothCurrentCount = UINT8_MAX; //Default value
  triggerFilterTime = (MICROS_PER_SEC / (MAX_RPM / 60U * configPage4.triggerTeeth)); //Trigger filter time is the shortest possible time (in uS) that there can be between crank teeth (ie at max RPM). Any pulses that occur faster than this time will be discarded as noise
  triggerSecFilterTime = (MICROS_PER_SEC / (MAX_RPM / 60U * 2U)) / 2U; //Same as above, but fixed at 2 teeth on the secondary input and divided by 2 (for cam speed)
  BIT_CLEAR(decoderState, BIT_DECODER_2ND_DERIV);
  BIT_SET(decoderState, BIT_DECODER_IS_SEQUENTIAL);
  BIT_SET(decoderState, BIT_DECODER_TOOTH_ANG_CORRECT); //This is always true for this pattern
  BIT_SET(decoderState, BIT_DECODER_HAS_SECONDARY);
  MAX_STALL_TIME = ((MICROS_PER_DEG_1_RPM/50U) * triggerToothAngle); //Minimum 50rpm. (3333uS is the time per degree at 50rpm)
#ifdef USE_LIBDIVIDE
  divTriggerToothAngle = libdivide::libdivide_s16_gen(triggerToothAngle);
#endif
}

/** Dual Wheel Primary.
 * 
 * */
void triggerPri_DualWheel(void)
{
    curTime = micros();
    curGap = curTime - toothLastToothTime;
    if ( curGap >= triggerFilterTime )
    {
      toothCurrentCount++; //Increment the tooth counter
      BIT_SET(decoderState, BIT_DECODER_VALID_TRIGGER); //Flag this pulse as being a valid trigger (ie that it passed filters)

      toothLastMinusOneToothTime = toothLastToothTime;
      toothLastToothTime = curTime;

      if ( currentStatus.hasSync == true )
      {
        if ( (toothCurrentCount == 1) || (toothCurrentCount > configPage4.triggerTeeth) )
        {
          toothCurrentCount = 1;
          revolutionOne = !revolutionOne; //Flip sequential revolution tracker
          toothOneMinusOneTime = toothOneTime;
          toothOneTime = curTime;
          currentStatus.startRevolutions++; //Counter
          if ( configPage4.TrigSpeed == CAM_SPEED ) { currentStatus.startRevolutions++; } //Add an extra revolution count if we're running at cam speed
        }

        setFilter(curGap); //Recalc the new filter value
      }

      //NEW IGNITION MODE
      if( (configPage2.perToothIgn == true) && (!BIT_CHECK(currentStatus.engine, BIT_ENGINE_CRANK)) ) 
      {
        int16_t crankAngle = ( (toothCurrentCount-1) * triggerToothAngle ) + configPage4.triggerAngle;
        uint16_t currentTooth;
        if( (configPage4.sparkMode == IGN_MODE_SEQUENTIAL) && (revolutionOne == true) && (configPage4.TrigSpeed == CRANK_SPEED) )
        {
          crankAngle += 360;
          currentTooth = (configPage4.triggerTeeth + toothCurrentCount); 
        }
        else{ currentTooth = toothCurrentCount; }
        checkPerToothTiming(crankAngle, currentTooth);
      }
   } //Trigger filter
}
/** Dual Wheel Secondary.
 * 
 * */
void triggerSec_DualWheel(void)
{
  curTime2 = micros();
  curGap2 = curTime2 - toothLastSecToothTime;
  if ( curGap2 >= triggerSecFilterTime )
  {
    toothLastSecToothTime = curTime2;
    triggerSecFilterTime = curGap2 >> 2; //Set filter at 25% of the current speed

    if( (currentStatus.hasSync == false) || (currentStatus.startRevolutions <= configPage4.StgCycles) )
    {
      toothLastToothTime = micros();
      toothLastMinusOneToothTime = micros() - ((MICROS_PER_MIN/10U) / configPage4.triggerTeeth); //Fixes RPM at 10rpm until a full revolution has taken place
      toothCurrentCount = configPage4.triggerTeeth;
      triggerFilterTime = 0; //Need to turn the filter off here otherwise the first primary tooth after achieving sync is ignored

      currentStatus.hasSync = true;
    }
    else 
    {
      if ( (toothCurrentCount != configPage4.triggerTeeth) && (currentStatus.startRevolutions > 2)) { currentStatus.syncLossCounter++; } //Indicates likely sync loss.
      if (configPage4.useResync == 1) { toothCurrentCount = configPage4.triggerTeeth; }
    }

    revolutionOne = 1; //Sequential revolution reset
  }
  else 
  {
    triggerSecFilterTime = revolutionTime >> 1; //Set filter at 25% of the current cam speed. This needs to be performed here to prevent a situation where the RPM and triggerSecFilterTime get out of alignment and curGap2 never exceeds the filter value
  } //Trigger filter
}
/** Dual Wheel - Get RPM.
 * 
 * */
uint16_t getRPM_DualWheel(void)
{
  if( currentStatus.hasSync == true )
  {
    //Account for cam speed
    if( currentStatus.RPM < currentStatus.crankRPM )
    {
      return crankingGetRPM(configPage4.triggerTeeth, configPage4.TrigSpeed==CAM_SPEED);
    }
    else
    {
      return stdGetRPM(configPage4.TrigSpeed==CAM_SPEED);
    }
  }
  return 0U;
}

/** Dual Wheel - Get Crank angle.
 * 
 * */
int getCrankAngle_DualWheel(void)
{
    //This is the current angle ATDC the engine is at. This is the last known position based on what tooth was last 'seen'. It is only accurate to the resolution of the trigger wheel (Eg 36-1 is 10 degrees)
    unsigned long tempToothLastToothTime;
    int tempToothCurrentCount;
    bool tempRevolutionOne;
    //Grab some variables that are used in the trigger code and assign them to temp variables.
    noInterrupts();
    tempToothCurrentCount = toothCurrentCount;
    tempToothLastToothTime = toothLastToothTime;
    tempRevolutionOne = revolutionOne;
    lastCrankAngleCalc = micros();
    interrupts();

    //Handle case where the secondary tooth was the last one seen
    if(tempToothCurrentCount == 0) { tempToothCurrentCount = configPage4.triggerTeeth; }

    int crankAngle = ((tempToothCurrentCount - 1) * triggerToothAngle) + configPage4.triggerAngle; //Number of teeth that have passed since tooth 1, multiplied by the angle each tooth represents, plus the angle that tooth 1 is ATDC. This gives accuracy only to the nearest tooth.

    elapsedTime = (lastCrankAngleCalc - tempToothLastToothTime);
    crankAngle += timeToAngleDegPerMicroSec(elapsedTime);

    //Sequential check (simply sets whether we're on the first or 2nd revolution of the cycle)
    if ( (tempRevolutionOne == true) && (configPage4.TrigSpeed == CRANK_SPEED) ) { crankAngle += 360; }

    if (crankAngle >= 720) { crankAngle -= 720; }
    if (crankAngle < 0) { crankAngle += CRANK_ANGLE_MAX; }

    return crankAngle;
}

static uint16_t __attribute__((noinline)) calcEndTeeth_DualWheel(int ignitionAngle, uint8_t toothAdder) {
  int16_t tempEndTooth =
#ifdef USE_LIBDIVIDE
      libdivide::libdivide_s16_do(ignitionAngle - configPage4.triggerAngle, &divTriggerToothAngle);
#else
      (ignitionAngle - (int16_t)configPage4.triggerAngle) / (int16_t)triggerToothAngle;
#endif
  return clampToToothCount(tempEndTooth, toothAdder);
}

/** Dual Wheel - Set End Teeth.
 * 
 * */
void triggerSetEndTeeth_DualWheel(void)
{
  //The toothAdder variable is used for when a setup is running sequentially, but the primary wheel is running at crank speed. This way the count of teeth will go up to 2* the number of primary teeth to allow for a sequential count. 
  byte toothAdder = 0;
  if( (configPage4.sparkMode == IGN_MODE_SEQUENTIAL) && (configPage4.TrigSpeed == CRANK_SPEED) ) { toothAdder = configPage4.triggerTeeth; }

  ignition1EndTooth = calcEndTeeth_DualWheel(ignition1EndAngle, toothAdder);
  ignition2EndTooth = calcEndTeeth_DualWheel(ignition2EndAngle, toothAdder);
  ignition3EndTooth = calcEndTeeth_DualWheel(ignition3EndAngle, toothAdder);
  ignition4EndTooth = calcEndTeeth_DualWheel(ignition4EndAngle, toothAdder);
#if IGN_CHANNELS >= 5
  ignition5EndTooth = calcEndTeeth_DualWheel(ignition5EndAngle, toothAdder);
#endif
#if IGN_CHANNELS >= 6
  ignition6EndTooth = calcEndTeeth_DualWheel(ignition6EndAngle, toothAdder);
#endif
#if IGN_CHANNELS >= 7
  ignition7EndTooth = calcEndTeeth_DualWheel(ignition7EndAngle, toothAdder);
#endif
#if IGN_CHANNELS >= 8
  ignition8EndTooth = calcEndTeeth_DualWheel(ignition8EndAngle, toothAdder);
#endif
}
/** @} */

/** Basic Distributor where tooth count is equal to the number of cylinders and teeth are evenly spaced on the cam.
* No position sensing (Distributor is retained) so crank angle is
* a made up figure based purely on the first teeth to be seen.
* Note: This is a very simple decoder. See http://www.megamanual.com/ms2/GM_7pinHEI.htm
* @defgroup dec_dist Basic Distributor
* @{
*/
void triggerSetup_BasicDistributor(void)
{
  triggerActualTeeth = configPage2.nCylinders;
  if(triggerActualTeeth == 0) { triggerActualTeeth = 1; }

  //The number of degrees that passes from tooth to tooth. Depends on number of cylinders and whether 4 or 2 stroke
  if(configPage2.strokes == FOUR_STROKE) { triggerToothAngle = 720U / triggerActualTeeth; }
  else { triggerToothAngle = 360U / triggerActualTeeth; }

  triggerFilterTime = MICROS_PER_MIN / MAX_RPM / configPage2.nCylinders; // Minimum time required between teeth
  triggerFilterTime = triggerFilterTime / 2; //Safety margin
  triggerFilterTime = 0;
  BIT_CLEAR(decoderState, BIT_DECODER_2ND_DERIV);
  BIT_CLEAR(decoderState, BIT_DECODER_IS_SEQUENTIAL);
  BIT_CLEAR(decoderState, BIT_DECODER_HAS_SECONDARY);
  toothCurrentCount = 0; //Default value
  BIT_SET(decoderState, BIT_DECODER_HAS_FIXED_CRANKING);
  BIT_SET(decoderState, BIT_DECODER_TOOTH_ANG_CORRECT);
  if(configPage2.nCylinders <= 4U) { MAX_STALL_TIME = ((MICROS_PER_DEG_1_RPM/90U) * triggerToothAngle); }//Minimum 90rpm. (1851uS is the time per degree at 90rpm). This uses 90rpm rather than 50rpm due to the potentially very high stall time on a 4 cylinder if we wait that long.
  else { MAX_STALL_TIME = ((MICROS_PER_DEG_1_RPM/50U) * triggerToothAngle); } //Minimum 50rpm. (3200uS is the time per degree at 50rpm).

}

void triggerPri_BasicDistributor(void)
{
  curTime = micros();
  curGap = curTime - toothLastToothTime;
  if ( (curGap >= triggerFilterTime) )
  {
    if(currentStatus.hasSync == true) { setFilter(curGap); } //Recalc the new filter value
    else { triggerFilterTime = 0; } //If we don't yet have sync, ensure that the filter won't prevent future valid pulses from being ignored. 
    
    if( (toothCurrentCount == triggerActualTeeth) || (currentStatus.hasSync == false) ) //Check if we're back to the beginning of a revolution
    {
      toothCurrentCount = 1; //Reset the counter
      toothOneMinusOneTime = toothOneTime;
      toothOneTime = curTime;
      currentStatus.hasSync = true;
      currentStatus.startRevolutions++; //Counter
    }
    else
    {
      if( (toothCurrentCount < triggerActualTeeth) ) { toothCurrentCount++; } //Increment the tooth counter
      else
      {
        //This means toothCurrentCount is greater than triggerActualTeeth, which is bad.
        //If we have sync here then there's a problem. Throw a sync loss
        if( currentStatus.hasSync == true ) 
        { 
          currentStatus.syncLossCounter++;
          currentStatus.hasSync = false;
        }
      }
      
    }

    BIT_SET(decoderState, BIT_DECODER_VALID_TRIGGER); //Flag this pulse as being a valid trigger (ie that it passed filters)

    if ( configPage4.ignCranklock && BIT_CHECK(currentStatus.engine, BIT_ENGINE_CRANK) )
    {
      endCoil1Charge();
      endCoil2Charge();
      endCoil3Charge();
      endCoil4Charge();
    }

    if(configPage2.perToothIgn == true)
    {
      int16_t crankAngle = ( (toothCurrentCount-1) * triggerToothAngle ) + configPage4.triggerAngle;
      crankAngle = ignitionLimits((crankAngle));
      uint16_t currentTooth = toothCurrentCount;
      if(toothCurrentCount > (triggerActualTeeth/2) ) { currentTooth = (toothCurrentCount - (triggerActualTeeth/2)); }
      checkPerToothTiming(crankAngle, currentTooth);
    }

    toothLastMinusOneToothTime = toothLastToothTime;
    toothLastToothTime = curTime;
  } //Trigger filter
}
void triggerSec_BasicDistributor(void) { return; } //Not required
uint16_t getRPM_BasicDistributor(void)
{
  uint16_t tempRPM;
  uint8_t distributorSpeed = CAM_SPEED; //Default to cam speed
  if(configPage2.strokes == TWO_STROKE) { distributorSpeed = CRANK_SPEED; } //For 2 stroke distributors, the tooth rate is based on crank speed, not 'cam'

  if( currentStatus.RPM < currentStatus.crankRPM || currentStatus.RPM < 1500)
  { 
    tempRPM = crankingGetRPM(triggerActualTeeth, distributorSpeed);
  } 
  else { tempRPM = stdGetRPM(distributorSpeed); }

  MAX_STALL_TIME = revolutionTime << 1; //Set the stall time to be twice the current RPM. This is a safe figure as there should be no single revolution where this changes more than this
  if(triggerActualTeeth == 1) { MAX_STALL_TIME = revolutionTime << 1; } //Special case for 1 cylinder engines that only get 1 pulse every 720 degrees
  if(MAX_STALL_TIME < 366667UL) { MAX_STALL_TIME = 366667UL; } //Check for 50rpm minimum

  return tempRPM;

}
int getCrankAngle_BasicDistributor(void)
{
    //This is the current angle ATDC the engine is at. This is the last known position based on what tooth was last 'seen'. It is only accurate to the resolution of the trigger wheel (Eg 36-1 is 10 degrees)
    unsigned long tempToothLastToothTime;
    int tempToothCurrentCount;
    //Grab some variables that are used in the trigger code and assign them to temp variables.
    noInterrupts();
    tempToothCurrentCount = toothCurrentCount;
    tempToothLastToothTime = toothLastToothTime;
    lastCrankAngleCalc = micros(); //micros() is no longer interrupt safe
    interrupts();

    int crankAngle = ((tempToothCurrentCount - 1) * triggerToothAngle) + configPage4.triggerAngle; //Number of teeth that have passed since tooth 1, multiplied by the angle each tooth represents, plus the angle that tooth 1 is ATDC. This gives accuracy only to the nearest tooth.
    
    //Estimate the number of degrees travelled since the last tooth}
    elapsedTime = (lastCrankAngleCalc - tempToothLastToothTime);

    //crankAngle += timeToAngleDegPerMicroSec(elapsedTime);
    crankAngle += timeToAngleIntervalTooth(elapsedTime);
    

    if (crankAngle >= 720) { crankAngle -= 720; }
    if (crankAngle < 0) { crankAngle += CRANK_ANGLE_MAX; }

    return crankAngle;
}

void triggerSetEndTeeth_BasicDistributor(void)
{

  int tempEndAngle = (ignition1EndAngle - configPage4.triggerAngle);
  tempEndAngle = ignitionLimits((tempEndAngle));

  switch(configPage2.nCylinders)
  {
    case 4:
      if( (tempEndAngle > 180) || (tempEndAngle <= 0) )
      {
        ignition1EndTooth = 2;
        ignition2EndTooth = 1;
      }
      else
      {
        ignition1EndTooth = 1;
        ignition2EndTooth = 2;
      }
      break;
    case 3: //Shared with 6 cylinder
    case 6:
      if( (tempEndAngle > 120) && (tempEndAngle <= 240) )
      {
        ignition1EndTooth = 2;
        ignition2EndTooth = 3;
        ignition3EndTooth = 1;
      }
      else if( (tempEndAngle > 240) || (tempEndAngle <= 0) )
      {
        ignition1EndTooth = 3;
        ignition2EndTooth = 1;
        ignition3EndTooth = 2;
      }
      else
      {
        ignition1EndTooth = 1;
        ignition2EndTooth = 2;
        ignition3EndTooth = 3;
      }
      break;
    case 8:
      if( (tempEndAngle > 90) && (tempEndAngle <= 180) )
      {
        ignition1EndTooth = 2;
        ignition2EndTooth = 3;
        ignition3EndTooth = 4;
        ignition4EndTooth = 1;
      }
      else if( (tempEndAngle > 180) && (tempEndAngle <= 270) )
      {
        ignition1EndTooth = 3;
        ignition2EndTooth = 4;
        ignition3EndTooth = 1;
        ignition4EndTooth = 2;
      }
      else if( (tempEndAngle > 270) || (tempEndAngle <= 0) )
      {
        ignition1EndTooth = 4;
        ignition2EndTooth = 1;
        ignition3EndTooth = 2;
        ignition4EndTooth = 3;
      }
      else
      {
        ignition1EndTooth = 1;
        ignition2EndTooth = 2;
        ignition3EndTooth = 3;
        ignition4EndTooth = 4;
      }
      break;
  }
}
/** @} */

/** Decode GM 7X trigger wheel with six equally spaced teeth and a seventh tooth for cylinder identification.
* Note: Within the decoder code pf GM7X, the sync tooth is referred to as tooth #3 rather than tooth #7. This makes for simpler angle calculations
* (See: http://www.speeduino.com/forum/download/file.php?id=4743 ).
* @defgroup dec_gm7x GM7X
* @{
*/
void triggerSetup_GM7X(void)
{
  triggerToothAngle = 360 / 6; //The number of degrees that passes from tooth to tooth
  BIT_CLEAR(decoderState, BIT_DECODER_2ND_DERIV);
  BIT_CLEAR(decoderState, BIT_DECODER_IS_SEQUENTIAL);
  BIT_CLEAR(decoderState, BIT_DECODER_HAS_SECONDARY);
  MAX_STALL_TIME = ((MICROS_PER_DEG_1_RPM/50U) * triggerToothAngle); //Minimum 50rpm. (3333uS is the time per degree at 50rpm)
}

void triggerPri_GM7X(void)
{
    lastGap = curGap;
    curTime = micros();
    curGap = curTime - toothLastToothTime;
    toothCurrentCount++; //Increment the tooth counter
    BIT_SET(decoderState, BIT_DECODER_VALID_TRIGGER); //Flag this pulse as being a valid trigger (ie that it passed filters)

    if( (toothLastToothTime > 0) && (toothLastMinusOneToothTime > 0) )
    {
      if( toothCurrentCount > 7 )
      {
        toothCurrentCount = 1;
        toothOneMinusOneTime = toothOneTime;
        toothOneTime = curTime;

        BIT_SET(decoderState, BIT_DECODER_TOOTH_ANG_CORRECT);
      }
      else
      {
        targetGap = (lastGap) >> 1; //The target gap is set at half the last tooth gap
        if ( curGap < targetGap ) //If the gap between this tooth and the last one is less than half of the previous gap, then we are very likely at the magical 3rd tooth
        {
          toothCurrentCount = 3;
          currentStatus.hasSync = true;
          BIT_CLEAR(decoderState, BIT_DECODER_TOOTH_ANG_CORRECT); //The tooth angle is double at this point
          currentStatus.startRevolutions++; //Counter
        }
        else
        {
          BIT_SET(decoderState, BIT_DECODER_TOOTH_ANG_CORRECT);
        }
      }
    }

    //New ignition mode!
    if(configPage2.perToothIgn == true)
    {
      if(toothCurrentCount != 3) //Never do the check on the extra tooth. It's not needed anyway
      {
        //configPage4.triggerAngle must currently be below 48 and above -81
        int16_t crankAngle;
        if( toothCurrentCount < 3 )
        {
          crankAngle = ((toothCurrentCount - 1) * triggerToothAngle) + 42 + configPage4.triggerAngle; //Number of teeth that have passed since tooth 1, multiplied by the angle each tooth represents, plus the angle that tooth 1 is ATDC. This gives accuracy only to the nearest tooth.
        }
        else
        {
          crankAngle = ((toothCurrentCount - 2) * triggerToothAngle) + 42 + configPage4.triggerAngle; //Number of teeth that have passed since tooth 1, multiplied by the angle each tooth represents, plus the angle that tooth 1 is ATDC. This gives accuracy only to the nearest tooth.
        }
        checkPerToothTiming(crankAngle, toothCurrentCount);
      } 
    }

    toothLastMinusOneToothTime = toothLastToothTime;
    toothLastToothTime = curTime;


}
void triggerSec_GM7X(void) { return; } //Not required
uint16_t getRPM_GM7X(void)
{
   return stdGetRPM(CRANK_SPEED);
}
int getCrankAngle_GM7X(void)
{
    //This is the current angle ATDC the engine is at. This is the last known position based on what tooth was last 'seen'. It is only accurate to the resolution of the trigger wheel (Eg 36-1 is 10 degrees)
    unsigned long tempToothLastToothTime;
    int tempToothCurrentCount;
    //Grab some variables that are used in the trigger code and assign them to temp variables.
    noInterrupts();
    tempToothCurrentCount = toothCurrentCount;
    tempToothLastToothTime = toothLastToothTime;
    lastCrankAngleCalc = micros(); //micros() is no longer interrupt safe
    interrupts();

    //Check if the last tooth seen was the reference tooth (Number 3). All others can be calculated, but tooth 3 has a unique angle
    int crankAngle;
    if( tempToothCurrentCount < 3 )
    {
      crankAngle = ((tempToothCurrentCount - 1) * triggerToothAngle) + 42 + configPage4.triggerAngle; //Number of teeth that have passed since tooth 1, multiplied by the angle each tooth represents, plus the angle that tooth 1 is ATDC. This gives accuracy only to the nearest tooth.
    }
    else if( tempToothCurrentCount == 3 )
    {
      crankAngle = 112;
    }
    else
    {
      crankAngle = ((tempToothCurrentCount - 2) * triggerToothAngle) + 42 + configPage4.triggerAngle; //Number of teeth that have passed since tooth 1, multiplied by the angle each tooth represents, plus the angle that tooth 1 is ATDC. This gives accuracy only to the nearest tooth.
    }

    //Estimate the number of degrees travelled since the last tooth}
    elapsedTime = (lastCrankAngleCalc - tempToothLastToothTime);
    crankAngle += timeToAngleDegPerMicroSec(elapsedTime);

    if (crankAngle >= 720) { crankAngle -= 720; }
    if (crankAngle < 0) { crankAngle += 360; }

    return crankAngle;
}

void triggerSetEndTeeth_GM7X(void)
{
  if(currentStatus.advance < 18 ) 
  { 
    ignition1EndTooth = 7;
    ignition2EndTooth = 2;
    ignition3EndTooth = 5;
  }
  else 
  { 
    ignition1EndTooth = 6;
    ignition2EndTooth = 1;
    ignition3EndTooth = 4;
  }
}
/** @} */

/** Mitsubishi 4G63 / NA/NB Miata + MX-5 / 4/2.
Note: raw.githubusercontent.com/noisymime/speeduino/master/reference/wiki/decoders/4g63_trace.png
Tooth #1 is defined as the next crank tooth after the crank signal is HIGH when the cam signal is falling.
Tooth number one is at 355* ATDC.
* @defgroup dec_mitsu_miata Mistsubishi 4G63 and Miata + MX-5
* @{
*/
void triggerSetup_4G63(void)
{
  triggerToothAngle = 180; //The number of degrees that passes from tooth to tooth (primary)
  toothCurrentCount = 99; //Fake tooth count represents no sync
  BIT_CLEAR(decoderState, BIT_DECODER_2ND_DERIV);
  BIT_SET(decoderState, BIT_DECODER_IS_SEQUENTIAL);
  BIT_SET(decoderState, BIT_DECODER_HAS_FIXED_CRANKING);
  BIT_SET(decoderState, BIT_DECODER_TOOTH_ANG_CORRECT);
  BIT_SET(decoderState, BIT_DECODER_HAS_SECONDARY);
  MAX_STALL_TIME = 366667UL; //Minimum 50rpm based on the 110 degree tooth spacing
  if(currentStatus.initialisationComplete == false) { toothLastToothTime = micros(); } //Set a startup value here to avoid filter errors when starting. This MUST have the initial check to prevent the fuel pump just staying on all the time

  //Note that these angles are for every rising and falling edge
  if(configPage2.nCylinders == 6)
  {
    //New values below
    toothAngles[0] = 715; //Rising edge of tooth #1
    toothAngles[1] = 45;  //Falling edge of tooth #1
    toothAngles[2] = 115; //Rising edge of tooth #2
    toothAngles[3] = 165; //Falling edge of tooth #2
    toothAngles[4] = 235; //Rising edge of tooth #3
    toothAngles[5] = 285; //Falling edge of tooth #3

    toothAngles[6] = 355; //Rising edge of tooth #4
    toothAngles[7] = 405; //Falling edge of tooth #4
    toothAngles[8] = 475; //Rising edge of tooth #5
    toothAngles[9] = 525; //Falling edge of tooth $5
    toothAngles[10] = 595; //Rising edge of tooth #6
    toothAngles[11] = 645; //Falling edge of tooth #6

    triggerActualTeeth = 12; //Both sides of all teeth over 720 degrees
  }
  else
  {
    // 70 / 110 for 4 cylinder
    toothAngles[0] = 715; //Falling edge of tooth #1
    toothAngles[1] = 105; //Rising edge of tooth #2
    toothAngles[2] = 175; //Falling edge of tooth #2
    toothAngles[3] = 285; //Rising edge of tooth #1

    toothAngles[4] = 355; //Falling edge of tooth #1
    toothAngles[5] = 465; //Rising edge of tooth #2
    toothAngles[6] = 535; //Falling edge of tooth #2
    toothAngles[7] = 645; //Rising edge of tooth #1

    triggerActualTeeth = 8;
  }

  triggerFilterTime = 1500; //10000 rpm, assuming we're triggering on both edges off the crank tooth.
  triggerSecFilterTime = (int)(MICROS_PER_SEC / (MAX_RPM / 60U * 2U)) / 2U; //Same as above, but fixed at 2 teeth on the secondary input and divided by 2 (for cam speed)
  triggerSecFilterTime_duration = 4000;
  secondaryLastToothTime = 0;
}

void triggerPri_4G63(void)
{
  curTime = micros();
  curGap = curTime - toothLastToothTime;
  if ( (curGap >= triggerFilterTime) || (currentStatus.startRevolutions == 0) )
  {
    BIT_SET(decoderState, BIT_DECODER_VALID_TRIGGER); //Flag this pulse as being a valid trigger (ie that it passed filters)
    triggerFilterTime = curGap >> 2; //This only applies during non-sync conditions. If there is sync then triggerFilterTime gets changed again below with a better value.

    toothLastMinusOneToothTime = toothLastToothTime;
    toothLastToothTime = curTime;

    toothCurrentCount++;

    if( (toothCurrentCount == 1) || (toothCurrentCount > triggerActualTeeth) ) //Trigger is on CHANGE, hence 4 pulses = 1 crank rev (or 6 pulses for 6 cylinders)
    {
       toothCurrentCount = 1; //Reset the counter
       toothOneMinusOneTime = toothOneTime;
       toothOneTime = curTime;
       currentStatus.startRevolutions++; //Counter
    }

    if (currentStatus.hasSync == true)
    {
      if ( BIT_CHECK(currentStatus.engine, BIT_ENGINE_CRANK) && configPage4.ignCranklock && (currentStatus.startRevolutions >= configPage4.StgCycles))
      {
        if(configPage2.nCylinders == 4)
        {
          //This operates in forced wasted spark mode during cranking to align with crank teeth
          if( (toothCurrentCount == 1) || (toothCurrentCount == 5) ) { endCoil1Charge(); endCoil3Charge(); }
          else if( (toothCurrentCount == 3) || (toothCurrentCount == 7) ) { endCoil2Charge(); endCoil4Charge(); }
        }
        else if(configPage2.nCylinders == 6)
        {
          if( (toothCurrentCount == 1) || (toothCurrentCount == 7) ) { endCoil1Charge(); }
          else if( (toothCurrentCount == 3) || (toothCurrentCount == 9) ) { endCoil2Charge(); }
          else if( (toothCurrentCount == 5) || (toothCurrentCount == 11) ) { endCoil3Charge(); }
        }
      }

      //Whilst this is an uneven tooth pattern, if the specific angle between the last 2 teeth is specified, 1st deriv prediction can be used
      if( (configPage4.triggerFilter == 1) || (currentStatus.RPM < 1400) )
      {
        //Lite filter
        if( (toothCurrentCount == 1) || (toothCurrentCount == 3) || (toothCurrentCount == 5) || (toothCurrentCount == 7) || (toothCurrentCount == 9) || (toothCurrentCount == 11) )
        {
          if(configPage2.nCylinders == 4)
          {
            triggerToothAngle = 70;
            triggerFilterTime = curGap; //Trigger filter is set to whatever time it took to do 70 degrees (Next trigger is 110 degrees away)
          }
          else if(configPage2.nCylinders == 6)
          {
            triggerToothAngle = 70;
            triggerFilterTime = (curGap >> 2); //Trigger filter is set to (70/4)=17.5=17 degrees (Next trigger is 50 degrees away).
          }
        }
        else
        {
          if(configPage2.nCylinders == 4)
          {
            triggerToothAngle = 110;
            triggerFilterTime = rshift<3>(curGap * 3UL); //Trigger filter is set to (110*3)/8=41.25=41 degrees (Next trigger is 70 degrees away).
          }
          else if(configPage2.nCylinders == 6)
          {
            triggerToothAngle = 50;
            triggerFilterTime = curGap >> 1; //Trigger filter is set to 25 degrees (Next trigger is 70 degrees away).
          }
        }
      }
      else if(configPage4.triggerFilter == 2)
      {
        //Medium filter level
        if( (toothCurrentCount == 1) || (toothCurrentCount == 3) || (toothCurrentCount == 5) || (toothCurrentCount == 7) || (toothCurrentCount == 9) || (toothCurrentCount == 11) )
        { 
          triggerToothAngle = 70; 
          if(configPage2.nCylinders == 4)
          { 
            triggerFilterTime = (curGap * 5) >> 2 ; //87.5 degrees with a target of 110
          }
          else
          {
            triggerFilterTime = curGap >> 1 ; //35 degrees with a target of 50
          }
        } 
        else 
        { 
          if(configPage2.nCylinders == 4)
          { 
            triggerToothAngle = 110; 
            triggerFilterTime = (curGap >> 1); //55 degrees with a target of 70
          }
          else
          {
            triggerToothAngle = 50; 
            triggerFilterTime = (curGap * 3) >> 2; //Trigger filter is set to (50*3)/4=37.5=37 degrees (Next trigger is 70 degrees away).
          }
        } 
      }
      else if (configPage4.triggerFilter == 3)
      {
        //Aggressive filter level
        if( (toothCurrentCount == 1) || (toothCurrentCount == 3) || (toothCurrentCount == 5) || (toothCurrentCount == 7) || (toothCurrentCount == 9) || (toothCurrentCount == 11) )
        { 
          triggerToothAngle = 70; 
          if(configPage2.nCylinders == 4)
          { 
            triggerFilterTime = rshift<3>(curGap * 11UL);//96.26 degrees with a target of 110
          }
          else
          {
            triggerFilterTime = curGap >> 1 ; //35 degrees with a target of 50
          }
        } 
        else 
        { 
          if(configPage2.nCylinders == 4)
          { 
            triggerToothAngle = 110; 
            triggerFilterTime = rshift<5>(curGap * 9UL); //61.87 degrees with a target of 70
          }
          else
          {
            triggerToothAngle = 50; 
            triggerFilterTime = curGap; //50 degrees with a target of 70
          }
        } 
      }
      else
      {
        //trigger filter is turned off.
        triggerFilterTime = 0;
        if( (toothCurrentCount == 1) || (toothCurrentCount == 3) || (toothCurrentCount == 5) || (toothCurrentCount == 7) || (toothCurrentCount == 9) || (toothCurrentCount == 11) )
        { 
          if(configPage2.nCylinders == 4) { triggerToothAngle = 70; }
          else  { triggerToothAngle = 70; }
        } 
        else 
        { 
          if(configPage2.nCylinders == 4) { triggerToothAngle = 110; }
          else  { triggerToothAngle = 50; }
        }
      }

      //EXPERIMENTAL!
      //New ignition mode is ONLY available on 4g63 when the trigger angle is set to the stock value of 0.
      if( (configPage2.perToothIgn == true) && (configPage4.triggerAngle == 0) )
      {
        if( (configPage2.nCylinders == 4) && (currentStatus.advance > 0) )
        {
          int16_t crankAngle = ignitionLimits( toothAngles[(toothCurrentCount-1)] );

          //Handle non-sequential tooth counts 
          if( (configPage4.sparkMode != IGN_MODE_SEQUENTIAL) && (toothCurrentCount > configPage2.nCylinders) ) { checkPerToothTiming(crankAngle, (toothCurrentCount-configPage2.nCylinders) ); }
          else { checkPerToothTiming(crankAngle, toothCurrentCount); }
        }
      }
    } //Has sync
    else
    {
      triggerSecFilterTime = 0;
      //New secondary method of determining sync
      if(READ_PRI_TRIGGER() == true)
      {
        if(READ_SEC_TRIGGER() == true) { revolutionOne = true; }
        else { revolutionOne = false; }
      }
      else
      {
        if( (READ_SEC_TRIGGER() == false) && (revolutionOne == true) ) 
        { 
          //Crank is low, cam is low and the crank pulse STARTED when the cam was high. 
          if(configPage2.nCylinders == 4) { toothCurrentCount = 1; } //Means we're at 5* BTDC on a 4G63 4 cylinder
          //else if(configPage2.nCylinders == 6) { toothCurrentCount = 8; } 
        } 
        //If sequential is ever enabled, the below toothCurrentCount will need to change:
        else if( (READ_SEC_TRIGGER() == true) && (revolutionOne == true) ) 
        { 
          //Crank is low, cam is high and the crank pulse STARTED when the cam was high. 
          if(configPage2.nCylinders == 4) { toothCurrentCount = 5; } //Means we're at 5* BTDC on a 4G63 4 cylinder
          else if(configPage2.nCylinders == 6) { toothCurrentCount = 2; currentStatus.hasSync = true; } //Means we're at 45* ATDC on 6G72 6 cylinder
        } 
      }
    }
  } //Filter time

}
void triggerSec_4G63(void)
{
  //byte crankState = READ_PRI_TRIGGER();
  //First filter is a duration based one to ensure the pulse was of sufficient length (time)
  //if(READ_SEC_TRIGGER()) { secondaryLastToothTime1 = micros(); return; }
  if(currentStatus.hasSync == true)
  {
  //1166 is the time taken to cross 70 degrees at 10k rpm
  //if ( (micros() - secondaryLastToothTime1) < triggerSecFilterTime_duration ) { return; }
  //triggerSecFilterTime_duration = (micros() - secondaryLastToothTime1) >> 1;
  }


  curTime2 = micros();
  curGap2 = curTime2 - toothLastSecToothTime;
  if ( (curGap2 >= triggerSecFilterTime) )//|| (currentStatus.startRevolutions == 0) )
  {
    toothLastSecToothTime = curTime2;
    BIT_SET(decoderState, BIT_DECODER_VALID_TRIGGER); //Flag this pulse as being a valid trigger (ie that it passed filters)
    //addToothLogEntry(curGap, TOOTH_CAM_SECONDARY);

    triggerSecFilterTime = curGap2 >> 1; //Basic 50% filter for the secondary reading
    //More aggressive options:
    //62.5%:
    //triggerSecFilterTime = (curGap2 * 9) >> 5;
    //75%:
    //triggerSecFilterTime = (curGap2 * 6) >> 3;

    //if( (currentStatus.RPM < currentStatus.crankRPM) || (currentStatus.hasSync == false) )
    if( (currentStatus.hasSync == false) )
    {

      triggerFilterTime = 1500; //If this is removed, can have trouble getting sync again after the engine is turned off (but ECU not reset).
      triggerSecFilterTime = triggerSecFilterTime >> 1; //Divide the secondary filter time by 2 again, making it 25%. Only needed when cranking
      if(READ_PRI_TRIGGER() == true)
      {
        if(configPage2.nCylinders == 4)
        { 
          if(toothCurrentCount == 8) { currentStatus.hasSync = true; } //Is 8 for sequential, was 4
        }
        else if(configPage2.nCylinders == 6) 
        { 
          if(toothCurrentCount == 7) { currentStatus.hasSync = true; }
        }

      }
      else
      {
        if(configPage2.nCylinders == 4)
        { 
          if(toothCurrentCount == 5) { currentStatus.hasSync = true; } //Is 5 for sequential, was 1
        }
        //Cannot gain sync for 6 cylinder here. 
      }
    }

    //if ( (micros() - secondaryLastToothTime1) < triggerSecFilterTime_duration && configPage2.useResync )
    if ( (currentStatus.RPM < currentStatus.crankRPM) || (configPage4.useResync == 1) )
    {
      if( (currentStatus.hasSync == true) && (configPage2.nCylinders == 4) )
      {
        triggerSecFilterTime_duration = (micros() - secondaryLastToothTime1) >> 1;
        if(READ_PRI_TRIGGER() == true)
        {
          //Whilst we're cranking and have sync, we need to watch for noise pulses.
          if(toothCurrentCount != 8) 
          { 
            // This should never be true, except when there's noise
            currentStatus.hasSync = false; 
            currentStatus.syncLossCounter++;
          } 
          else { toothCurrentCount = 8; } //Why? Just why?
        }
      } //Has sync and 4 cylinder 
    } // Use resync or cranking
  } //Trigger filter
}


uint16_t getRPM_4G63(void)
{
  uint16_t tempRPM = 0;
  //During cranking, RPM is calculated 4 times per revolution, once for each rising/falling of the crank signal.
  //Because these signals aren't even (Alternating 110 and 70 degrees), this needs a special function
  if(currentStatus.hasSync == true)
  {
    if( (currentStatus.RPM < currentStatus.crankRPM)  )
    {
      int tempToothAngle;
      unsigned long toothTime;
      if( (toothLastToothTime == 0) || (toothLastMinusOneToothTime == 0) ) { tempRPM = 0; }
      else
      {
        noInterrupts();
        tempToothAngle = triggerToothAngle;
        toothTime = (toothLastToothTime - toothLastMinusOneToothTime); //Note that trigger tooth angle changes between 70 and 110 depending on the last tooth that was seen (or 70/50 for 6 cylinders)
        interrupts();
        toothTime = toothTime * 36;
        tempRPM = ((unsigned long)tempToothAngle * (MICROS_PER_MIN/10U)) / toothTime;
        SetRevolutionTime((10UL * toothTime) / tempToothAngle);
        MAX_STALL_TIME = 366667UL; // 50RPM
      }
    }
    else
    {
      tempRPM = stdGetRPM(CAM_SPEED);
      //EXPERIMENTAL! Add/subtract RPM based on the last rpmDOT calc
      //tempRPM += (micros() - toothOneTime) * currentStatus.rpmDOT
      MAX_STALL_TIME = revolutionTime << 1; //Set the stall time to be twice the current RPM. This is a safe figure as there should be no single revolution where this changes more than this
      if(MAX_STALL_TIME < 366667UL) { MAX_STALL_TIME = 366667UL; } //Check for 50rpm minimum
    }
  }

  return tempRPM;
}

int getCrankAngle_4G63(void)
{
    int crankAngle = 0;
    if(currentStatus.hasSync == true)
    {
      //This is the current angle ATDC the engine is at. This is the last known position based on what tooth was last 'seen'. It is only accurate to the resolution of the trigger wheel (Eg 36-1 is 10 degrees)
      unsigned long tempToothLastToothTime;
      int tempToothCurrentCount;
      //Grab some variables that are used in the trigger code and assign them to temp variables.
      noInterrupts();
      tempToothCurrentCount = toothCurrentCount;
      tempToothLastToothTime = toothLastToothTime;
      lastCrankAngleCalc = micros(); //micros() is no longer interrupt safe
      interrupts();

      crankAngle = toothAngles[(tempToothCurrentCount - 1)] + configPage4.triggerAngle; //Perform a lookup of the fixed toothAngles array to find what the angle of the last tooth passed was.

      //Estimate the number of degrees travelled since the last tooth}
      elapsedTime = (lastCrankAngleCalc - tempToothLastToothTime);
      crankAngle += timeToAngleIntervalTooth(elapsedTime);

      if (crankAngle >= 720) { crankAngle -= 720; }
      if (crankAngle < 0) { crankAngle += 360; }
    }
    return crankAngle;
}

void triggerSetEndTeeth_4G63(void)
{
  if(configPage2.nCylinders == 4)
  {
    if(configPage4.sparkMode == IGN_MODE_SEQUENTIAL) 
    { 
      ignition1EndTooth = 8;
      ignition2EndTooth = 2;
      ignition3EndTooth = 4;
      ignition4EndTooth = 6;
    }
    else
    {
      ignition1EndTooth = 4;
      ignition2EndTooth = 2;
      ignition3EndTooth = 4; //Not used
      ignition4EndTooth = 2;
    }
  }
  if(configPage2.nCylinders == 6)
  {
    if(configPage4.sparkMode == IGN_MODE_SEQUENTIAL) 
    { 
      //This should never happen as 6 cylinder sequential not supported
      ignition1EndTooth = 8;
      ignition2EndTooth = 2;
      ignition3EndTooth = 4;
      ignition4EndTooth = 6;
    }
    else
    {
      ignition1EndTooth = 6;
      ignition2EndTooth = 2;
      ignition3EndTooth = 4;
      ignition4EndTooth = 2; //Not used
    }
  }
}
/** @} */

/** GM 24X Decoder (eg early LS1 1996-2005).
Note: Useful references:
* 
- www.vems.hu/wiki/index.php?page=MembersPage%2FJorgenKarlsson%2FTwentyFourX

Provided that the cam signal is used, this decoder simply counts the teeth and then looks their angles up against a lookup table. The cam signal is used to determine tooth #1
* @defgroup dec_gm GM 24X
* @{
*/
void triggerSetup_24X(void)
{
  triggerToothAngle = 15; //The number of degrees that passes from tooth to tooth (primary)
  toothAngles[0] = 12;
  toothAngles[1] = 18;
  toothAngles[2] = 33;
  toothAngles[3] = 48;
  toothAngles[4] = 63;
  toothAngles[5] = 78;
  toothAngles[6] = 102;
  toothAngles[7] = 108;
  toothAngles[8] = 123;
  toothAngles[9] = 138;
  toothAngles[10] = 162;
  toothAngles[11] = 177;
  toothAngles[12] = 183;
  toothAngles[13] = 198;
  toothAngles[14] = 222;
  toothAngles[15] = 237;
  toothAngles[16] = 252;
  toothAngles[17] = 258;
  toothAngles[18] = 282;
  toothAngles[19] = 288;
  toothAngles[20] = 312;
  toothAngles[21] = 327;
  toothAngles[22] = 342;
  toothAngles[23] = 357;

  MAX_STALL_TIME = ((MICROS_PER_DEG_1_RPM/50U) * triggerToothAngle); //Minimum 50rpm. (3333uS is the time per degree at 50rpm)
  if(currentStatus.initialisationComplete == false) { toothCurrentCount = 25; toothLastToothTime = micros(); } //Set a startup value here to avoid filter errors when starting. This MUST have the init check to prevent the fuel pump just staying on all the time
  BIT_CLEAR(decoderState, BIT_DECODER_2ND_DERIV);
  BIT_SET(decoderState, BIT_DECODER_IS_SEQUENTIAL);
  BIT_SET(decoderState, BIT_DECODER_TOOTH_ANG_CORRECT);
  BIT_SET(decoderState, BIT_DECODER_HAS_SECONDARY);
}

void triggerPri_24X(void)
{
  if(toothCurrentCount == 25) { currentStatus.hasSync = false; } //Indicates sync has not been achieved (Still waiting for 1 revolution of the crank to take place)
  else
  {
    curTime = micros();
    curGap = curTime - toothLastToothTime;

    if(toothCurrentCount == 0)
    {
       toothCurrentCount = 1; //Reset the counter
       toothOneMinusOneTime = toothOneTime;
       toothOneTime = curTime;
       revolutionOne = !revolutionOne; //Sequential revolution flip
       currentStatus.hasSync = true;
       currentStatus.startRevolutions++; //Counter
       triggerToothAngle = 15; //Always 15 degrees for tooth #15
    }
    else
    {
      toothCurrentCount++; //Increment the tooth counter
      triggerToothAngle = toothAngles[(toothCurrentCount-1)] - toothAngles[(toothCurrentCount-2)]; //Calculate the last tooth gap in degrees
    }

    BIT_SET(decoderState, BIT_DECODER_VALID_TRIGGER); //Flag this pulse as being a valid trigger (ie that it passed filters)

    toothLastToothTime = curTime;


  }
}

void triggerSec_24X(void)
{
  toothCurrentCount = 0; //All we need to do is reset the tooth count back to zero, indicating that we're at the beginning of a new revolution
  revolutionOne = 1; //Sequential revolution reset
}

uint16_t getRPM_24X(void)
{
   return stdGetRPM(CRANK_SPEED);
}
int getCrankAngle_24X(void)
{
    //This is the current angle ATDC the engine is at. This is the last known position based on what tooth was last 'seen'. It is only accurate to the resolution of the trigger wheel (Eg 36-1 is 10 degrees)
    unsigned long tempToothLastToothTime;
    int tempToothCurrentCount, tempRevolutionOne;
    //Grab some variables that are used in the trigger code and assign them to temp variables.
    noInterrupts();
    tempToothCurrentCount = toothCurrentCount;
    tempToothLastToothTime = toothLastToothTime;
    tempRevolutionOne = revolutionOne;
    lastCrankAngleCalc = micros(); //micros() is no longer interrupt safe
    interrupts();

    int crankAngle;
    if (tempToothCurrentCount == 0) { crankAngle = 0 + configPage4.triggerAngle; } //This is the special case to handle when the 'last tooth' seen was the cam tooth. 0 is the angle at which the crank tooth goes high (Within 360 degrees).
    else { crankAngle = toothAngles[(tempToothCurrentCount - 1)] + configPage4.triggerAngle;} //Perform a lookup of the fixed toothAngles array to find what the angle of the last tooth passed was.

    //Estimate the number of degrees travelled since the last tooth}
    elapsedTime = (lastCrankAngleCalc - tempToothLastToothTime);
    crankAngle += timeToAngleDegPerMicroSec(elapsedTime);

    //Sequential check (simply sets whether we're on the first or 2nd revolution of the cycle)
    if (tempRevolutionOne == 1) { crankAngle += 360; }

    if (crankAngle >= 720) { crankAngle -= 720; }
    if (crankAngle < 0) { crankAngle += 360; }

    return crankAngle;
}

void triggerSetEndTeeth_24X(void)
{
}
/** @} */

/** Jeep 2000 - 24 crank teeth over 720 degrees, in groups of 4 ('91 to 2000 6 cylinder Jeep engines).
* Crank wheel is high for 360 crank degrees. Quite similar to the 24X setup.
* As we only need timing within 360 degrees, only 12 tooth angles are defined.
* Tooth number 1 represents the first tooth seen after the cam signal goes high.
* www.speeduino.com/forum/download/file.php?id=205
* @defgroup dec_jeep Jeep 2000 (6 cyl)
* @{
*/
void triggerSetup_Jeep2000(void)
{
  triggerToothAngle = 0; //The number of degrees that passes from tooth to tooth (primary)
  toothAngles[0] = 174;
  toothAngles[1] = 194;
  toothAngles[2] = 214;
  toothAngles[3] = 234;
  toothAngles[4] = 294;
  toothAngles[5] = 314;
  toothAngles[6] = 334;
  toothAngles[7] = 354;
  toothAngles[8] = 414;
  toothAngles[9] = 434;
  toothAngles[10] = 454;
  toothAngles[11] = 474;

  MAX_STALL_TIME = ((MICROS_PER_DEG_1_RPM/50U) * 60U); //Minimum 50rpm. (3333uS is the time per degree at 50rpm). Largest gap between teeth is 60 degrees.
  if(currentStatus.initialisationComplete == false) { toothCurrentCount = 13; toothLastToothTime = micros(); } //Set a startup value here to avoid filter errors when starting. This MUST have the initial check to prevent the fuel pump just staying on all the time
  BIT_CLEAR(decoderState, BIT_DECODER_2ND_DERIV);
  BIT_CLEAR(decoderState, BIT_DECODER_IS_SEQUENTIAL);
  BIT_SET(decoderState, BIT_DECODER_TOOTH_ANG_CORRECT);
  BIT_SET(decoderState, BIT_DECODER_HAS_SECONDARY);
}

void triggerPri_Jeep2000(void)
{
  if(toothCurrentCount == 13) { currentStatus.hasSync = false; } //Indicates sync has not been achieved (Still waiting for 1 revolution of the crank to take place)
  else
  {
    curTime = micros();
    curGap = curTime - toothLastToothTime;
    if ( curGap >= triggerFilterTime )
    {
      if(toothCurrentCount == 0)
      {
         toothCurrentCount = 1; //Reset the counter
         toothOneMinusOneTime = toothOneTime;
         toothOneTime = curTime;
         currentStatus.hasSync = true;
         currentStatus.startRevolutions++; //Counter
         triggerToothAngle = 60; //There are groups of 4 pulses (Each 20 degrees apart), with each group being 60 degrees apart. Hence #1 is always 60
      }
      else
      {
        toothCurrentCount++; //Increment the tooth counter
        triggerToothAngle = toothAngles[(toothCurrentCount-1)] - toothAngles[(toothCurrentCount-2)]; //Calculate the last tooth gap in degrees
      }

      setFilter(curGap); //Recalc the new filter value

      BIT_SET(decoderState, BIT_DECODER_VALID_TRIGGER); //Flag this pulse as being a valid trigger (ie that it passed filters)

      toothLastMinusOneToothTime = toothLastToothTime;
      toothLastToothTime = curTime;
    } //Trigger filter
  } //Sync check
}
void triggerSec_Jeep2000(void)
{
  toothCurrentCount = 0; //All we need to do is reset the tooth count back to zero, indicating that we're at the beginning of a new revolution
  return;
}

uint16_t getRPM_Jeep2000(void)
{
   return stdGetRPM(CRANK_SPEED);
}
int getCrankAngle_Jeep2000(void)
{
    //This is the current angle ATDC the engine is at. This is the last known position based on what tooth was last 'seen'. It is only accurate to the resolution of the trigger wheel (Eg 36-1 is 10 degrees)
    unsigned long tempToothLastToothTime;
    int tempToothCurrentCount;
    //Grab some variables that are used in the trigger code and assign them to temp variables.
    noInterrupts();
    tempToothCurrentCount = toothCurrentCount;
    tempToothLastToothTime = toothLastToothTime;
    lastCrankAngleCalc = micros(); //micros() is no longer interrupt safe
    interrupts();

    int crankAngle;
    if (toothCurrentCount == 0) { crankAngle = 114 + configPage4.triggerAngle; } //This is the special case to handle when the 'last tooth' seen was the cam tooth. Since  the tooth timings were taken on the previous crank tooth, the previous crank tooth angle is used here, not cam angle.
    else { crankAngle = toothAngles[(tempToothCurrentCount - 1)] + configPage4.triggerAngle;} //Perform a lookup of the fixed toothAngles array to find what the angle of the last tooth passed was.

    //Estimate the number of degrees travelled since the last tooth}
    elapsedTime = (lastCrankAngleCalc - tempToothLastToothTime);
    crankAngle += timeToAngleDegPerMicroSec(elapsedTime);

    if (crankAngle >= 720) { crankAngle -= 720; }
    if (crankAngle < 0) { crankAngle += 360; }

    return crankAngle;
}

void triggerSetEndTeeth_Jeep2000(void)
{
}
/** @} */

/** Audi with 135 teeth on the crank and 1 tooth on the cam.
* This is very similar to the dual wheel decoder, however due to the 135 teeth not dividing evenly into 360,
* only every 3rd crank tooth is used in calculating the crank angle. This effectively makes it a 45 tooth dual wheel setup.
* @defgroup dec_audi135 Audi 135
* @{
*/
void triggerSetup_Audi135(void)
{
  triggerToothAngle = 8; //135/3 = 45, 360/45 = 8 degrees every 3 teeth
  toothCurrentCount = UINT8_MAX; //Default value
  toothSystemCount = 0;
  triggerFilterTime = (unsigned long)(MICROS_PER_SEC / (MAX_RPM / 60U * 135UL)); //Trigger filter time is the shortest possible time (in uS) that there can be between crank teeth (ie at max RPM). Any pulses that occur faster than this time will be discarded as noise
  triggerSecFilterTime = (int)(MICROS_PER_SEC / (MAX_RPM / 60U * 2U)) / 2U; //Same as above, but fixed at 2 teeth on the secondary input and divided by 2 (for cam speed)
  MAX_STALL_TIME = ((MICROS_PER_DEG_1_RPM/50U) * triggerToothAngle); //Minimum 50rpm. (3333uS is the time per degree at 50rpm)
  BIT_CLEAR(decoderState, BIT_DECODER_2ND_DERIV);
  BIT_SET(decoderState, BIT_DECODER_IS_SEQUENTIAL);
  BIT_SET(decoderState, BIT_DECODER_TOOTH_ANG_CORRECT);
  BIT_SET(decoderState, BIT_DECODER_HAS_SECONDARY);
}

void triggerPri_Audi135(void)
{
   curTime = micros();
   curGap = curTime - toothSystemLastToothTime;
   if ( (curGap > triggerFilterTime) || (currentStatus.startRevolutions == 0) )
   {
     toothSystemCount++;

     if ( currentStatus.hasSync == false ) { toothLastToothTime = curTime; }
     else
     {
       if ( toothSystemCount >= 3 )
       {
         //We only proceed for every third tooth

         BIT_SET(decoderState, BIT_DECODER_VALID_TRIGGER); //Flag this pulse as being a valid trigger (ie that it passed filters)
         toothSystemLastToothTime = curTime;
         toothSystemCount = 0;
         toothCurrentCount++; //Increment the tooth counter

         if ( (toothCurrentCount == 1) || (toothCurrentCount > 45) )
         {
           toothCurrentCount = 1;
           toothOneMinusOneTime = toothOneTime;
           toothOneTime = curTime;
           revolutionOne = !revolutionOne;
           currentStatus.startRevolutions++; //Counter
         }

         setFilter(curGap); //Recalc the new filter value

         toothLastMinusOneToothTime = toothLastToothTime;
         toothLastToothTime = curTime;
       } //3rd tooth check
     } // Sync check
   } // Trigger filter
}

void triggerSec_Audi135(void)
{
  /*
  curTime2 = micros();
  curGap2 = curTime2 - toothLastSecToothTime;
  if ( curGap2 < triggerSecFilterTime ) { return; }
  toothLastSecToothTime = curTime2;
  */

  if( currentStatus.hasSync == false )
  {
    toothCurrentCount = 0;
    currentStatus.hasSync = true;
    toothSystemCount = 3; //Need to set this to 3 so that the next primary tooth is counted
  }
  else if (configPage4.useResync == 1) { toothCurrentCount = 0; toothSystemCount = 3; }
  else if ( (currentStatus.startRevolutions < 100) && (toothCurrentCount != 45) ) { toothCurrentCount = 0; }
  revolutionOne = 1; //Sequential revolution reset
}

uint16_t getRPM_Audi135(void)
{
   return stdGetRPM(CRANK_SPEED);
}

int getCrankAngle_Audi135(void)
{
    //This is the current angle ATDC the engine is at. This is the last known position based on what tooth was last 'seen'. It is only accurate to the resolution of the trigger wheel (Eg 36-1 is 10 degrees)
    unsigned long tempToothLastToothTime;
    int tempToothCurrentCount;
    bool tempRevolutionOne;
    //Grab some variables that are used in the trigger code and assign them to temp variables.
    noInterrupts();
    tempToothCurrentCount = toothCurrentCount;
    tempToothLastToothTime = toothLastToothTime;
    tempRevolutionOne = revolutionOne;
    lastCrankAngleCalc = micros(); //micros() is no longer interrupt safe
    interrupts();

    //Handle case where the secondary tooth was the last one seen
    if(tempToothCurrentCount == 0) { tempToothCurrentCount = 45; }

    int crankAngle = ((tempToothCurrentCount - 1) * triggerToothAngle) + configPage4.triggerAngle; //Number of teeth that have passed since tooth 1, multiplied by the angle each tooth represents, plus the angle that tooth 1 is ATDC. This gives accuracy only to the nearest tooth.
    
    //Estimate the number of degrees travelled since the last tooth}
    elapsedTime = (lastCrankAngleCalc - tempToothLastToothTime);
    crankAngle += timeToAngleDegPerMicroSec(elapsedTime);

    //Sequential check (simply sets whether we're on the first or 2nd revolution of the cycle)
    if (tempRevolutionOne) { crankAngle += 360; }

    if (crankAngle >= 720) { crankAngle -= 720; }
    if (crankAngle < 0) { crankAngle += CRANK_ANGLE_MAX; }

    return crankAngle;
}

void triggerSetEndTeeth_Audi135(void)
{
}
/** @} */
/** Honda D17 (1.7 liter 4 cyl SOHC).
* 
* @defgroup dec_honda_d17 Honda D17
* @{
*/
void triggerSetup_HondaD17(void)
{
  triggerToothAngle = 360 / 12; //The number of degrees that passes from tooth to tooth
  MAX_STALL_TIME = ((MICROS_PER_DEG_1_RPM/50U) * triggerToothAngle); //Minimum 50rpm. (3333uS is the time per degree at 50rpm)
  BIT_CLEAR(decoderState, BIT_DECODER_2ND_DERIV);
  BIT_CLEAR(decoderState, BIT_DECODER_IS_SEQUENTIAL);
  BIT_CLEAR(decoderState, BIT_DECODER_HAS_SECONDARY);
}

void triggerPri_HondaD17(void)
{
   lastGap = curGap;
   curTime = micros();
   curGap = curTime - toothLastToothTime;
   toothCurrentCount++; //Increment the tooth counter

   BIT_SET(decoderState, BIT_DECODER_VALID_TRIGGER); //Flag this pulse as being a valid trigger (ie that it passed filters)

   //
   if( (toothCurrentCount == 13) && (currentStatus.hasSync == true) )
   {
     toothCurrentCount = 0;
   }
   else if( (toothCurrentCount == 1) && (currentStatus.hasSync == true) )
   {
     toothOneMinusOneTime = toothOneTime;
     toothOneTime = curTime;
     currentStatus.startRevolutions++; //Counter

     toothLastMinusOneToothTime = toothLastToothTime;
     toothLastToothTime = curTime;
   }
   else
   {
     //13th tooth
     targetGap = (lastGap) >> 1; //The target gap is set at half the last tooth gap
     if ( curGap < targetGap) //If the gap between this tooth and the last one is less than half of the previous gap, then we are very likely at the magical 13th tooth
     {
       toothCurrentCount = 0;
       currentStatus.hasSync = true;
     }
     else
     {
       //The tooth times below don't get set on tooth 13(The magical 13th tooth should not be considered for any calculations that use those times)
       toothLastMinusOneToothTime = toothLastToothTime;
       toothLastToothTime = curTime;
     }
   }

}
void triggerSec_HondaD17(void) { return; } //The 4+1 signal on the cam is yet to be supported. If this ever changes, update BIT_DECODER_HAS_SECONDARY in the setup() function
uint16_t getRPM_HondaD17(void)
{
   return stdGetRPM(CRANK_SPEED);
}
int getCrankAngle_HondaD17(void)
{
    //This is the current angle ATDC the engine is at. This is the last known position based on what tooth was last 'seen'. It is only accurate to the resolution of the trigger wheel (Eg 36-1 is 10 degrees)
    unsigned long tempToothLastToothTime;
    int tempToothCurrentCount;
    //Grab some variables that are used in the trigger code and assign them to temp variables.
    noInterrupts();
    tempToothCurrentCount = toothCurrentCount;
    tempToothLastToothTime = toothLastToothTime;
    lastCrankAngleCalc = micros(); //micros() is no longer interrupt safe
    interrupts();

    //Check if the last tooth seen was the reference tooth 13 (Number 0 here). All others can be calculated, but tooth 3 has a unique angle
    int crankAngle;
    if( tempToothCurrentCount == 0 )
    {
      crankAngle = (11 * triggerToothAngle) + configPage4.triggerAngle; //if temptoothCurrentCount is 0, the last tooth seen was the 13th one. Based on this, ignore the 13th tooth and use the 12th one as the last reference.
    }
    else
    {
      crankAngle = ((tempToothCurrentCount - 1) * triggerToothAngle) + configPage4.triggerAngle; //Number of teeth that have passed since tooth 1, multiplied by the angle each tooth represents, plus the angle that tooth 1 is ATDC. This gives accuracy only to the nearest tooth.
    }

    //Estimate the number of degrees travelled since the last tooth}
    elapsedTime = (lastCrankAngleCalc - tempToothLastToothTime);
    crankAngle += timeToAngleDegPerMicroSec(elapsedTime);

    if (crankAngle >= 720) { crankAngle -= 720; }
    if (crankAngle < 0) { crankAngle += 360; }

    return crankAngle;
}

void triggerSetEndTeeth_HondaD17(void)
{
}

/** @} */
/** Honda J 32 (3.2 liter 6 cyl SOHC).
*  The Honda J32a4 (and all J series I'm aware of) has a crank trigger with nominal 24 teeth (22 teeth actually present). 
*  It has one missing tooth, then 7 teeth, then another missing tooth, then 15 teeth.
*  The tooth rising edges all have uniform spacing between them, except for teeth 14 and 22, which measure about
*  18 degrees between rising edges, rather than 15 degrees as the other teeth do.  These slightly larger
*  teeth are immediately before a gap, and the extra 3 degrees is made up for in the gap, the gap being about
*  3 degrees smaller than might be nominally expected, such that the expected rotational angle is restored immediately after
*  the gap (missing tooth) passes.  
*  Teeth are represented as 0V at the ECU, no teeth are represented as 5V.
*  Top dead center of cylinder number 1 occurs as we lose sight of (just pass) the first tooth in the string of 15 teeth
*  (this is a rising edge).
*  The second tooth in the string of 15 teeth is designated as tooth 1 in this code. This means that
*  when the interrupt for tooth 1 fires (as we just pass tooth 1), crank angle = 360/24 = 15 degrees.
*  It follows that the first tooth in the string of 7 teeth is tooth 16. 
* @defgroup dec_honda_j_32 Honda J 32
* @{
*/ 
void triggerSetup_HondaJ32(void)
{
  triggerToothAngle = 360 / 24; //The number of degrees that passes from tooth to tooth
  MAX_STALL_TIME = ((MICROS_PER_DEG_1_RPM/10U) * triggerToothAngle); //Minimum 50rpm. (3333uS is the time per degree at 50rpm)
  BIT_CLEAR(decoderState, BIT_DECODER_2ND_DERIV);
  BIT_CLEAR(decoderState, BIT_DECODER_IS_SEQUENTIAL);
  BIT_CLEAR(decoderState, BIT_DECODER_HAS_SECONDARY);

  // Filter (ignore) triggers that are faster than this.
  triggerFilterTime = (MICROS_PER_SEC / (MAX_RPM / 60 * 24));
  toothLastToothTime = 0;
  toothCurrentCount = 0;
  toothOneTime = 0;
  toothOneMinusOneTime = 0;
  lastGap = 0;
  revolutionOne = 0;
}

void triggerPri_HondaJ32(void)
{
  // This function is called only on rising edges, which occur as we lose sight of a tooth.
  // This function sets the following state variables for use in other functions:
  // toothLastToothTime, toothOneTime, revolutionOne (just toggles - not correct)
  curTime = micros();
  curGap = curTime - toothLastToothTime;
  toothLastToothTime = curTime;

  BIT_SET(decoderState, BIT_DECODER_VALID_TRIGGER); //Flag this pulse as being a valid trigger (ie that it passed filters)
  
  if (currentStatus.hasSync == true) // We have sync
  {
    toothCurrentCount++;

    if (toothCurrentCount == 25) { // handle rollover.  Normal sized tooth here
      toothCurrentCount = 1;
      toothOneMinusOneTime = toothOneTime;
      toothOneTime = curTime;
      currentStatus.startRevolutions++;
      SetRevolutionTime(toothOneTime - toothOneMinusOneTime);
    }
    else if (toothCurrentCount == 23 || toothCurrentCount == 15) // This is the first tooth after a missing tooth
    {
      toothCurrentCount++; // account for missing tooth
      if (curGap < (lastGap >> 1) * 3) // This should be a big gap, if we find it's not actually big, we lost sync
      {
        currentStatus.hasSync = false;
        toothCurrentCount=1;
      }
    }
    else if (toothCurrentCount != 14 && toothCurrentCount != 22)
    {
      // Teeth 14 and 22 are about 18 rather than 15 degrees so don't update last_gap with this unusual spacing
      lastGap = curGap;
    }
    // else toothCurrentCount == 14 or 22.  Take no further action. 
  }
  else // we do not have sync yet. While syncing, treat tooth 14 and 22 as normal teeth
  {
    if (curGap < (lastGap >> 1) * 3 || lastGap == 0){ // Regular tooth, lastGap == 0 at startup
      toothCurrentCount++;  // Increment teeth between gaps
      lastGap = curGap;
    }
    else { // First tooth after the missing tooth
      if (toothCurrentCount == 15) {  // 15 teeth since the gap before this, meaning we just passed the second gap and are synced
        currentStatus.hasSync = true;
        toothCurrentCount = 16;  // This so happens to be the tooth number of the first tooth in the string of 7 (where we are now)
        toothOneTime = curTime - (15 * lastGap); // Initialize tooth 1 times based on last gap width.
        toothOneMinusOneTime = toothOneTime - (24 * lastGap);
      }
      else{ // Unclear which gap we just passed. reset counter
        toothCurrentCount = 1;
      }
    }
  }
}

// There's currently no compelling reason to implement cam timing on the J32. (Have to do semi-sequential injection, wasted spark, there is no VTC on this engine, just VTEC)
void triggerSec_HondaJ32(void) 
{
  return;
} 

uint16_t getRPM_HondaJ32(void)
{
  return RpmFromRevolutionTimeUs(revolutionTime); // revolutionTime set by SetRevolutionTime()
}

int getCrankAngle_HondaJ32(void)
{
  // Returns values from 0 to 360.
  // Tooth 1 time occurs 360/24 degrees after TDC.
  // Teeth 14 and 22 are unusually sized (18 degrees), but the missing tooth is smaller (12 degrees), so this oddity only applies when toothCurrentCount = 14 || 22
  int crankAngle;
  uint16_t tempToothCurrentCount;
  noInterrupts();
    tempToothCurrentCount = toothCurrentCount;
    lastCrankAngleCalc = micros(); //micros() is no longer interrupt safe
    elapsedTime = lastCrankAngleCalc - toothLastToothTime;
  interrupts();

  if (tempToothCurrentCount == 14)
  {
    crankAngle = 213; // 13 teeth * 15 degrees/tooth + 18 degrees
  }
  else if (tempToothCurrentCount == 22)
  {
    crankAngle = 333; // 21 teeth * 15 degrees/tooth + 18 degrees
  }
  else
  {
    crankAngle = triggerToothAngle * tempToothCurrentCount;
  }
  crankAngle += timeToAngleDegPerMicroSec(elapsedTime) + configPage4.triggerAngle;

  if (crankAngle >= 720) { crankAngle -= 720; }
  if (crankAngle > CRANK_ANGLE_MAX) { crankAngle -= CRANK_ANGLE_MAX; }
  if (crankAngle < 0) { crankAngle += 360; }

  return crankAngle;
}

void triggerSetEndTeeth_HondaJ32(void)
{
  return;
}

/** @} */

/** Miata '99 to '05 with 4x 70 degree duration teeth running at cam speed.
Teeth believed to be at the same angles as the 4g63 decoder.
Tooth #1 is defined as the next crank tooth after the crank signal is HIGH when the cam signal is falling.
Tooth number one is at 355* ATDC.
* (See: www.forum.diyefi.org/viewtopic.php?f=56&t=1077)
* @defgroup miata_99_05 Miata '99 to '05
* @{
*/
void triggerSetup_Miata9905(void)
{
  triggerToothAngle = 90; //The number of degrees that passes from tooth to tooth (primary)
  toothCurrentCount = 99; //Fake tooth count represents no sync
  BIT_CLEAR(decoderState, BIT_DECODER_2ND_DERIV);
  BIT_SET(decoderState, BIT_DECODER_IS_SEQUENTIAL);
  triggerActualTeeth = 8;

  if(currentStatus.initialisationComplete == false) { secondaryToothCount = 0; toothLastToothTime = micros(); } //Set a startup value here to avoid filter errors when starting. This MUST have the initial check to prevent the fuel pump just staying on all the time
  else { toothLastToothTime = 0; }
  toothLastMinusOneToothTime = 0;

  //Note that these angles are for every rising and falling edge

  /*
  toothAngles[0] = 350;
  toothAngles[1] = 100;
  toothAngles[2] = 170;
  toothAngles[3] = 280;
  */

  toothAngles[0] = 710; //
  toothAngles[1] = 100; //First crank pulse after the SINGLE cam pulse
  toothAngles[2] = 170; //
  toothAngles[3] = 280; //
  toothAngles[4] = 350; //
  toothAngles[5] = 460; //First crank pulse AFTER the DOUBLE cam pulse
  toothAngles[6] = 530; //
  toothAngles[7] = 640; //

  MAX_STALL_TIME = ((MICROS_PER_DEG_1_RPM/50U) * triggerToothAngle); //Minimum 50rpm. (3333uS is the time per degree at 50rpm)
  triggerFilterTime = 1500; //10000 rpm, assuming we're triggering on both edges off the crank tooth.
  triggerSecFilterTime = 0; //Need to figure out something better for this
  BIT_SET(decoderState, BIT_DECODER_HAS_FIXED_CRANKING);
  BIT_SET(decoderState, BIT_DECODER_TOOTH_ANG_CORRECT);
  BIT_SET(decoderState, BIT_DECODER_HAS_SECONDARY);
}

void triggerPri_Miata9905(void)
{
  curTime = micros();
  curGap = curTime - toothLastToothTime;
  if ( (curGap >= triggerFilterTime) || (currentStatus.startRevolutions == 0) )
  {
    toothCurrentCount++;
    BIT_SET(decoderState, BIT_DECODER_VALID_TRIGGER); //Flag this pulse as being a valid trigger (ie that it passed filters)
    if( (toothCurrentCount == (triggerActualTeeth + 1)) )
    {
       toothCurrentCount = 1; //Reset the counter
       toothOneMinusOneTime = toothOneTime;
       toothOneTime = curTime;
       //currentStatus.hasSync = true;
       currentStatus.startRevolutions++; //Counter
    }
    else
    {
      if( (currentStatus.hasSync == false) || (configPage4.useResync == true) )
      {
        if(secondaryToothCount == 2)
        {
          toothCurrentCount = 6;
          currentStatus.hasSync = true;
        }
      }
    }

    if (currentStatus.hasSync == true)
    {

      //Whilst this is an uneven tooth pattern, if the specific angle between the last 2 teeth is specified, 1st deriv prediction can be used
      if( (configPage4.triggerFilter == 1) || (currentStatus.RPM < 1400) )
      {
        //Lite filter
        if( (toothCurrentCount == 1) || (toothCurrentCount == 3) || (toothCurrentCount == 5) || (toothCurrentCount == 7) ) { triggerToothAngle = 70; triggerFilterTime = curGap; } //Trigger filter is set to whatever time it took to do 70 degrees (Next trigger is 110 degrees away)
        else { triggerToothAngle = 110; triggerFilterTime = rshift<3>(curGap * 3UL); } //Trigger filter is set to (110*3)/8=41.25=41 degrees (Next trigger is 70 degrees away).
      }
      else if(configPage4.triggerFilter == 2)
      {
        //Medium filter level
        if( (toothCurrentCount == 1) || (toothCurrentCount == 3) || (toothCurrentCount == 5) || (toothCurrentCount == 7) ) { triggerToothAngle = 70; triggerFilterTime = (curGap * 5) >> 2 ; } //87.5 degrees with a target of 110
        else { triggerToothAngle = 110; triggerFilterTime = (curGap >> 1); } //55 degrees with a target of 70
      }
      else if (configPage4.triggerFilter == 3)
      {
        //Aggressive filter level
        if( (toothCurrentCount == 1) || (toothCurrentCount == 3) || (toothCurrentCount == 5) || (toothCurrentCount == 7) ) { triggerToothAngle = 70; triggerFilterTime = rshift<3>(curGap * 11UL) ; } //96.26 degrees with a target of 110
        else { triggerToothAngle = 110; triggerFilterTime = rshift<5>(curGap * 9UL); } //61.87 degrees with a target of 70
      }
      else if (configPage4.triggerFilter == 0)
      {
        //trigger filter is turned off.
        triggerFilterTime = 0;
        triggerSecFilterTime = 0;
        if( (toothCurrentCount == 1) || (toothCurrentCount == 3) || (toothCurrentCount == 5) || (toothCurrentCount == 7) ) { triggerToothAngle = 70; } //96.26 degrees with a target of 110
        else { triggerToothAngle = 110; }
      }

      //EXPERIMENTAL!
      //New ignition mode is ONLY available on 9905 when the trigger angle is set to the stock value of 0.
      if(    (configPage2.perToothIgn == true) 
          && (configPage4.triggerAngle == 0) 
          && (currentStatus.advance > 0) )
      {
        int16_t crankAngle = ignitionLimits( toothAngles[(toothCurrentCount-1)] );

        //Handle non-sequential tooth counts 
        if( (configPage4.sparkMode != IGN_MODE_SEQUENTIAL) && (toothCurrentCount > configPage2.nCylinders) ) { checkPerToothTiming(crankAngle, (toothCurrentCount-configPage2.nCylinders) ); }
        else { checkPerToothTiming(crankAngle, toothCurrentCount); }
      }
    } //Has sync

    toothLastMinusOneToothTime = toothLastToothTime;
    toothLastToothTime = curTime;

    //if ( BIT_CHECK(currentStatus.engine, BIT_ENGINE_CRANK) && configPage4.ignCranklock)
    if ( (currentStatus.RPM < (currentStatus.crankRPM + 30)) && (configPage4.ignCranklock) ) //The +30 here is a safety margin. When switching from fixed timing to normal, there can be a situation where a pulse started when fixed and ending when in normal mode causes problems. This prevents that.
    {
      if( (toothCurrentCount == 1) || (toothCurrentCount == 5) ) { endCoil1Charge(); endCoil3Charge(); }
      else if( (toothCurrentCount == 3) || (toothCurrentCount == 7) ) { endCoil2Charge(); endCoil4Charge(); }
    }
    secondaryToothCount = 0;
  } //Trigger filter

}

void triggerSec_Miata9905(void)
{
  curTime2 = micros();
  curGap2 = curTime2 - toothLastSecToothTime;

  if(BIT_CHECK(currentStatus.engine, BIT_ENGINE_CRANK) || (currentStatus.hasSync == false) )
  {
    triggerFilterTime = 1500; //If this is removed, can have trouble getting sync again after the engine is turned off (but ECU not reset).
  }

  if ( curGap2 >= triggerSecFilterTime )
  {
    toothLastSecToothTime = curTime2;
    lastGap = curGap2;
    secondaryToothCount++;

    //TODO Add some secondary filtering here

    //Record the VVT tooth time
    if( (toothCurrentCount == 1) && (curTime2 > toothLastToothTime) )
    {
      lastVVTtime = curTime2 - toothLastToothTime;
    }
  }
}

uint16_t getRPM_Miata9905(void)
{
  //During cranking, RPM is calculated 4 times per revolution, once for each tooth on the crank signal.
  //Because these signals aren't even (Alternating 110 and 70 degrees), this needs a special function
  uint16_t tempRPM = 0;
  if( (currentStatus.RPM < currentStatus.crankRPM) && (currentStatus.hasSync == true) )
  {
    if( (toothLastToothTime == 0) || (toothLastMinusOneToothTime == 0) ) { tempRPM = 0; }
    else
    {
      int tempToothAngle;
      unsigned long toothTime;
      noInterrupts();
      tempToothAngle = triggerToothAngle;
      toothTime = (toothLastToothTime - toothLastMinusOneToothTime); //Note that trigger tooth angle changes between 70 and 110 depending on the last tooth that was seen
      interrupts();
      toothTime = toothTime * 36;
      tempRPM = ((unsigned long)tempToothAngle * (MICROS_PER_MIN/10U)) / toothTime;
      SetRevolutionTime((10UL * toothTime) / tempToothAngle);
      MAX_STALL_TIME = 366667UL; // 50RPM
    }
  }
  else
  {
    tempRPM = stdGetRPM(CAM_SPEED);
    MAX_STALL_TIME = revolutionTime << 1; //Set the stall time to be twice the current RPM. This is a safe figure as there should be no single revolution where this changes more than this
    if(MAX_STALL_TIME < 366667UL) { MAX_STALL_TIME = 366667UL; } //Check for 50rpm minimum
  }

  return tempRPM;
}

int getCrankAngle_Miata9905(void)
{
    int crankAngle = 0;
    //if(currentStatus.hasSync == true)
    {
      //This is the current angle ATDC the engine is at. This is the last known position based on what tooth was last 'seen'. It is only accurate to the resolution of the trigger wheel (Eg 36-1 is 10 degrees)
      unsigned long tempToothLastToothTime;
      int tempToothCurrentCount;
      //Grab some variables that are used in the trigger code and assign them to temp variables.
      noInterrupts();
      tempToothCurrentCount = toothCurrentCount;
      tempToothLastToothTime = toothLastToothTime;
      lastCrankAngleCalc = micros(); //micros() is no longer interrupt safe
      interrupts();

      crankAngle = toothAngles[(tempToothCurrentCount - 1)] + configPage4.triggerAngle; //Perform a lookup of the fixed toothAngles array to find what the angle of the last tooth passed was.

      //Estimate the number of degrees travelled since the last tooth}
      elapsedTime = (lastCrankAngleCalc - tempToothLastToothTime);
      crankAngle += timeToAngleDegPerMicroSec(elapsedTime);

      if (crankAngle >= 720) { crankAngle -= 720; }
      if (crankAngle < 0) { crankAngle += 360; }
    }

    return crankAngle;
}

int getCamAngle_Miata9905(void)
{
  int16_t curAngle;
  //lastVVTtime is the time between tooth #1 (10* BTDC) and the single cam tooth. 
  //All cam angles in in BTDC, so the actual advance angle is 370 - timeToAngleDegPerMicroSec(lastVVTtime) - <the angle of the cam at 0 advance>
  curAngle = 370 - timeToAngleDegPerMicroSec(lastVVTtime) - configPage10.vvtCL0DutyAng;
  currentStatus.vvt1Angle = LOW_PASS_FILTER( (curAngle << 1), configPage4.ANGLEFILTER_VVT, currentStatus.vvt1Angle);

  return currentStatus.vvt1Angle;
}

void triggerSetEndTeeth_Miata9905(void)
{

  if(configPage4.sparkMode == IGN_MODE_SEQUENTIAL) 
  { 
    if(currentStatus.advance >= 10)
    {
      ignition1EndTooth = 8;
      ignition2EndTooth = 2;
      ignition3EndTooth = 4;
      ignition4EndTooth = 6;
    }
    else if (currentStatus.advance > 0)
    {
      ignition1EndTooth = 1;
      ignition2EndTooth = 3;
      ignition3EndTooth = 5;
      ignition4EndTooth = 7;
    }
    
  }
  else
  {
    if(currentStatus.advance >= 10)
    {
      ignition1EndTooth = 4;
      ignition2EndTooth = 2;
      ignition3EndTooth = 4; //Not used
      ignition4EndTooth = 2; //Not used
    }
    else if(currentStatus.advance > 0)
    {
      ignition1EndTooth = 1;
      ignition2EndTooth = 3;
      ignition3EndTooth = 1; //Not used
      ignition4EndTooth = 3; //Not used
    }
  }
}
/** @} */

/** Mazda AU version.
Tooth #2 is defined as the next crank tooth after the single cam tooth.
Tooth number one is at 348* ATDC.
* @defgroup mazda_au Mazda AU
* @{
*/
void triggerSetup_MazdaAU(void)
{
  triggerToothAngle = 108; //The number of degrees that passes from tooth to tooth (primary). This is the maximum gap
  toothCurrentCount = 99; //Fake tooth count represents no sync
  secondaryToothCount = 0; //Needed for the cam tooth tracking
  BIT_CLEAR(decoderState, BIT_DECODER_2ND_DERIV);
  BIT_SET(decoderState, BIT_DECODER_IS_SEQUENTIAL);

  toothAngles[0] = 348; //tooth #1
  toothAngles[1] = 96; //tooth #2
  toothAngles[2] = 168; //tooth #3
  toothAngles[3] = 276; //tooth #4

  MAX_STALL_TIME = ((MICROS_PER_DEG_1_RPM/50U) * triggerToothAngle); //Minimum 50rpm. (3333uS is the time per degree at 50rpm)
  triggerFilterTime = 1500; //10000 rpm, assuming we're triggering on both edges off the crank tooth.
  triggerSecFilterTime = (int)(MICROS_PER_SEC / (MAX_RPM / 60U * 2U)) / 2U; //Same as above, but fixed at 2 teeth on the secondary input and divided by 2 (for cam speed)
  BIT_SET(decoderState, BIT_DECODER_HAS_FIXED_CRANKING);
  BIT_SET(decoderState, BIT_DECODER_HAS_SECONDARY);
}

void triggerPri_MazdaAU(void)
{
  curTime = micros();
  curGap = curTime - toothLastToothTime;
  if ( curGap >= triggerFilterTime )
  {
    BIT_SET(decoderState, BIT_DECODER_VALID_TRIGGER); //Flag this pulse as being a valid trigger (ie that it passed filters)

    toothCurrentCount++;
    if( (toothCurrentCount == 1) || (toothCurrentCount == 5) ) //Trigger is on CHANGE, hence 4 pulses = 1 crank rev
    {
       toothCurrentCount = 1; //Reset the counter
       toothOneMinusOneTime = toothOneTime;
       toothOneTime = curTime;
       currentStatus.hasSync = true;
       currentStatus.startRevolutions++; //Counter
    }

    if (currentStatus.hasSync == true)
    {
      // Locked cranking timing is available, fixed at 12* BTDC
      if ( BIT_CHECK(currentStatus.engine, BIT_ENGINE_CRANK) && configPage4.ignCranklock )
      {
        if( toothCurrentCount == 1 ) { endCoil1Charge(); }
        else if( toothCurrentCount == 3 ) { endCoil2Charge(); }
      }

      //Whilst this is an uneven tooth pattern, if the specific angle between the last 2 teeth is specified, 1st deriv prediction can be used
      if( (toothCurrentCount == 1) || (toothCurrentCount == 3) ) { triggerToothAngle = 72; triggerFilterTime = curGap; } //Trigger filter is set to whatever time it took to do 72 degrees (Next trigger is 108 degrees away)
      else { triggerToothAngle = 108; triggerFilterTime = rshift<3>(curGap * 3UL); } //Trigger filter is set to (108*3)/8=40 degrees (Next trigger is 70 degrees away).

      toothLastMinusOneToothTime = toothLastToothTime;
      toothLastToothTime = curTime;
    } //Has sync
  } //Filter time
}
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
