mstevanin4/ECU_STM_V1/STM2_ECU/SW/ECU_SW/Thunderstorm_Trunk/speeduino_202501_4/speeduino/globals.h

/** @file
 * Global defines, macros, struct definitions (@ref statuses, @ref config2, @ref config4, config*), extern-definitions (for globally accessible vars).
 * 
 * ### Note on configuration struct layouts
 * 
 * Once the struct members have been assigned to certain "role" (in certain SW version), they should not be "moved around"
 * as the structs are stored onto EEPROM as-is and the offset and size of member needs to remain constant. Also removing existing struct members
 * would disturb layouts. Because of this a certain amount unused old members will be left into the structs. For the storage related reasons also the
 * bit fields are defined in byte-size (or multiple of ...) chunks.
 * 
 * ### Config Structs and 2D, 3D Tables
 * 
 * The config* structures contain information coming from tuning SW (e.g. TS) for 2D and 3D tables, where looked up value is not a result of direct
 * array lookup, but from interpolation algorithm. Because of standard, reusable interpolation routines associated with structs table2D and table3D,
 * the values from config are copied from config* structs to table2D (table3D destined configurations are not stored in config* structures).
 * 
 * ### Board choice
 * There's a C-preprocessor based "#if defined" logic present in this header file based on the Arduino IDE compiler set CPU
 * (+board?) type, e.g. `__AVR_ATmega2560__`. This respectively drives (withi it's "#if defined ..." block):
 * - The setting of various BOARD_* C-preprocessor variables (e.g. BOARD_MAX_ADC_PINS)
 * - Setting of BOARD_H (Board header) file (e.g. "board_avr2560.h"), which is later used to include the header file
 *   - Seems Arduino ide implicitly compiles and links respective .ino file (by it's internal build/compilation rules) (?)
 * - Setting of CPU (?) CORE_* variables (e.g. CORE_AVR), that is used across codebase to distinguish CPU.
 */
#ifndef GLOBALS_H
#define GLOBALS_H
#include <Arduino.h>
#include <SimplyAtomic.h>
#include "table2d.h"
#include "table3d.h"
#include "src/FastCRC/FastCRC.h"

#if defined(__AVR_ATmega1280__) || defined(__AVR_ATmega2560__) || defined(__AVR_ATmega2561__)
  #define BOARD_MAX_DIGITAL_PINS 54 //digital pins +1
  #define BOARD_MAX_IO_PINS 70 //digital pins + analog channels + 1
  #define BOARD_MAX_ADC_PINS  15 //Number of analog pins
  #ifndef LED_BUILTIN
    #define LED_BUILTIN 13
  #endif
  #define CORE_AVR
  #define BOARD_H "board_avr2560.h"
  #ifndef INJ_CHANNELS
    #define INJ_CHANNELS 4
  #endif
  #ifndef IGN_CHANNELS
    #define IGN_CHANNELS 5
  #endif

  #if defined(__AVR_ATmega2561__)
    //This is a workaround to avoid having to change all the references to higher ADC channels. We simply define the channels (Which don't exist on the 2561) as being the same as A0-A7
    //These Analog inputs should never be used on any 2561 board definition (Because they don't exist on the MCU), so it will not cause any issues
    #define A8  A0
    #define A9  A1
    #define A10  A2
    #define A11  A3
    #define A12  A4
    #define A13  A5
    #define A14  A6
    #define A15  A7
  #endif

  //#define TIMER5_MICROS

#elif defined(CORE_TEENSY)
  #if defined(__MK64FX512__) || defined(__MK66FX1M0__)
    #define CORE_TEENSY35
    #define BOARD_H "board_teensy35.h"
  #elif defined(__IMXRT1062__)
    #define CORE_TEENSY41
    #define BOARD_H "board_teensy41.h"
  #endif
  #define INJ_CHANNELS 8
  #define IGN_CHANNELS 8

#elif defined(STM32_MCU_SERIES) || defined(ARDUINO_ARCH_STM32) || defined(STM32)
  #define BOARD_H "board_stm32_official.h"
  #define CORE_STM32

  #define BOARD_MAX_ADC_PINS  NUM_ANALOG_INPUTS-1 //Number of analog pins from core.
  #if defined(STM32F407xx) //F407 can do 8x8 STM32F401/STM32F411 don't
   #define INJ_CHANNELS 8
   #define IGN_CHANNELS 8
  #else
   #define INJ_CHANNELS 4
   #define IGN_CHANNELS 5
  #endif
#elif defined(__SAMD21G18A__)
  #define BOARD_H "board_samd21.h"
  #define CORE_SAMD21
  #define CORE_SAM
  #define INJ_CHANNELS 4
  #define IGN_CHANNELS 4
#elif defined(__SAMC21J18A__)
  #define BOARD_H "board_samc21.h"
  #define CORE_SAMC21
  #define CORE_SAM
#elif defined(__SAME51J19A__)
  #define BOARD_H "board_same51.h"
  #define CORE_SAME51
  #define CORE_SAM
  #define INJ_CHANNELS 8
  #define IGN_CHANNELS 8
#else
  #error Incorrect board selected. Please select the correct board (Usually Mega 2560) and upload again
#endif

//This can only be included after the above section
#include BOARD_H //Note that this is not a real file, it is defined in globals.h. 

//Handy bitsetting macros
#define BIT_SET(a,b) ((a) |= (1U<<(b)))
#define BIT_CLEAR(a,b) ((a) &= ~(1U<<(b)))
#define BIT_CHECK(var,pos) !!((var) & (1U<<(pos)))
#define BIT_TOGGLE(var,pos) ((var)^= 1UL << (pos))
#define BIT_WRITE(var, pos, bitvalue) ((bitvalue) ? BIT_SET((var), (pos)) : bitClear((var), (pos)))

#define CRANK_ANGLE_MAX (max(CRANK_ANGLE_MAX_IGN, CRANK_ANGLE_MAX_INJ))

#define interruptSafe(c) (noInterrupts(); {c} interrupts();) //Wraps any code between nointerrupt and interrupt calls

#define MICROS_PER_SEC INT32_C(1000000)
#define MICROS_PER_MIN INT32_C(MICROS_PER_SEC*60U)
#define MICROS_PER_HOUR INT32_C(MICROS_PER_MIN*60U)

#define SERIAL_PORT_PRIMARY   0
#define SERIAL_PORT_SECONDARY 3

//Define the load algorithm
#define LOAD_SOURCE_MAP         0
#define LOAD_SOURCE_TPS         1
#define LOAD_SOURCE_IMAPEMAP    2
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
