mstevanin4/ECU_STM_V1/(commit log)

2018-04-17 commit HW as produced
    First 10 units produced, this is the HW side of the project at first production
    [AnalogInputs.sch, BOM_STM2_pcbcart.xls, BOM_SZ2U.xls, BattRefVolt.sch, BlueTooth.sch, CanBus.sch, Connectors.sch, CrkCam.sch]
2018-04-26 improvement of silkcreen references position for manufacturer
    [STM2_ECU-B.Adhes.gbr, STM2_ECU-B.CrtYd.gbr, STM2_ECU-B.Cu.gbr, STM2_ECU-B.Fab.gbr, STM2_ECU-B.Mask.gbr, STM2_ECU-B.Paste.gbr, STM2_ECU-Edge.Cuts.gbr, STM2_ECU-F.Adhes.gbr]
2018-05-02 add two projects of embedded SW (ECU engine and TestBench) and 2 tunerstudio projects (ECU engine and TestBench)
    [Bom-pcbng.csv, Bom-seeedstudio-v3.csv, Bom-seeedstudio.csv, Bom-template-0.4.4.csv, Bom-template-0.4.4_ITEAD.xls, Bom-template-0.4.4_seeed.csv, Bom-template-MX5-PNP_ITEAD Beta 1.xls, Bom-template-MX5-PNP_ITEAD Beta 2.xls]
2018-05-09 Add April18 update and create my one branch ThunderStorm_ECU_Eng
    [Bom-pcbng.csv, Bom-seeedstudio-v3.csv, Bom-seeedstudio.csv, Bom-template-0.4.4.csv, Bom-template-0.4.4_ITEAD.xls, Bom-template-0.4.4_seeed.csv, Bom-template-ITEAD.xls, Bom-template-MX5-PNP_ITEAD Beta 1.xls]
2018-06-10 First working setup for testbench
    Mass on cell is accurate within TunerStudio But calculated Torque looks like overflows
2018-08-09 commit addd global repo
    [BOM_SZ2U.xls, Bom-pcbng.csv, Bom-seeedstudio-v3.csv, Bom-seeedstudio.csv, Bom-template-0.4.4.csv, Bom-template-0.4.4_ITEAD.xls, Bom-template-0.4.4_seeed.csv, Bom-template-ITEAD.xls]
2018-08-10 new output PWM at High frequency on LED and on IGN6
2018-08-10 after test working setup, filter might be remove after spd hardware repair
2018-08-11 EngSpdSp ramp added filter on speed removed not tested
2018-10-11 Add a marketing flyer to project
    [power curve.xlsx]
2019-10-22 Repo clean up and add Trunk repo
    [Bom-pcbng.csv, Bom-seeedstudio-v3.csv, Bom-seeedstudio.csv, Bom-template-0.4.4.csv, Bom-template-0.4.4_ITEAD.xls, Bom-template-0.4.4_seeed.csv, Bom-template-ITEAD.xls, Bom-template-MX5-PNP_ITEAD Beta 1.xls]
2020-08-28 change to PID close loop
2020-08-31 ädd fuel pressure signal and gauge
2020-08-31 Add oil pressure in bar and replace Kpa by Bar for fuel pressure
    [micro_to_mega_pinout.xlsx]
2021-03-10 bug fix fuelpressure in ini file
    [ECU_STM_202103.ini]
2021-03-11 Update init.ino to support stepper motor as well as pwm valve
2024-08-07 before SW202402
    [BOM_SZ2U.xls, RX8CanBus20-05-2020.xlsx, WBABK72020ET52358_26.03.2024_104324_log.csv, WBABK72020ET52358_26.03.2024_104513_log.csv, WBABK72020ET52358_26.03.2024_104548_log.csv, WBABK72020ET52358_26.03.2024_112452_log.csv, WBABK72020ET52358_26.03.2024_112537_log.csv, WBABK72020ET52358_26.03.2024_113602_log.csv]
