mstevanin4/ECU_STM_V1/(notices)

Notices in the files:
STM2_ECU/SW/ECU_SW/Thunderstorm_Trunk/speeduino_2021/speeduino.ino:
modify it under the terms of the GNU General Public License
